PI2-Grupo-8/Estruturas/README.md

# Estruturas
Repositório geral para os arquivos referentes ao subgrupo de Estruturas
