PI2-Grupo-8/Estruturas/Desenhos tecnicos/1 - Vista explodida geral.docx

| Titulo: Vista Explodida Completa | Des.nº: 1/36
| Modelo 3D: André N. Delgado
Brasília – DF | Detalhamento: André N. Delgado | Escala: 1:25
A4 | Revisão: Fernando B. V. Mendes | Unidade: mm
Data: 11/09/2021 | Mat.: | Peso: 100 kg

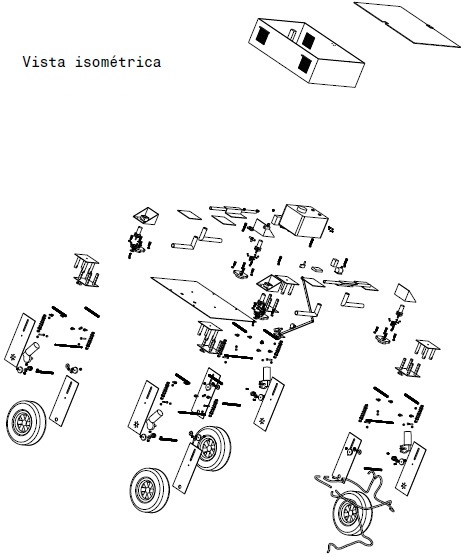
[picture p1: figure]
