PI2-Grupo-8/Estruturas/Desenhos tecnicos/13- Placa conex.docx

| Título: Suporte motor superior e rolamento de mancal | Des.nº: 13 /36
| Modelo 3D: André N. Delgado
Brasília – DF | Detalhamento: André N. Delgado | Escala: 1:3
A4 | Revisão: Fernando B. V. Mendes | Unidade: mm
Data: 08/09/2021 | Mat.: Aço 1020 | Peso: 1,085 kg

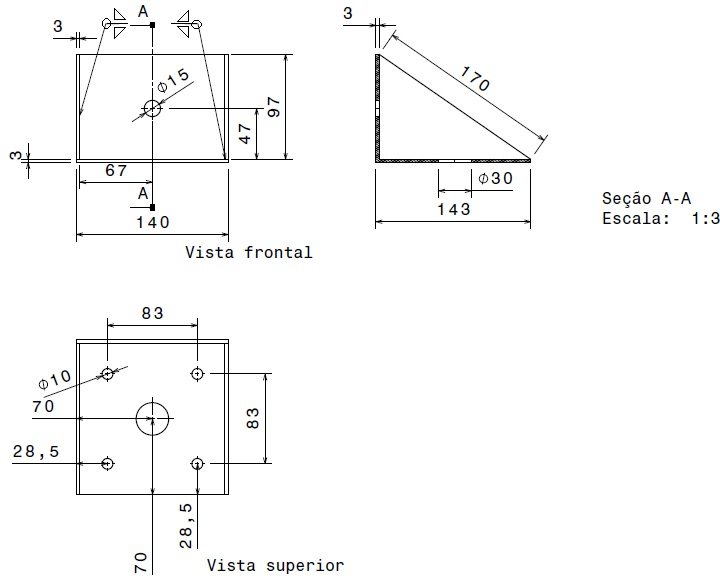
[picture p2: figure]
