PI2-Grupo-8/Estruturas/Desenhos tecnicos/14 - Suporte do motor superiro.docx

| Título: Suporte do motor superior | Des.nº: 14 /36
| Modelo 3D: André N. Delgado
Brasília – DF | Detalhamento: André N. Delgado | Escala: 1:1
A4 | Revisão: Fernando B. V. Mendes | Unidade: mm
Data: 08/09/2021 | Mat.: Aço 1020 | Peso: 63 g

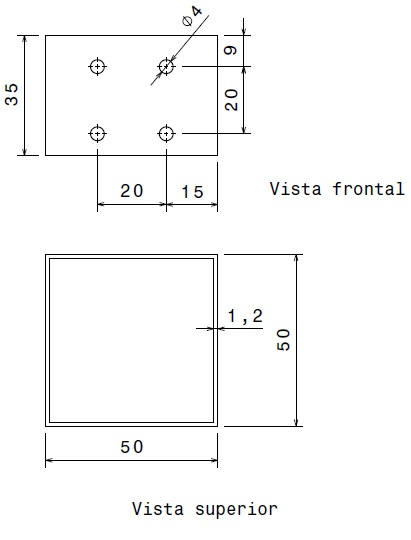
[picture p3: figure]
