PI2-Grupo-8/Estruturas/Desenhos tecnicos/19- Suporte novo externo.docx

| Título: Suporte da roda e motor (lado externo) | Des.nº: 19/36
| Modelo 3D: André N. Delgado
Brasília – DF | Detalhamento: André N. Delgado | Escala: 1:3
A4 | Revisão: Fernando B. V. Mendes | Unidade: mm
Data: 08/09/2021 | Mat.: Aço 1020 | Peso: 1,647 kg

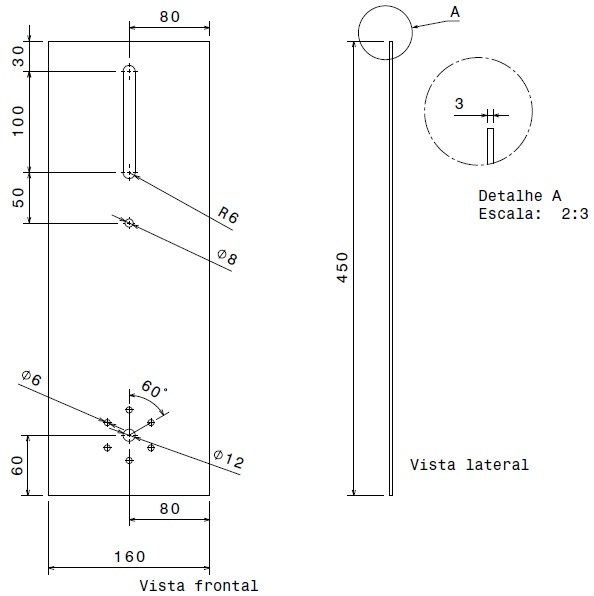
[picture p4: figure]
