PI2-Grupo-8/Estruturas/Desenhos tecnicos/20- Suporte novo interno.docx

| Título: Suporte da roda (lado interno) | Des.nº: 20/36
| Modelo 3D: André N. Delgado
Brasília – DF | Detalhamento: André N. Delgado | Escala: 1:3
A4 | Revisão: Fernando B. V. Mendes | Unidade: mm
Data: 08/09/2021 | Mat.: Aço 1020 | Peso: 1,538 kg

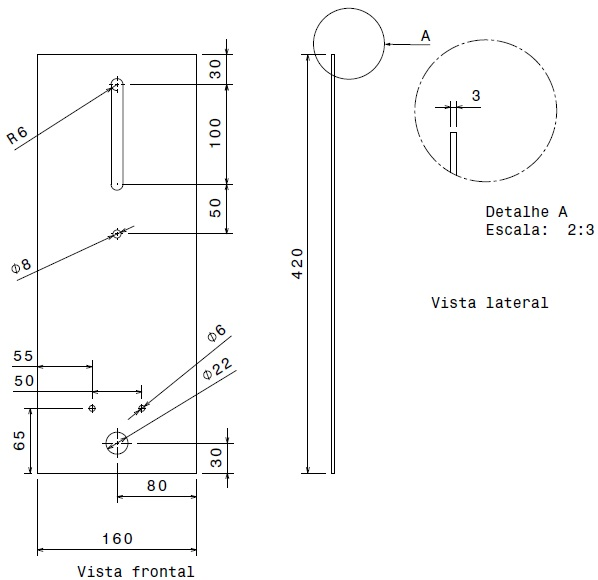
[picture p6: figure]
