PI2-Grupo-8/Estruturas/Desenhos tecnicos/25 - Chapa de fixação da valvula solenoide.docx

| Título: Chapa de fixação da válvula solenoide | Des.nº: 25/36
| Modelo 3D: André N. Delgado
Brasília – DF | Detalhamento: André N. Delgado | Escala: 1:1
A4 | Revisão: Fernando B. V. Mendes | Unidade: mm
Data: 08/09/2021 | Mat.: Aço 1020 | Peso: 9 g

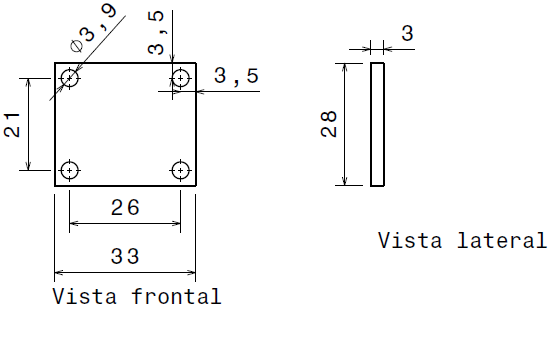
[picture p7: figure]
