PI2-Grupo-8/Estruturas/Desenhos tecnicos/27 - Case das baterias (base).docx

| Título: Case das baterias (base) | Des.nº: 27/36
| Modelo 3D: André N. Delgado
Brasília – DF | Detalhamento: André N. Delgado | Escala: 1:3
A4 | Revisão: Fernando B. V. Mendes | Unidade: mm
Data: 30/09/2021 | Mat.: Nylon | Peso: 418 g

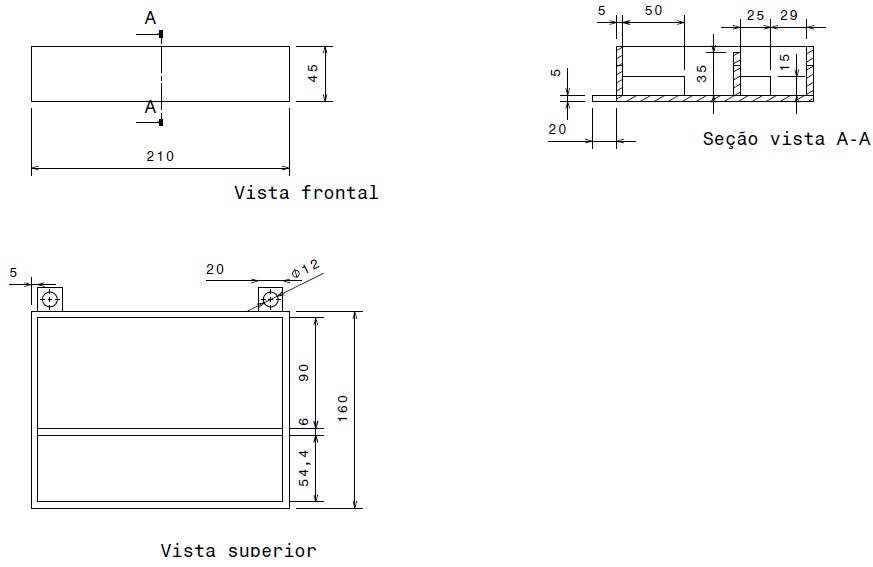
[picture p8: figure]
