PI2-Grupo-8/Estruturas/Desenhos tecnicos/28 - Case das baterias (tampa).docx

| Título: Case das baterias (tampa) | Des.nº: 28/36
| Modelo 3D: André N. Delgado
Brasília – DF | Detalhamento: André N. Delgado | Escala: 1:3
A4 | Revisão: Fernando B. V. Mendes | Unidade: mm
Data: 02/10/2021 | Mat.: Nylon | Peso: 227 g

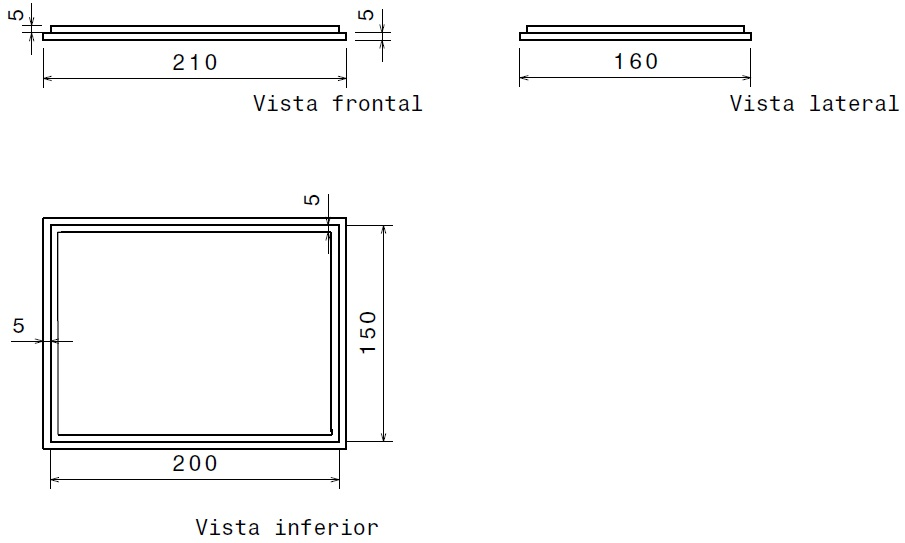
[picture p9: figure]
