PI2-Grupo-8/Estruturas/Desenhos tecnicos/29 - Capa do sensor ultrassônico (base).docx

| Título: Capa do sensor ultrassônico (base) | Des.nº: 29/36
| Modelo 3D: André N. Delgado
Brasília – DF | Detalhamento: André N. Delgado | Escala: 1:1
A4 | Revisão: Fernando B. V. Mendes | Unidade: mm
Data: 02/10/2021 | Mat.: Nylon | Peso: 16 g

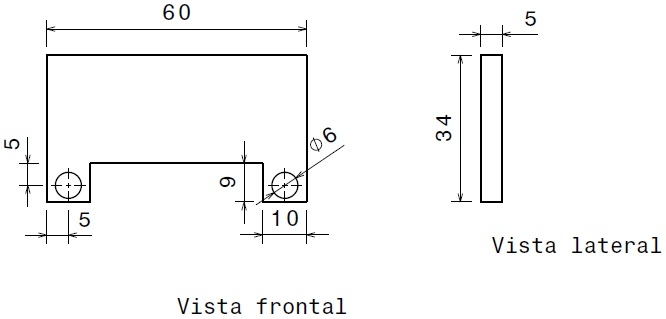
[picture p10: figure]
