PI2-Grupo-8/Estruturas/Desenhos tecnicos/30 - Capa do sensor ultrassônico (tampa).docx

| Título: Capa do sensor ultrassônico (tampa) | Des.nº: 30/36
| Modelo 3D: André N. Delgado
Brasília – DF | Detalhamento: André N. Delgado | Escala: 1:1
A4 | Revisão: Fernando B. V. Mendes | Unidade: mm
Data: 02/10/2021 | Mat.: Nylon | Peso: 3 g

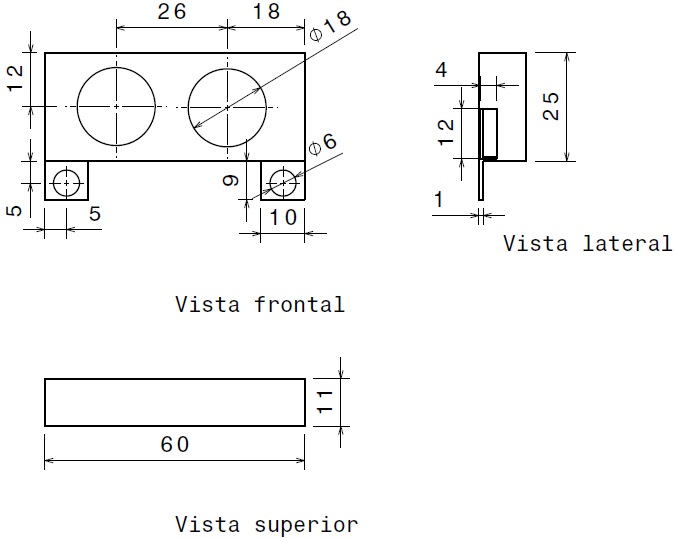
[picture p12: figure]
