PI2-Grupo-8/Estruturas/Desenhos tecnicos/35 - Capa do motor superior.docx

| Título: Capa do motor superior | Des.nº: 35/36
| Modelo 3D: André N. Delgado
Brasília – DF | Detalhamento: André N. Delgado | Escala: 1:3
A4 | Revisão: Fernando B. V. Mendes | Unidade: mm
Data: 07/10/2021 | Mat.: Nylon | Peso: 6 g

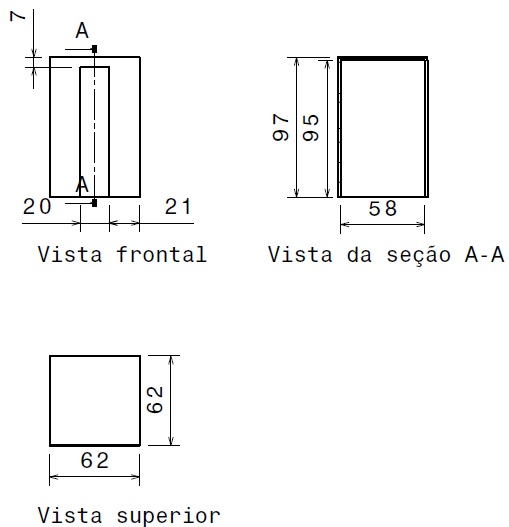
[picture p13: figure]
