PI2-Grupo-8/Estruturas/Desenhos tecnicos/36 - Chapa de contagem de voltas da roda.docx

| Título: Chapa de contagem das voltas da roda | Des.nº: 36/36
| Modelo 3D: André N. Delgado
Brasília – DF | Detalhamento: André N. Delgado | Escala: 1:1
A4 | Revisão: Fernando B. V. Mendes | Unidade: mm
Data: 08/10/2021 | Mat.: Alumínio 6061 | Peso: 5 g

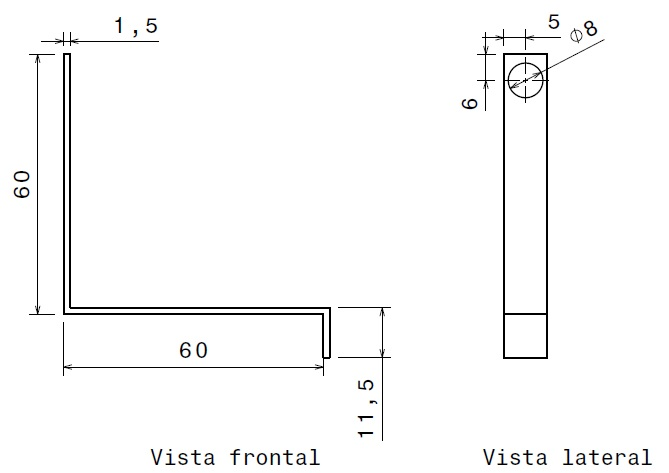
[picture p14: figure]
