PI2-Grupo-8/Estruturas/Desenhos tecnicos/4 - Capa protetora.docx

| Titulo: Capa protetora | Des.nº: 4/36
| Modelo 3D: André N. Delgado
Brasília – DF | Detalhamento: André N. Delgado | Escala: 1:10
A4 | Revisão: Fernando B. V. Mendes | Unidade: mm
Data: 08/09/2021 | Mat.: Plástico (Nylon) | Peso: 4 kg

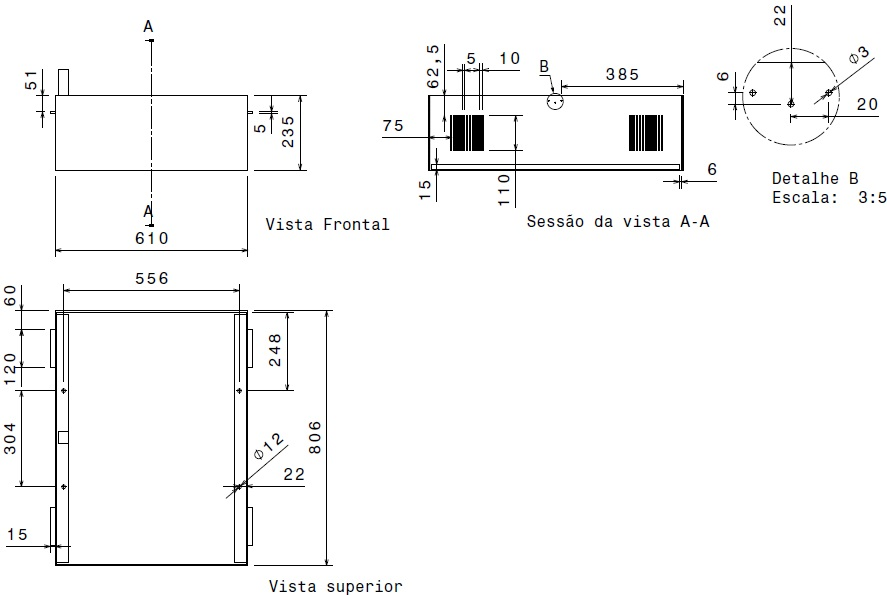
[picture p15: figure]
