PI2-Grupo-8/Estruturas/Desenhos tecnicos/dt-pdf/27 - Case das baterias (base).pdf

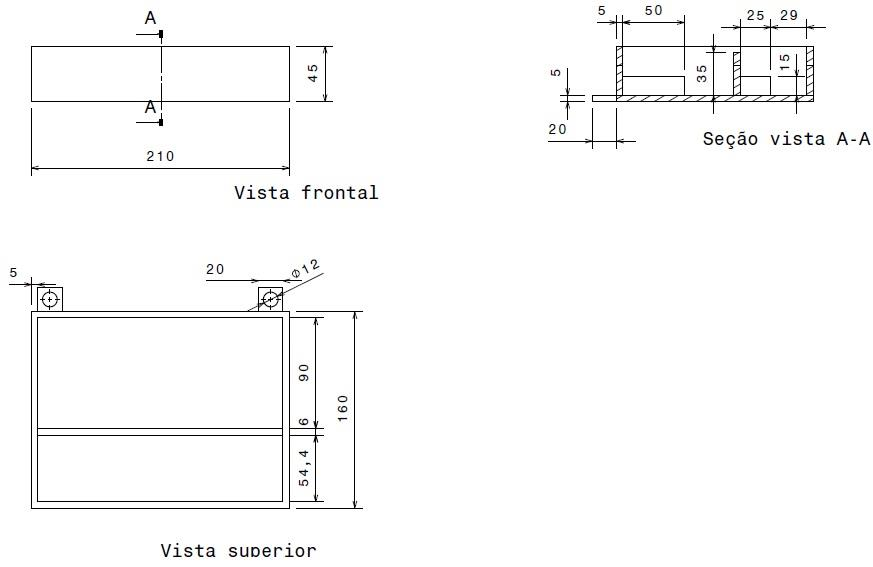
[picture p16: figure]

| Título : Case das baterias (base) | Des.nº: 2 7 /36
| Modelo 3D: André N. Delgado
Brasília – DF | Detalhamento: André N. Delgado | Es c ala: 1 : 3
A4 | Revisão: Fernando B. V. Mendes | Unidade: mm
Data: 3 0/09/2021 | Mat.: Nylon | Peso: 418 g
