PI2-Grupo-8/Estruturas/Desenhos tecnicos/dt-pdf/35 - Capa do motor superior.pdf

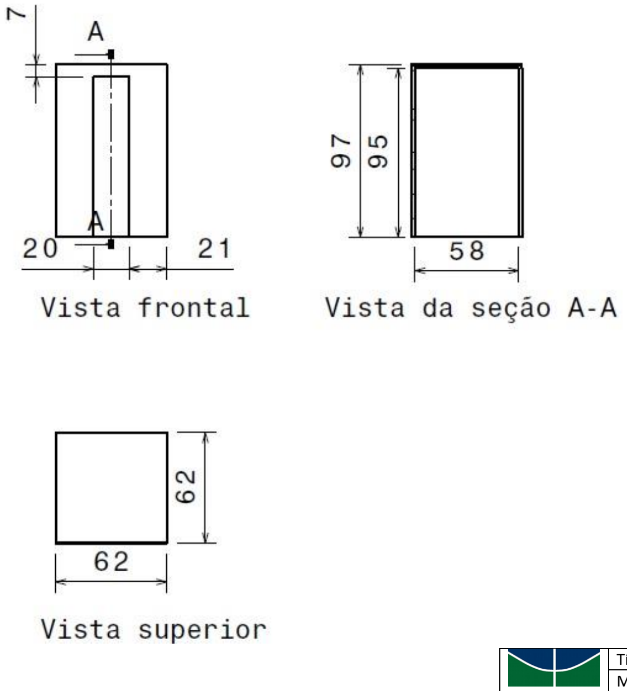
[picture p17: figure]

| Título : Capa do motor superior | Des.nº: 3 5 / 3 6
| Modelo 3D: André N. Delgado
Brasília – DF | Detalhamento: André N. Delgado | Es c ala: 1 : 3
A4 | Revisão: Fernando B. V. Mendes | Unidade: mm
Data: 0 7 /10/2021 | Mat.: Nylon | Peso: 6 g
