PI2-Grupo-8/Estruturas/Desenhos tecnicos/10- Suporte do aspersor haste.docx

| Título: Suporte do bico do aspersor (haste) | Des.nº: 10 /36
| Modelo 3D: André N. Delgado
Brasília – DF | Detalhamento: André N. Delgado | Escala: 1:3
A4 | Revisão: Fernando B. V. Mendes | Unidade: mm
Data: 08/09/2021 | Mat.: Aço 1020 | Peso: 14 g

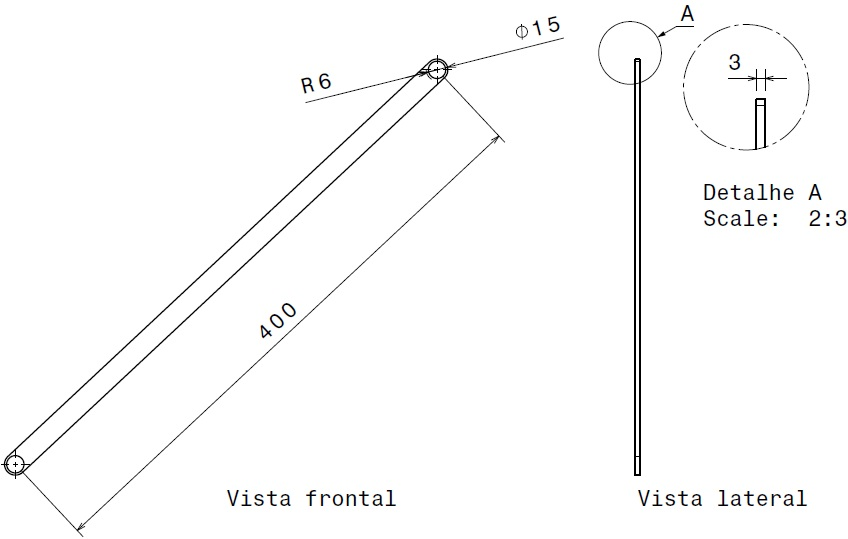
[picture p18: figure]
