PI2-Grupo-8/Estruturas/Desenhos tecnicos/11 -Placa de conexao tubo assoalho.docx

| Título: Chapa de conexão (Braços/Corpo central) | Des.nº: 11 /36
| Modelo 3D: André N. Delgado
Brasília – DF | Detalhamento: André N. Delgado | Escala: 1:3
A4 | Revisão: Fernando B. V. Mendes | Unidade: mm
Data: 08/09/2021 | Mat.: Aço 1020 | Peso: 604 g

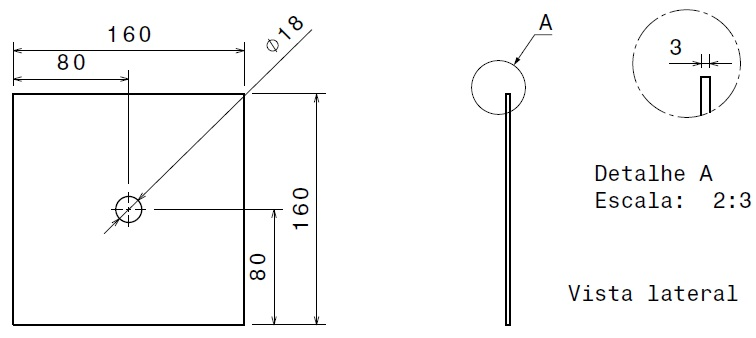
[picture p19: figure]
