PI2-Grupo-8/Estruturas/Desenhos tecnicos/12- Tubo de conexao.docx

| Título: Tubo em L (ligação corpo central/Apoios) | Des.nº: 12/36
| Modelo 3D: André N. Delgado
Brasília – DF | Detalhamento: André N. Delgado | Escala: 1:3
A4 | Revisão: Fernando B. V. Mendes | Unidade: mm
Data: 08/09/2021 | Mat.: Aço 1020 | Peso: 712 g

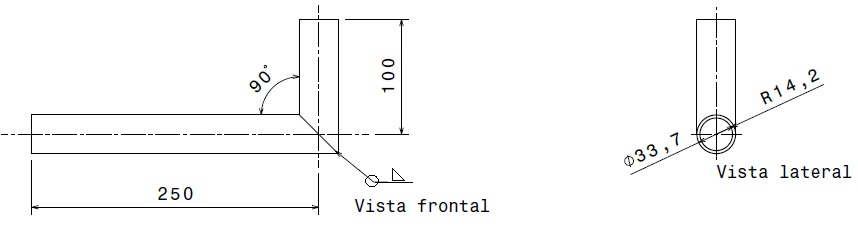
[picture p20: figure]
