PI2-Grupo-8/Estruturas/Desenhos tecnicos/15- Acoplamento de eixo (8 p_ 8).docx

| Titulo: Acoplamento de eixo 8x8 | Des.nº: 15/36
| Modelo 3D: André N. Delgado
Brasília – DF | Detalhamento: André N. Delgado | Escala: 1:1
A4 | Revisão: Fernando B. V. Mendes | Unidade: mm
Data: 08/09/2021 | Mat.: Alumínio | Peso: 25 g

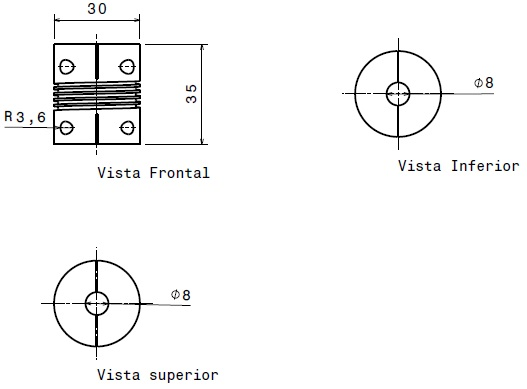
[picture p21: figure]
