PI2-Grupo-8/Estruturas/Desenhos tecnicos/16- Tubos bracos rotativos(apoio telescopico parte de cima).docx

| Título: Suporte telescópio (Parte superior) | Des.nº: 16/36
| Modelo 3D: André N. Delgado
Brasília – DF | Detalhamento: André N. Delgado | Escala: 1:5
A4 | Revisão: Fernando B. V. Mendes | Unidade: mm
Data: 08/09/2021 | Mat.: Aço 1020 | Peso: 866 g

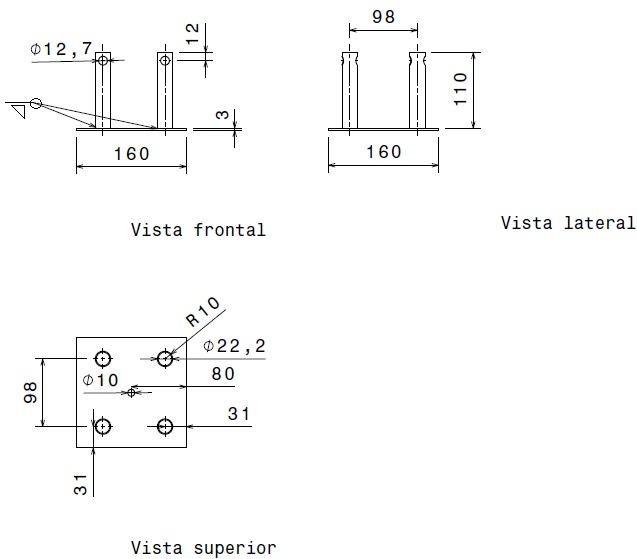
[picture p22: figure]
