PI2-Grupo-8/Estruturas/Desenhos tecnicos/18 -Suporte da barra dos amortecedores.docx

| Título: Suporte da barra de fixação dos amortecedores | Des.nº: 18/36
| Modelo 3D: André N. Delgado
Brasília – DF | Detalhamento: André N. Delgado | Escala: 1:1
A4 | Revisão: Fernando B. V. Mendes | Unidade: mm
Data: 08/09/2021 | Mat.: Aço 1020 | Peso: 102 g

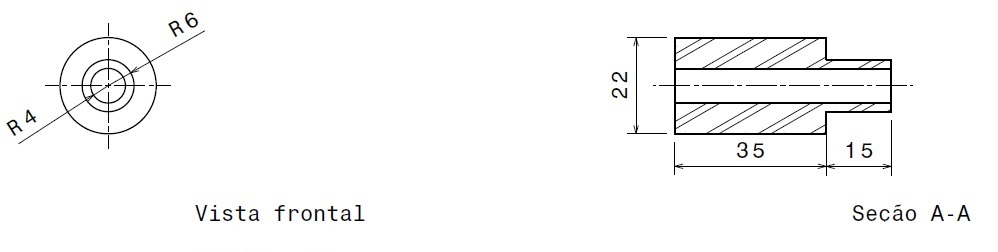
[picture p23: figure]
