PI2-Grupo-8/Estruturas/Desenhos tecnicos/22- Espacador da roda.docx

| Título: Apoio interno ao eixo da roda | Des.nº: 22/36
| Modelo 3D: André N. Delgado
Brasília – DF | Detalhamento: André N. Delgado | Escala: 1:1
A4 | Revisão: Fernando B. V. Mendes | Unidade: mm
Data: 08/09/2021 | Mat.: Aço 1045 | Peso: 163 g

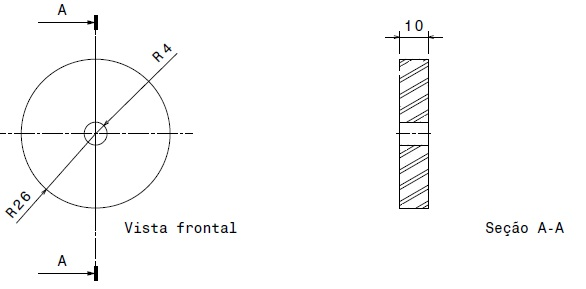
[picture p24: figure]
