PI2-Grupo-8/Estruturas/Desenhos tecnicos/23- Valvula by pass.docx

| Título: Válvula reguladora de pressão (By pass) | Des.nº: 23 /36
| Modelo 3D: André N. Delgado
Brasília – DF | Detalhamento: André N. Delgado | Escala: 1:1
A4 | Revisão: Fernando B. V. Mendes | Unidade: mm
Data: 08/09/2021 | Mat.: Alumínio | Peso: 20 g

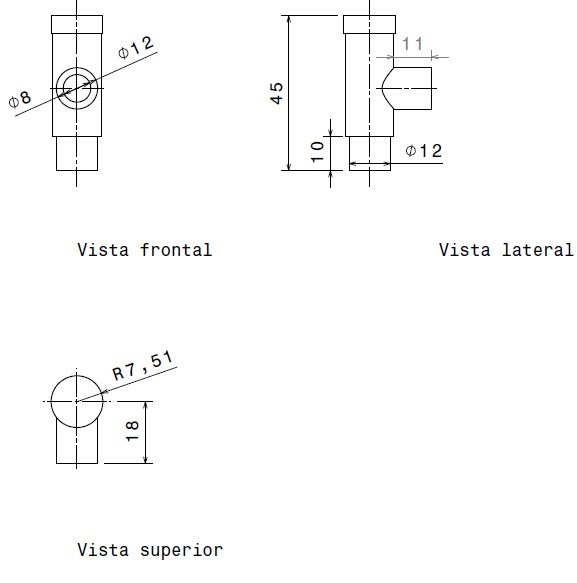
[picture p25: figure]
