PI2-Grupo-8/Estruturas/Desenhos tecnicos/24- Valvula reguladora de vazao.docx

| Título: Válvula reguladora de vazão | Des.nº: 24/36
| Modelo 3D: André N. Delgado
Brasília – DF | Detalhamento: André N. Delgado | Escala: 1:1
A4 | Revisão: Fernando B. V. Mendes | Unidade: mm
Data: 08/09/2021 | Mat.: Alumínio | Peso: 40 g

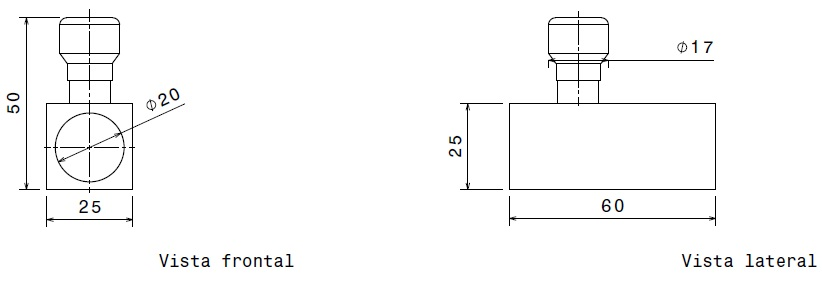
[picture p26: figure]
