PI2-Grupo-8/Estruturas/Desenhos tecnicos/26 - Cinta de  de fixação do tanque.docx

| Título: Chapa de fixação do tanque | Des.nº: 25/36
| Modelo 3D: André N. Delgado
Brasília – DF | Detalhamento: André N. Delgado | Escala: 1:5
A4 | Revisão: Fernando B. V. Mendes | Unidade: mm
Data: 30/09/2021 | Mat.: Aço 1020 | Peso: 60 g

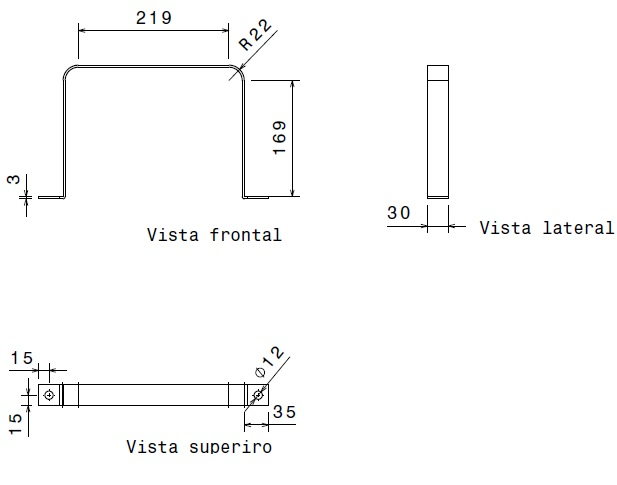
[picture p27: figure]
