PI2-Grupo-8/Estruturas/Desenhos tecnicos/33 - Suporte da camera (adaptador).docx

| Título: Suporte da câmera (adaptador) | Des.nº: 33/36
| Modelo 3D: André N. Delgado
Brasília – DF | Detalhamento: André N. Delgado | Escala: 1:1
A4 | Revisão: Fernando B. V. Mendes | Unidade: mm
Data: 07/10/2021 | Mat.: Alumínio 6061 | Peso: 1 g

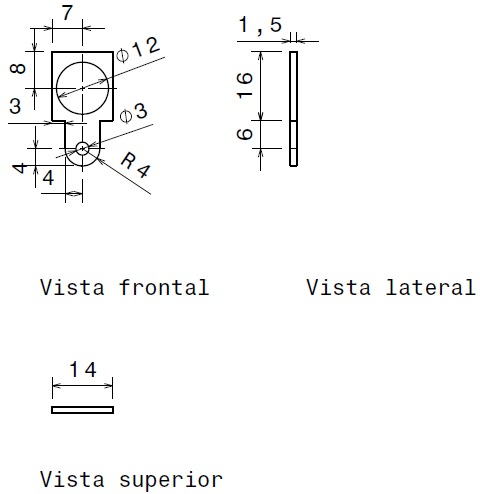
[picture p28: figure]
