PI2-Grupo-8/Estruturas/Desenhos tecnicos/34 - Suporte da camera (Chapa dobrada).docx

| Título: Suporte da câmera (Chapa dobrada) | Des.nº: 34/36
| Modelo 3D: André N. Delgado
Brasília – DF | Detalhamento: André N. Delgado | Escala: 1:1
A4 | Revisão: Fernando B. V. Mendes | Unidade: mm
Data: 07/10/2021 | Mat.: Alumínio 6061 | Peso: 12 g

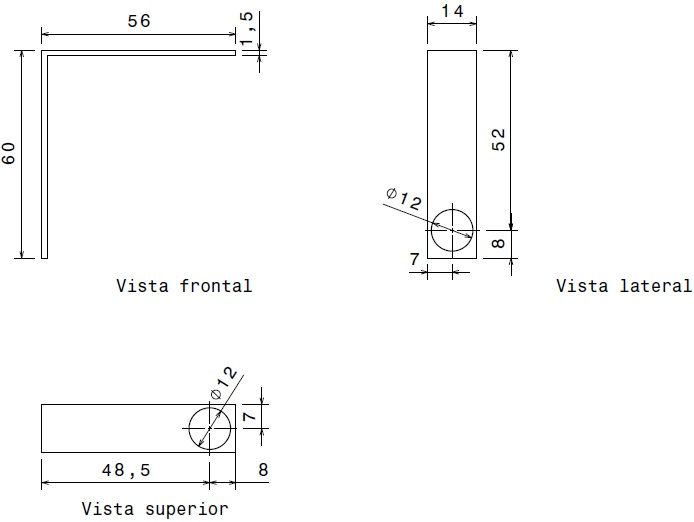
[picture p29: figure]
