PI2-Grupo-8/Estruturas/Desenhos tecnicos/9- Suporte do aspersor base do aspersor.jpg.docx

| Título: Suporte do bico do aspersor (placa) | Des.nº: 9/36
| Modelo 3D: André N. Delgado
Brasília – DF | Detalhamento: André N. Delgado | Escala: 1:1
A4 | Revisão: Fernando B. V. Mendes | Unidade: mm
Data: 08/09/2021 | Mat.: Aço 1020 | Peso: 127 g

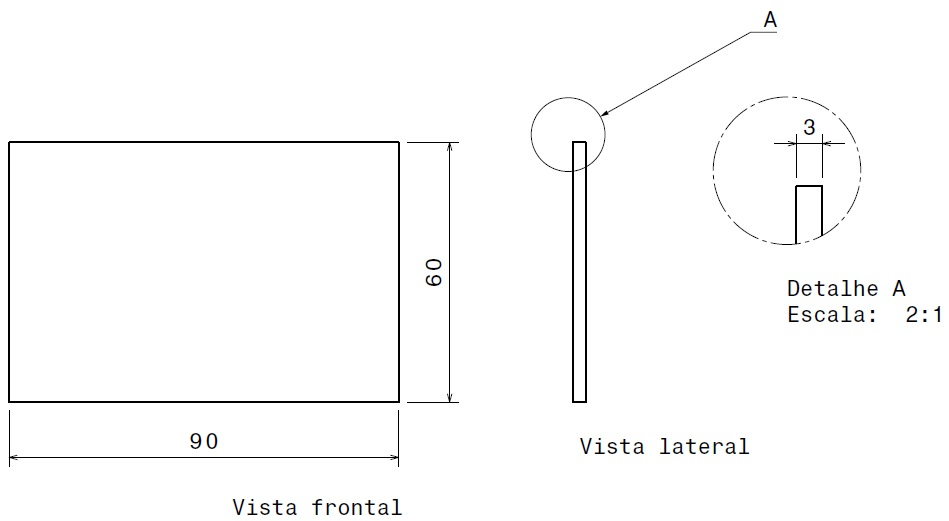
[picture p31: figure]
