PI2-Grupo-8/Estruturas/Desenhos tecnicos/dt-pdf/17- Apoio telescopico parte de baixo.pdf

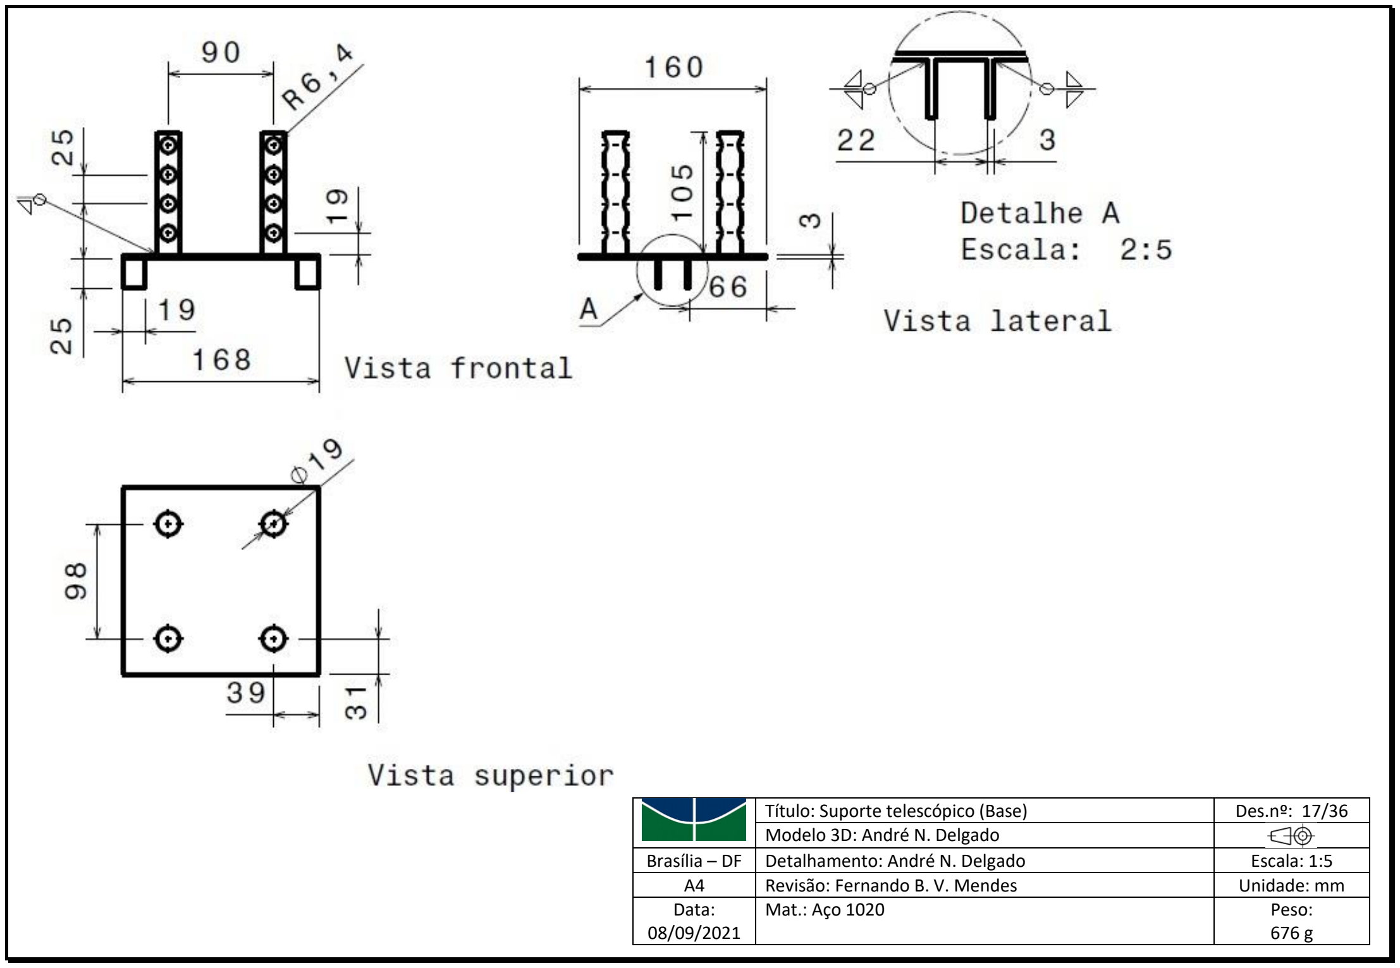
[picture p32: page 1]

| Título : Suporte telescópico (Base) | Des.nº: 17 /36
| Modelo 3D: André N. Delgado
Brasília – DF | Detalhamento: André N. Delgado | Es c ala: 1 : 5
A4 | Revisão: Fernando B. V. Mendes | Unidade: mm
Data: 08/09/2021 | Mat.: Aço 1020 | Peso: 676 g
