PI2-Grupo-8/Estruturas/Desenhos tecnicos/dt-pdf/5- Tampa da capa protetora.pdf

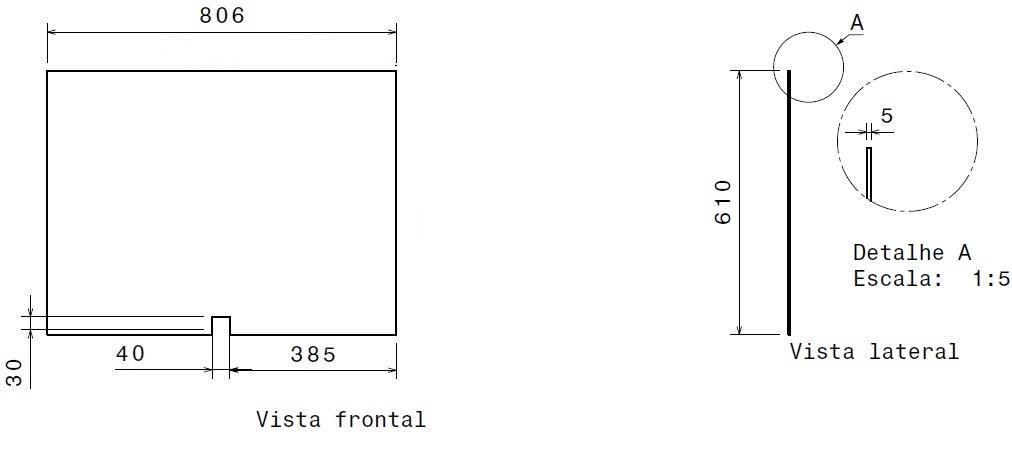
[picture p33: figure]

| Título : Tampa da capa protetora | Des.nº: 5 /36
| Modelo 3D: André N. Delgado
Brasília – DF | Detalhamento: André N. Delgado | Es c ala: 1 : 1 0
A4 | Revisão: Fernando B. V. Mendes | Unidade: mm
Data: 08/09/2021 | Mat.: Plástico (Nylon) | Peso: 800 g
