PI2-Grupo-8/Estruturas/Desenhos tecnicos/dt-pdf/8- Suporte do aspersor (Base e aspersor).pdf

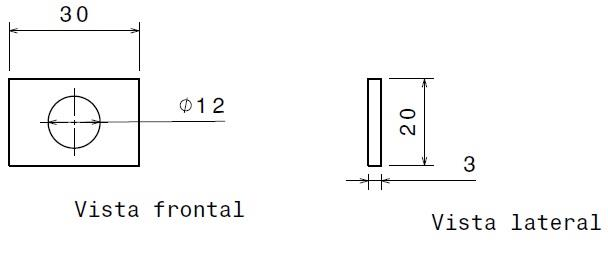
[picture p34: figure]

| Título : Suporte do aspersor | Des.nº: 8 /36
| Modelo 3D: André N. Delgado
Brasília – DF | Detalhamento: André N. Delgado | Es c ala: 1 : 1
A4 | Revisão: Fernando B. V. Mendes | Unidade: mm
Data: 08/09/2021 | Mat.: Aço 1020 | Peso: 16 g
