PI2-Grupo-8/Estruturas/Produção/1- Capa de proteção/Capa de protecao.png

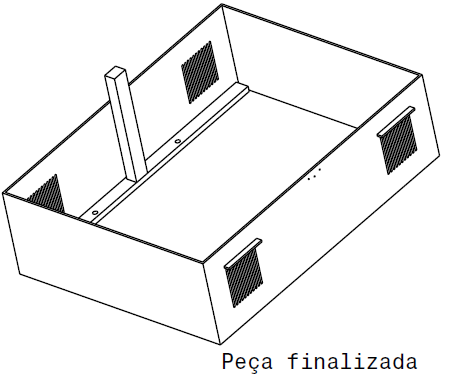
Produção/1- Capa de proteção/Capa de protecao.png
