PI2-Grupo-8/Estruturas/Produção/2- Tampa da caixa/Tampa da capa protetora.png

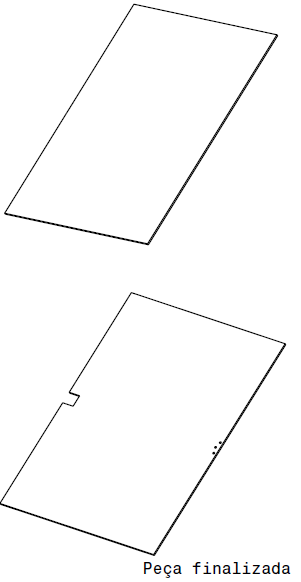
Produção/2- Tampa da caixa/Tampa da capa protetora.png
