PI2-Grupo-8/Estruturas/Produção/3- Capa do sensor ultrassonico/Capa do sensor ultrassonico (base e tampa)(1).png

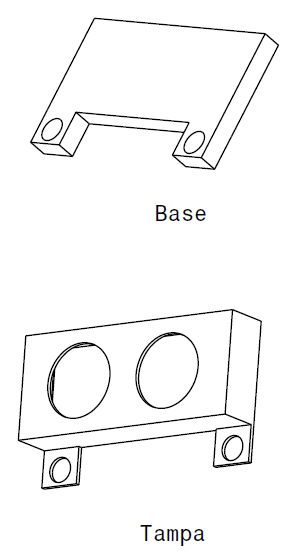
Produção/3- Capa do sensor ultrassonico/Capa do sensor ultrassonico (base e tampa)(1).png
