PI2-Grupo-8/Estruturas/Produção/4- Case das baterias/Case das baterias (base e tampa)(1).png

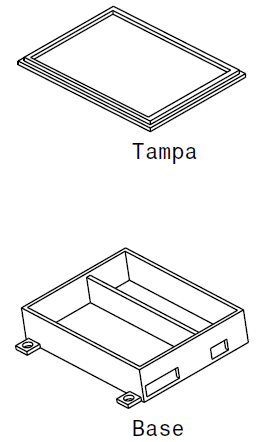
Produção/4- Case das baterias/Case das baterias (base e tampa)(1).png
