PI2-Grupo-8/Estruturas/Produção/5- Chapa central/Chapa central.png

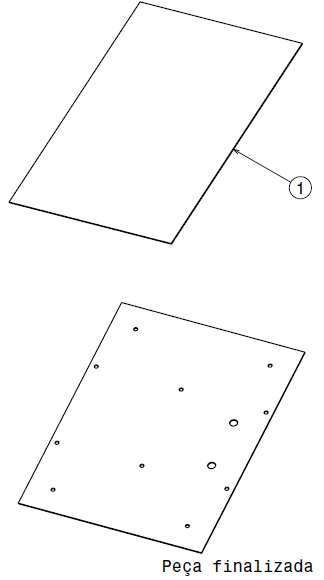
Produção/5- Chapa central/Chapa central.png
