PI2-Grupo-8/Estruturas/Produção/6- Apoio telescópico (parte superior)/Apoio telescopico (parte superior)(1).png

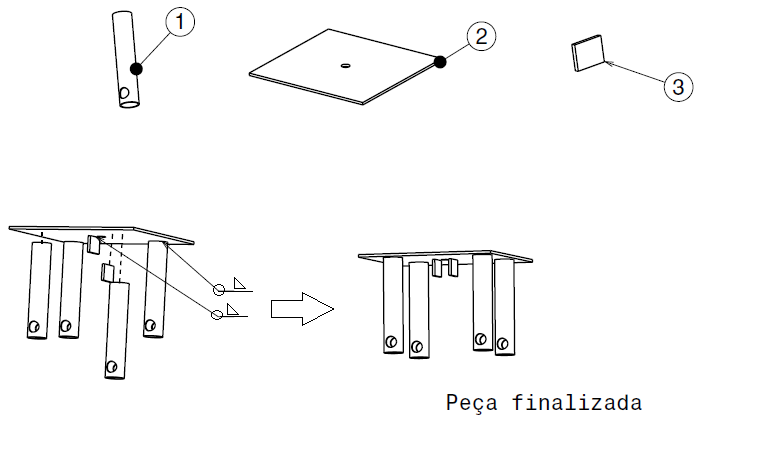
Produção/6- Apoio telescópico (parte superior)/Apoio telescopico (parte superior)(1).png
