PI2-Grupo-8/Estruturas/Produção/7- Suporte e espaçador do amortecedor/Suporte de fixacao do amortecedor e espacador do amortecedor.png

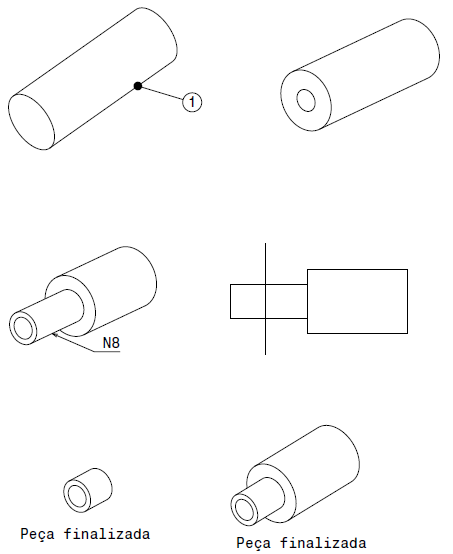
Produção/7- Suporte e espaçador do amortecedor/Suporte de fixacao do amortecedor e espacador do amortecedor.png
