PI2-Grupo-8/Estruturas/Produção/9- Espaçador da roda/Espacador da roda.png

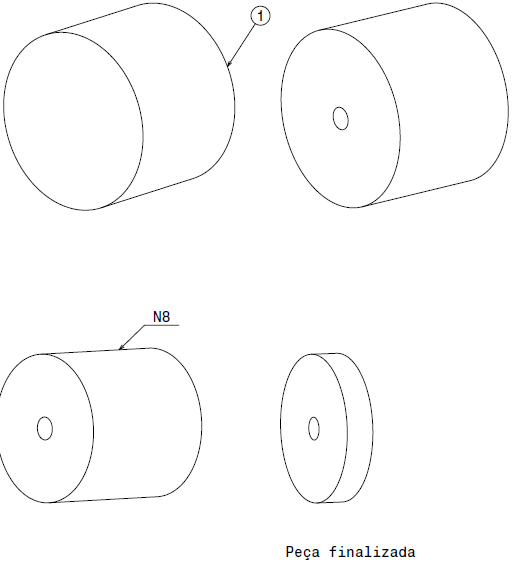
Produção/9- Espaçador da roda/Espacador da roda.png
