PI2-Grupo-8/Estruturas/Produção/10- Chapinhas para o suporte do aspersor/Chapinhas para o suporte do aspersor.png

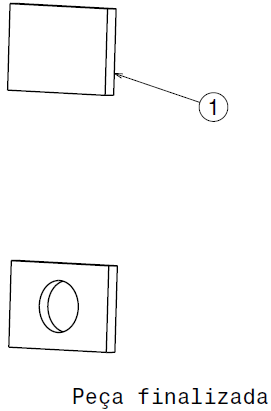
Produção/10- Chapinhas para o suporte do aspersor/Chapinhas para o suporte do aspersor.png
