PI2-Grupo-8/Estruturas/Produção/11- Haste do suporte do aspersor/Haste do aspersor.png

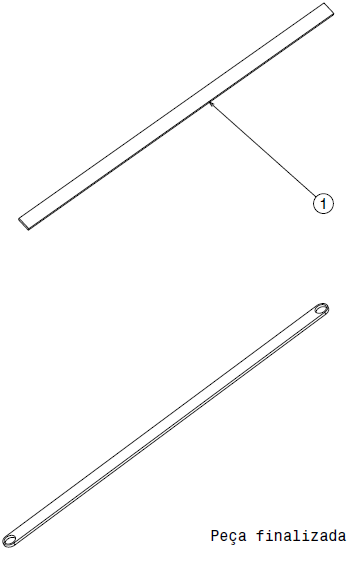
Produção/11- Haste do suporte do aspersor/Haste do aspersor.png
