PI2-Grupo-8/Estruturas/Produção/12- Plca de conexão (suporte do motor superiro)/Suporte do motor superior (perfil quadrado cortado)(1).png

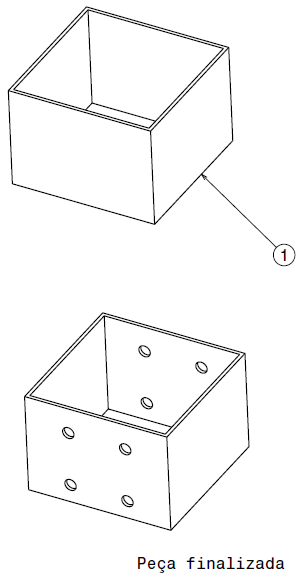
Produção/12- Plca de conexão (suporte do motor superiro)/Suporte do motor superior (perfil quadrado cortado)(1).png
