PI2-Grupo-8/Estruturas/Produção/13- Placa de conexão/placa conexao.png

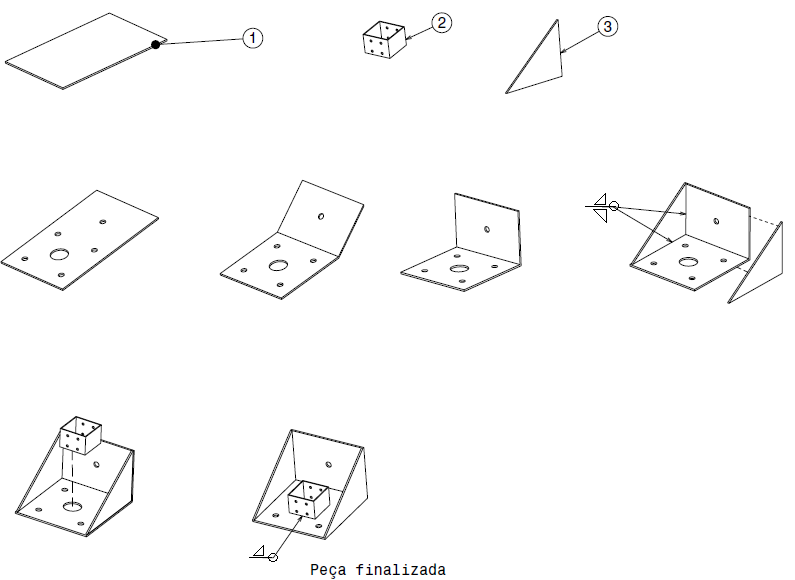
Produção/13- Placa de conexão/placa conexao.png
