PI2-Grupo-8/Estruturas/Produção/16- Suporte de transporte/Suporte de transporte.png

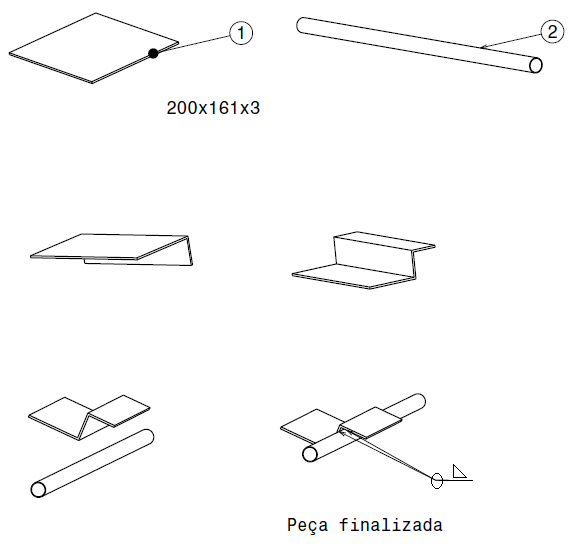
Produção/16- Suporte de transporte/Suporte de transporte.png
