PI2-Grupo-8/Estruturas/Produção/17- Suporte externo/Suporte do motor e roda (externo)(1).png

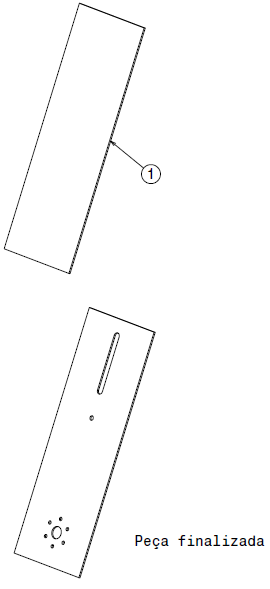
Produção/17- Suporte externo/Suporte do motor e roda (externo)(1).png
