PI2-Grupo-8/Estruturas/Produção/18- Suporte interno/Suporte da roda (interno)(1).png

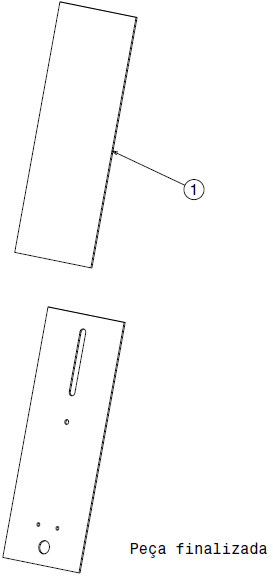
Produção/18- Suporte interno/Suporte da roda (interno)(1).png
