PI2-Grupo-8/Estruturas/Produção/19- Tubo em L/Tubo em L.png

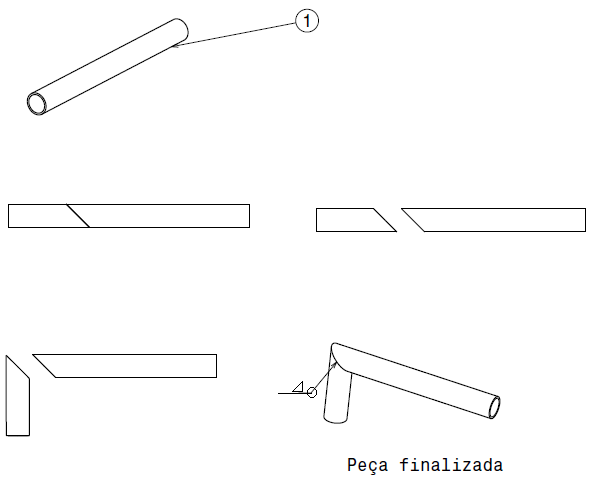
Produção/19- Tubo em L/Tubo em L.png
