PI2-Grupo-8/Estruturas/Produção/20- Chapa de fixacão do tanque/Chapa de fixacao do tanque.png

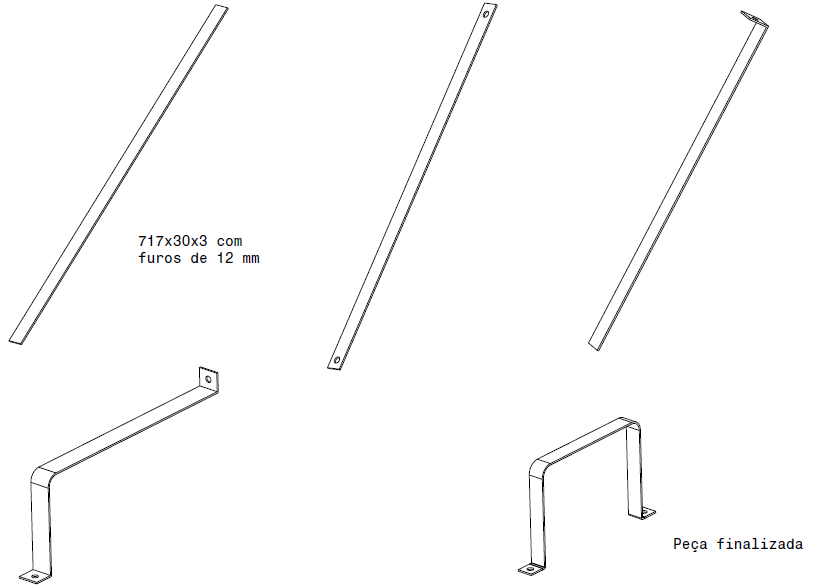
Produção/20- Chapa de fixacão do tanque/Chapa de fixacao do tanque.png
