PI2-Grupo-8/Estruturas/Produção/21- Suporte da solenoide/Suporte da solenoide.png

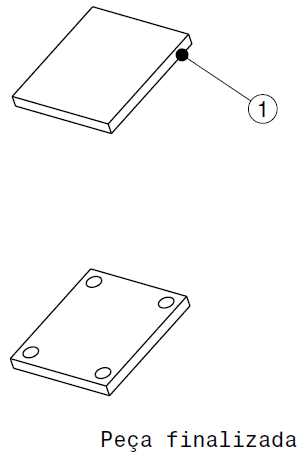
Produção/21- Suporte da solenoide/Suporte da solenoide.png
