PI2-Grupo-8/Estruturas/Produção/22- Suporte da camera/Suporte da camera 80x50x3 com furos 12mm.png

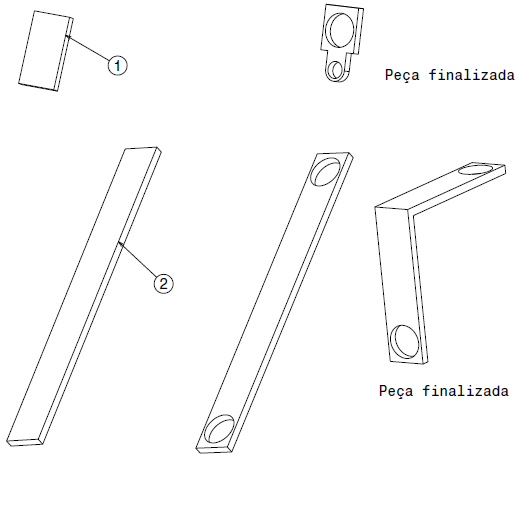
Produção/22- Suporte da camera/Suporte da camera 80x50x3 com furos 12mm.png
