PI2-Grupo-8/Estruturas/Produção/24 - Capa de proteção do motor superior/capa do motor superior.png

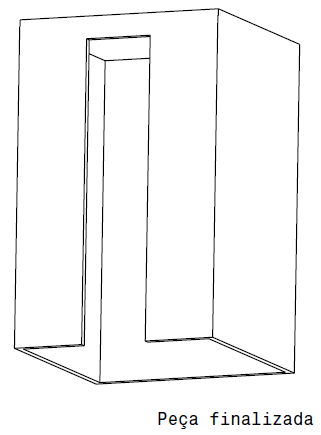
Produção/24 - Capa de proteção do motor superior/capa do motor superior.png
