PI2-Grupo-8/Estruturas/Produção/25 - Chapa para contagem de voltas da roda/Chapa para contagem de voltas da roda.png

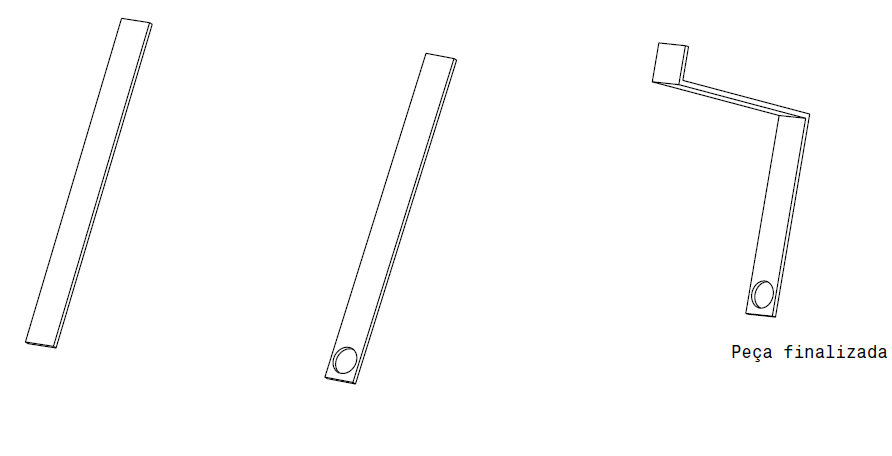
Produção/25 - Chapa para contagem de voltas da roda/Chapa para contagem de voltas da roda.png
