PI2-Grupo-8/Estruturas/Lista de ferramenstas-componentes e EPI_s/Lista de equipamentos para produção das peças e epis.docx

Lista de equipamentos para produção das peças:

- Maquina de corte a laser ou jato d’água
- Serra fita ou Serra tico-tico ou Cortadora do tipo rotativa
- Maquina para solda do tipo MIG/MAG
- Furadeira de bancada
- Brocas de Aço rápido (4mm, 8mm e 12mm)
- Torno mecânico (pode ser de bancada)
- Dobradeira de chapa (manual ou automática. Superior a 200mm de largura)
- Esmerilhadeira ou Jogo de limas
- Lixa ferro grão variados
- Paquímetro
- Esquadro metálico
- Caneta marcadora

Lista dos principais EPI´s para a fabricação:

- Máscara de solda
- Luva de soldagem
- Avental de raspa ou couro para soldagem
- Óculos de proteção
- Botas com bico metálico
- Luvas de borracha
- Tampões de ouvido
- Face shield
