PI2-Grupo-8/Estruturas/Desenhos tecnicos/31 - Suporte dos componentes eletronicos (base).docx

| Título: Suporte dos componentes eletrônicos (base) | Des.nº: 31/36
| Modelo 3D: André N. Delgado
Brasília – DF | Detalhamento: André N. Delgado | Escala: 1:3
A4 | Revisão: Fernando B. V. Mendes | Unidade: mm
Data: 06/10/2021 | Mat.: Nylon | Peso: 184 g

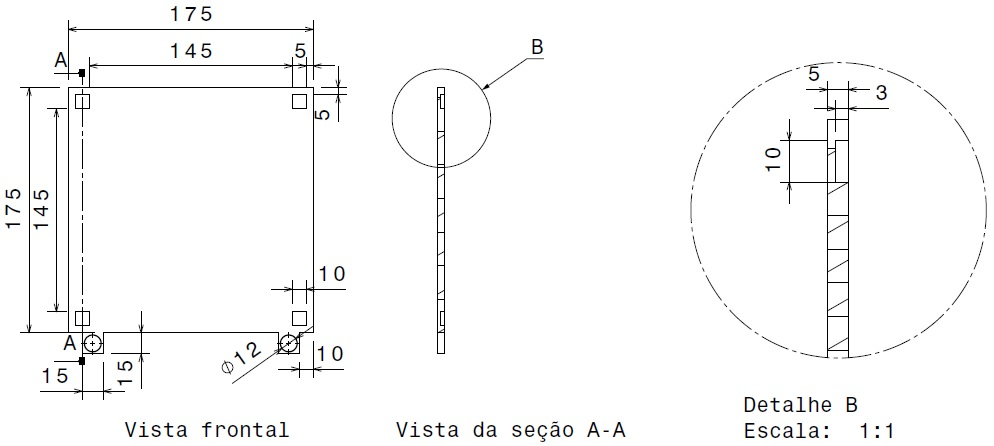
[picture p59: figure]
