PI2-Grupo-8/Estruturas/Desenhos tecnicos/32 - Suporte dos componentes eletronicos (modular).docx

| Título: Suporte dos componentes eletrônicos (modular) | Des.nº: 32/36
| Modelo 3D: André N. Delgado
Brasília – DF | Detalhamento: André N. Delgado | Escala: 1:3
A4 | Revisão: Fernando B. V. Mendes | Unidade: mm
Data: 06/10/2021 | Mat.: Nylon | Peso: 200 g

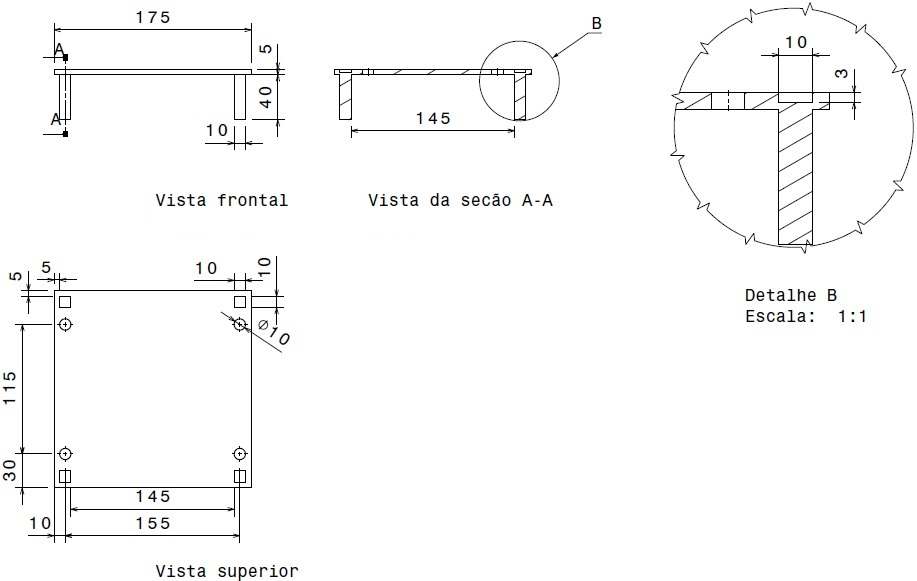
[picture p60: figure]
