PI2-Grupo-8/Estruturas/Imagens do manual/44  Suporte dos componentes eletronicos pecas.png

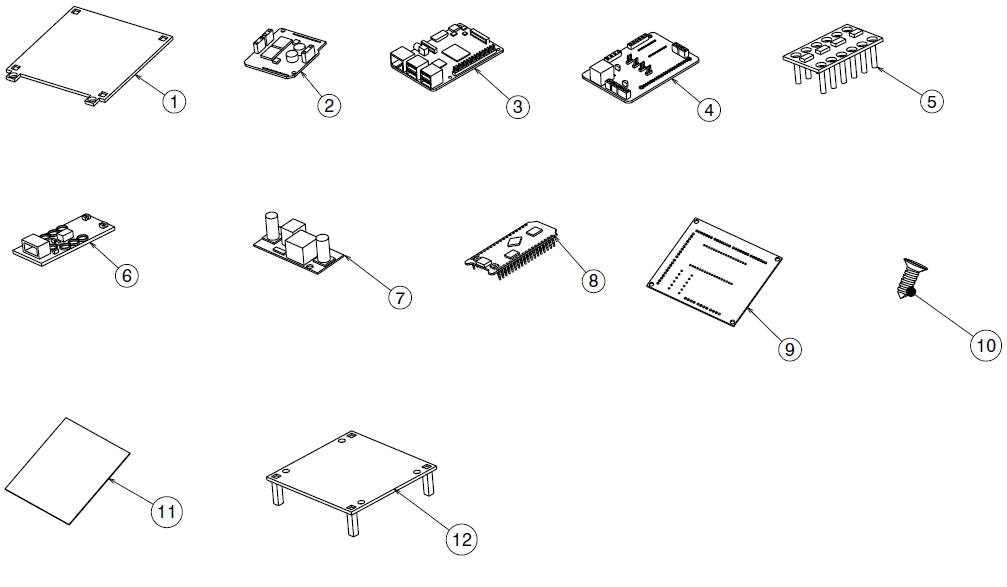
Imagens do manual/44 Suporte dos componentes eletronicos pecas.png
