PI2-Grupo-8/Estruturas/Imagens do manual/45 Suporte dos componentes eletronicos base e componentes.png

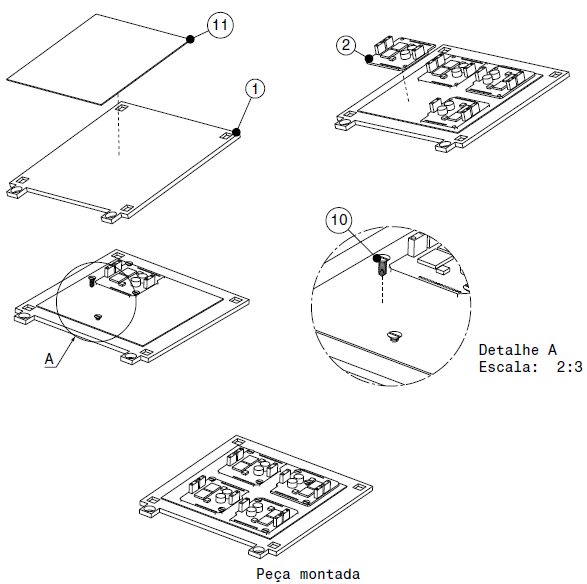
Imagens do manual/45 Suporte dos componentes eletronicos base e componentes.png
