PI2-Grupo-8/Estruturas/Imagens do manual/46 Suporte dos componentes eletronicos modular e componentes.png

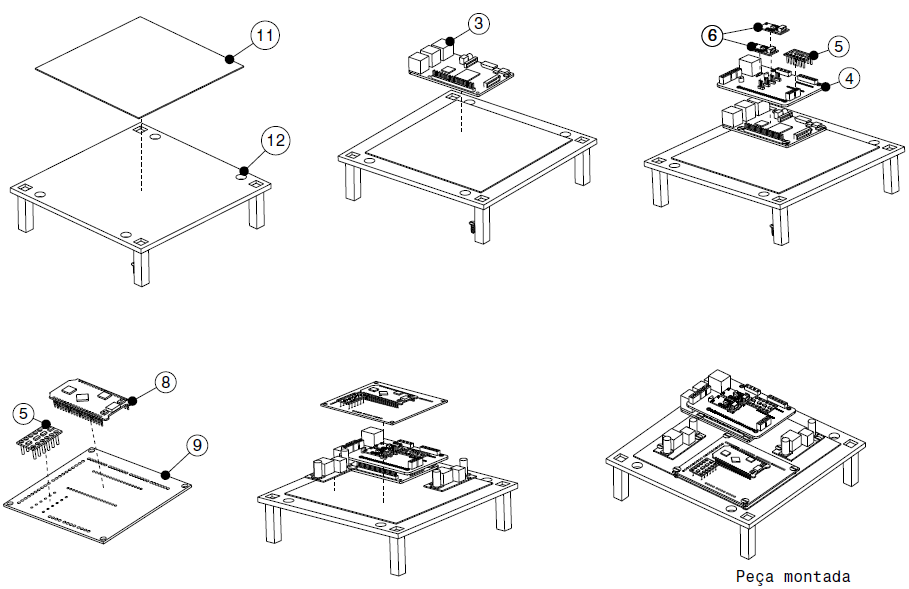
Imagens do manual/46 Suporte dos componentes eletronicos modular e componentes.png
