PI2-Grupo-8/Estruturas/Imagens do manual/47 Suporte dos componentes eletronicos montado.png

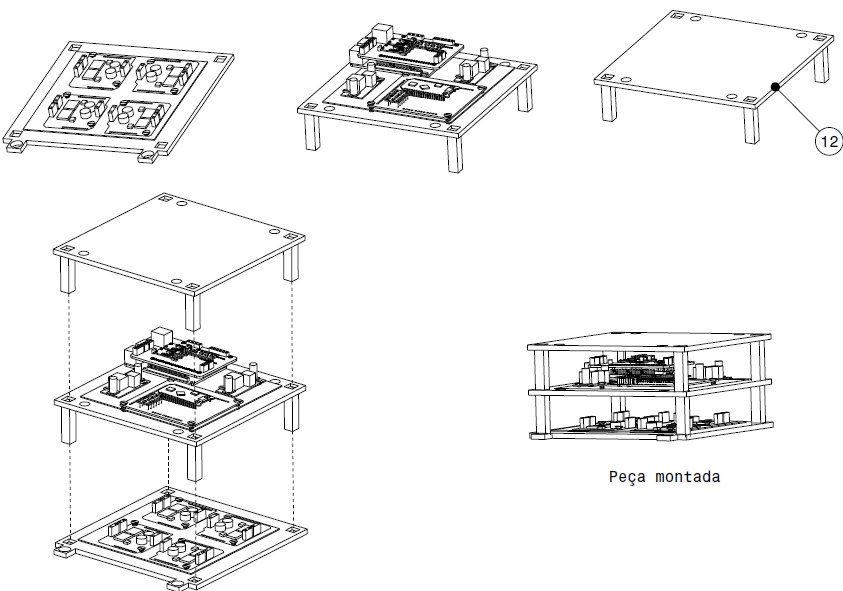
Imagens do manual/47 Suporte dos componentes eletronicos montado.png
