PI2-Grupo-8/Estruturas/Imagens do manual/49 Canaletas e componentes eletronicos na estrutura base.png

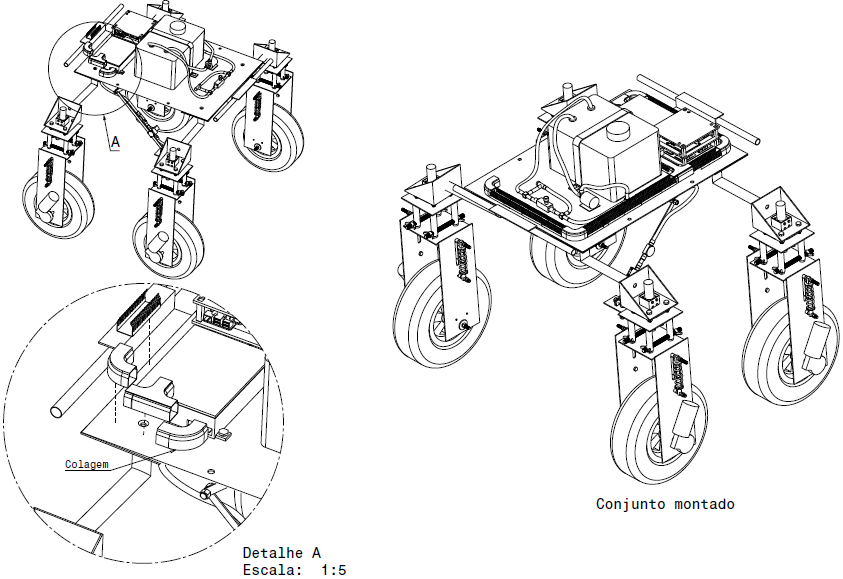
Imagens do manual/49 Canaletas e componentes eletronicos na estrutura base.png
