PI2-Grupo-8/Estruturas/Produção/23- Suporte dos componentes eletronicos/Suporte dos componentes eletronicos.png

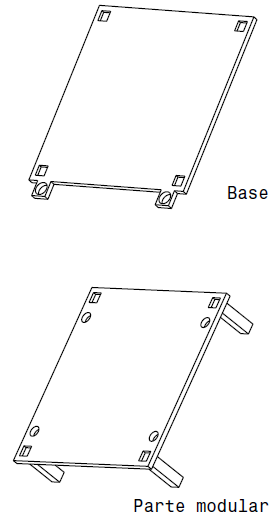
Produção/23- Suporte dos componentes eletronicos/Suporte dos componentes eletronicos.png
