PI2-Grupo-8/Estruturas/Peças para a simulação/Parafuso M12.igs

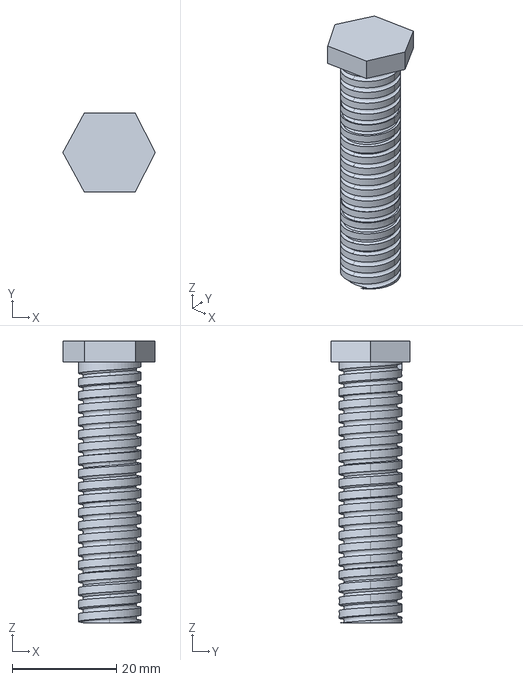
[picture p67: CAD file, 2021-10-16]
Peças para a simulação/Parafuso M12.igs
17.7 x 15.1 x 54.0 mm
