PI2-Grupo-8/Estruturas/Peças para a simulação/Tanque (Comercial).igs

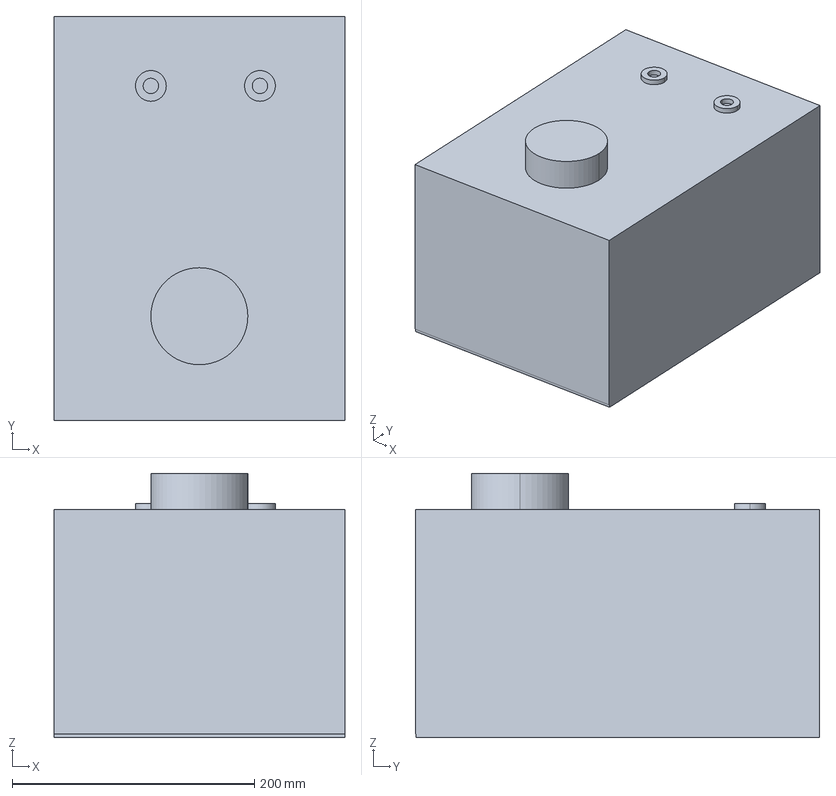
[picture p68: CAD file, 2021-10-16]
Peças para a simulação/Tanque (Comercial).igs
240.1 x 333.6 x 218.0 mm
