PI2-Grupo-8/Estruturas/Peças para a simulação/Capa protetora.igs

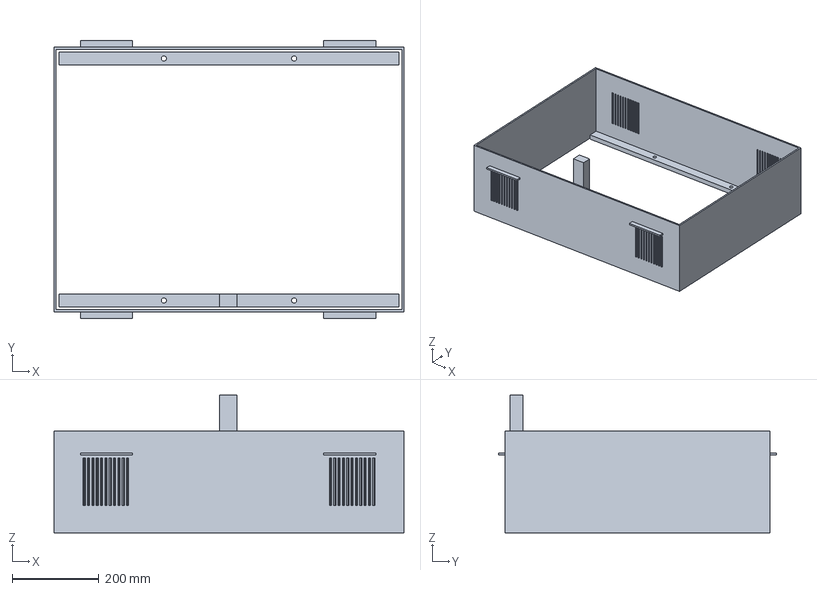
[picture p69: CAD file, 2021-10-16]
Peças para a simulação/Capa protetora.igs
806.3 x 640.0 x 317.3 mm
