PI2-Grupo-8/Estruturas/Peças para a simulação/Suporte de transporte.igs

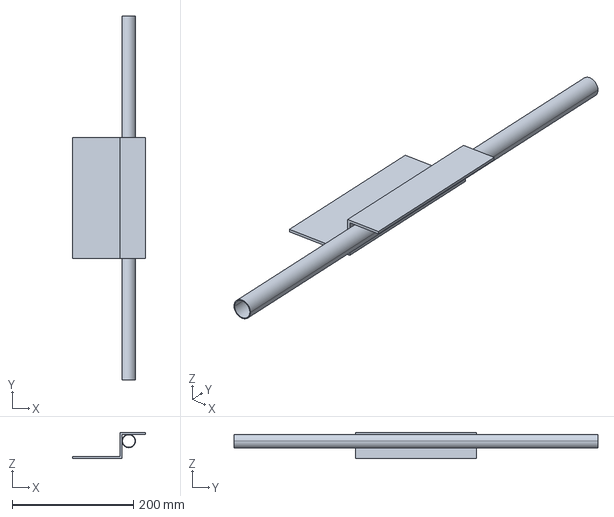
[picture p70: CAD file, 2021-10-16]
Peças para a simulação/Suporte de transporte.igs
120.0 x 600.0 x 43.0 mm
