PI2-Grupo-8/Estruturas/Peças para a simulação/Porcam12.igs

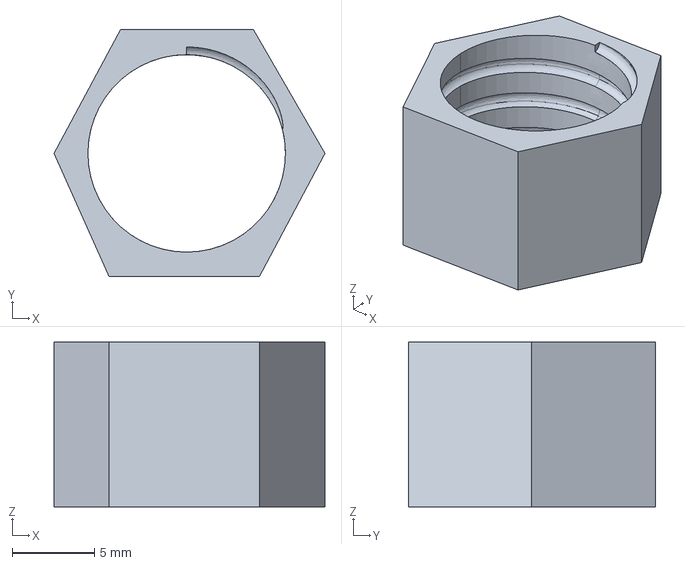
[picture p71: CAD file, 2021-10-16]
Peças para a simulação/Porcam12.igs
16.5 x 15.0 x 10.0 mm
