PI2-Grupo-8/Estruturas/Peças para a simulação/Tampa da capa protetora.igs

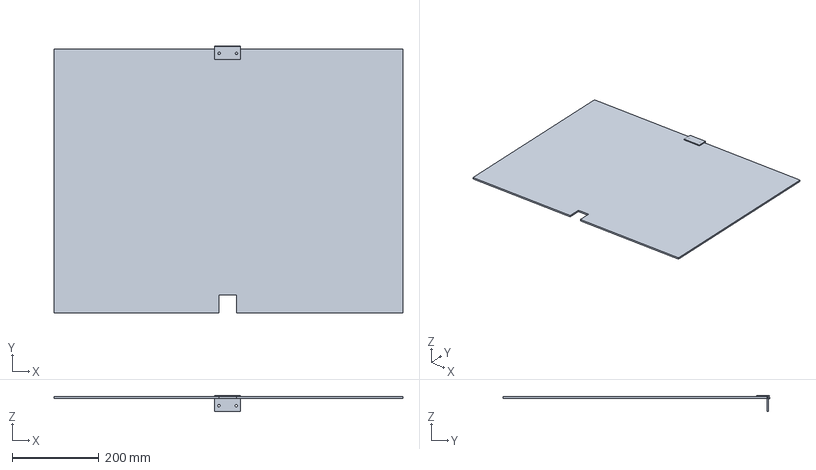
[picture p72: CAD file, 2021-10-16]
Peças para a simulação/Tampa da capa protetora.igs
806.3 x 616.2 x 38.0 mm
