PI2-Grupo-8/Estruturas/Peças para a simulação/Carcaca.igs

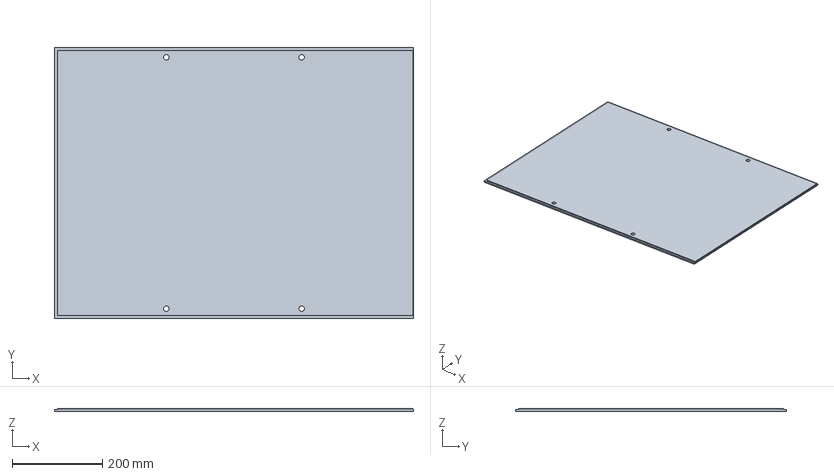
[picture p73: CAD file, 2021-10-16]
Peças para a simulação/Carcaca.igs
796.3 x 600.0 x 6.30 mm
