PI2-Grupo-8/Estruturas/Peças para a simulação/Caixa central Montada(simulacao).igs

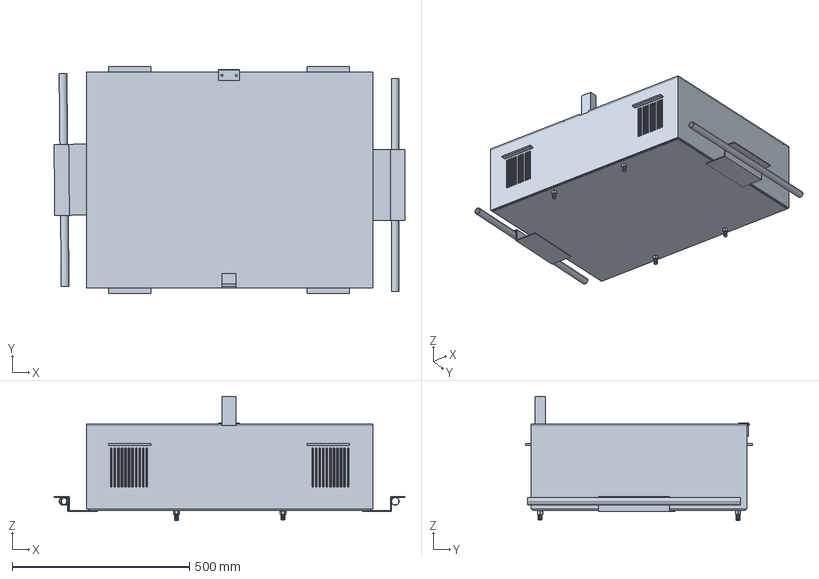
[picture p74: CAD file, 2021-10-16]
Peças para a simulação/Caixa central Montada(simulacao).igs
989.0 x 640.0 x 349.8 mm
