PI2-Grupo-8/Estruturas/Peças para a simulação/Caixa central Montada(simulacao)(2).igs

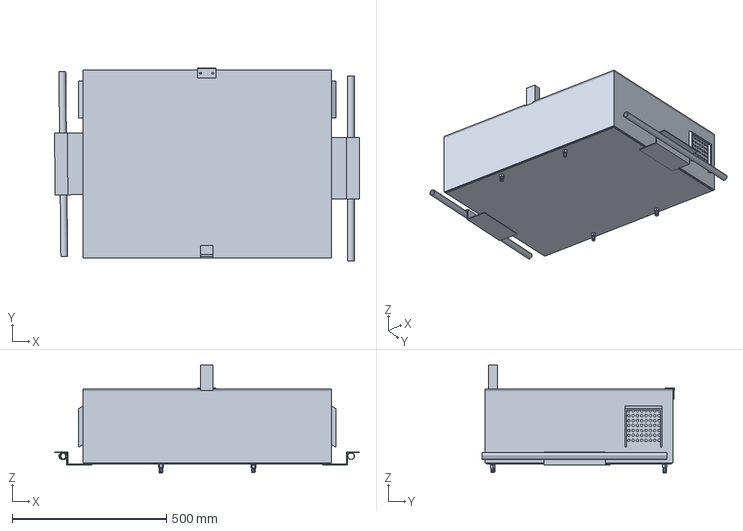
[picture p75: CAD file, 2021-10-16, an earlier design]
Peças para a simulação/Caixa central Montada(simulacao)(2).igs
989.0 x 624.8 x 349.8 mm
