PI2-Grupo-8/Estruturas/(list of files, cad)

Other CAD files:
Cad de montagem/0- MONTAGEM FINAL ABRIR ESSE AQUI.CATProduct
Cad de montagem/Braco de apoio completo Montado Teste.CATProduct
Cad de montagem/Braco rotativo completo (montado) teste.CATProduct
Cad de montagem/Camera com suporte .CATProduct
Cad de montagem/Canaletas.CATProduct
Cad de montagem/Case das baterias montagem.CATProduct
Cad de montagem/Chapa e bracos de apoio (superiro) com chapinhas.CATProduct
Cad de montagem/Chapa e bracos de apoio (superiro).CATProduct
Cad de montagem/Componentes da caixa central ( componentes eletricos).CATProduct
Cad de montagem/Componentes eletronicos na estrutura base.CATProduct
Cad de montagem/Componentes hidraulicos (completo).CATProduct
Cad de montagem/Estrutura base montada final.CATProduct
Cad de montagem/Estrutura central com o suporte do aspersor.CATProduct
Cad de montagem/Estrutura central com os componentes hidraulicos.CATProduct
Cad de montagem/Montagem da capa na estrutura base finalizando.CATProduct
Cad de montagem/Rolamento skf com parafusos e porcas Teste.CATProduct
Cad de montagem/Suporte do bico aspersor montagem.CATProduct
Cad de montagem/Suporte do bico aspersor.CATProduct
Cad de montagem/Suporte dos componentes eletronicos.CATProduct
Cad de montagem/Tampa com borracha.CATProduct
Cad de montagem/braco superiro Montado Teste.CATProduct
Cad de montagem/braco superiro montado.CATProduct
Peças para a simulação/Caixa central Montada(simulacao).CATProduct
Peças para a simulação/Capa protetora.CATPart
Peças para a simulação/Carcaca.CATPart
Peças para a simulação/Suporte de transporte.CATPart
Peças para a simulação/Tampa da capa protetora.CATPart
Peças/Acoplamento de eixo (12 p_ 12).CATPart
Peças/Acoplamento de eixo (8 p_ 12).CATPart
Peças/Amortecedor.CATPart
Peças/Apoio telescopico.CATPart
Peças/Arruela funileiro .CATPart
Peças/Barra regulagem altura.CATPart
Peças/Barra roscada do aspersor.CATPart
Peças/Bateria de litio (grande).CATPart
Peças/Bateria de litio(pequena).CATPart
Peças/Bomba injetora.CATPart
Peças/Capa protetora.CATPart
Peças/Carcaca.CATPart
Peças/Compraveis roda e pneu.CATPart
Peças/Conecctor em T.CATPart
Peças/E - Bateria de litio (grande).CATPart
Peças/E - Bateria de litio(pequena).CATPart
Peças/E - Bomba injetora.CATPart
Peças/E - Botao.CATPart
Peças/E - Camera digital.CATPart
Peças/E - Canaleta (Tampa) segmento.CATPart
Peças/E - Canaleta (curva 90).CATPart
Peças/E - Canaleta (segmento).CATPart
Peças/E - Canaleta em T.CATPart
Peças/E - Capa do sensor ultrasonico (base).CATPart
Peças/E - Capa do sensor ultrasonico (tampa).CATPart
Peças/E - Case das baterias (base).CATPart
Peças/E - Case das baterias (tampa).CATPart
Peças/E - Conversor de nivel logico.CATPart
Peças/E - Cooler eletrico.CATPart
Peças/E - Display.CATPart
Peças/E - Driver de motor DC.CATPart
Peças/E - Lora.CATPart
Peças/E - Modulo Rele.CATPart
Peças/E - Modulo de camera.CATPart
Peças/E - Prateleira dos componentes (base).CATPart
Peças/E - Prateleira dos componentes eletronicos (parte de encaixe).CATPart
Peças/E - Regulador de tensao.CATPart
Peças/E - Resp_3B+.CATPart
Peças/E - Sensor de bussola.CATPart
Peças/E - Sensor de medicao de carca.CATPart
Peças/E - Sensor de temperatura.CATPart
Peças/E - Sensor de tensao.CATPart
Peças/E - Sensor ultrasonico.CATPart
Peças/E - Sirene de aviso.CATPart
Peças/E - Solenoide.CATPart
Peças/E - Transdutor de indutancia.CATPart
Peças/ESp_Lora.CATPart
Peças/Eixo da roda .CATPart
Peças/Eixo de rotacao do braco.CATPart
Peças/Espacador da roda.CATPart
Peças/F - Arruela funileiro.CATPart
Peças/F - Arruela lisa de aba larga.CATPart
Peças/F - Arruela quadrada.CATPart
Peças/F - Cinta de fixacao do tanque.CATPart
Peças/F - Parafuso M10.CATPart
Peças/F - Parafuso M12.CATPart
Peças/F - Parafuso M3 atarraxante.CATPart
Peças/F - Parafuso M3.CATPart
Peças/F - Parafuso M4.CATPart
Peças/F - Parafuso M6 atarraxante.CATPart
Peças/F - Parafuso M6.CATPart
Peças/F - Parafuso M8.CATPart
Peças/F - Parafuso fenda m4.CATPart
Peças/F - Porca M8.CATPart
Peças/F - Porca M10.CATPart
Peças/F - Porca borboleta.CATPart
Peças/F - Porcam12.CATPart
Peças/H - Abracadeira.CATPart
Peças/H - Bico pulverizador.CATPart
Peças/H - Conecctor em T.CATPart
Peças/H - Conector femea.CATPart
Peças/H - Conector macho.CATPart
Peças/H - Luva de reducao.CATPart
Peças/H - Mangueira.CATPart
Peças/H - Tanque (Comercial).CATPart
Peças/H - Valvula by pass.CATPart
Peças/H - Valvula reguladora de vazao.CATPart
Peças/Lora .CATPart
Peças/Mangueira.CATPart
Peças/Motor eletrico .CATPart
Peças/Motor eletrico superior.CATPart
Peças/Parafuso M12.CATPart
Peças/Parafuso M20.CATPart
Peças/Parafuso M3.CATPart
Peças/Parafuso M4.CATPart
Peças/Parafuso M6.CATPart
Peças/Parafuso M8.CATPart
Peças/Parafuso fenda m4.CATPart
Peças/Placa conex.CATPart
Peças/Placas conexao tubo L e chapa central.CATPart
Peças/Placas de apoio dos bracos(apagar).CATPart
Peças/Placas de apoio dos bracos.CATPart
Peças/Porca M8.CATPart
Peças/Porca M20.CATPart
Peças/Porca borboleta.CATPart
Peças/Porcam12.CATPart
Peças/Resp_3B+.CATPart
Peças/Rolamento SKF F4BSS.CATPart
Peças/Rolamento blindado.CATPart
Peças/Sensor de fluxo .CATPart
Peças/Solenoide .CATPart
Peças/Suporte da camera .CATPart
Peças/Suporte da solenoide.CATPart
Peças/Suporte de transporte.CATPart
Peças/Suporte do aspersor .CATPart
Peças/Suporte do aspersor base da caixa e do bico.CATPart
Peças/Suporte novo externo.CATPart
Peças/Suporte novo interno.CATPart
Peças/Tampa da capa protetora.CATPart
Peças/Tanque (Comercial).CATPart
Peças/Tubo de conexao.CATPart
Peças/Tubos bracos rotativos.CATPart
Peças/Valvula by pass.CATPart
Peças/Valvula reguladora de vazao.CATPart
Peças/espacador do amortecedor.CATPart
Produção/0- Peças/Apoio telescopico.CATPart
Produção/0- Peças/Capa protetora.CATPart
Produção/0- Peças/Carcaca.CATPart
Produção/0- Peças/Placa conex (suporte do motor).CATPart
Produção/0- Peças/Placa conex.CATPart
Produção/0- Peças/Placa conexao (suporte do motor) (1).CATPart
Produção/0- Peças/Placa conexao (suporte do motor) (2).CATPart
Produção/0- Peças/Placa conexao (suporte do motor) (3).CATPart
Produção/0- Peças/Placa conexao (suporte do motor) (4).CATPart
Produção/0- Peças/Placa conexao (suporte do motor) (5).CATPart
Produção/0- Peças/Placa conexao (suporte do motor) (6).CATPart
Produção/0- Peças/Placa conexao (suporte do motor).CATPart
Produção/0- Peças/Resp_3B+.CATPart
Produção/0- Peças/Rolamento blindado.CATPart
Produção/0- Peças/Suporte de transporte.CATPart
Produção/0- Peças/Suporte do aspersor .CATPart
Produção/0- Peças/Suporte novo interno.CATPart
Produção/0- Peças/Tampa da capa protetora.CATPart
Produção/0- Peças/Tubos bracos rotativos.CATPart
Produção/10- Chapinhas para o suporte do aspersor/Chapinhas do suporte do aspersor.CATPart
Produção/11- Haste do suporte do aspersor/haste (base de prod).CATPart
Produção/13- Placa de conexão/Placa de conexao (reforcos).CATPart
Produção/13- Placa de conexão/Placa de conexao fabricacao.CATProduct
Produção/13- Placa de conexão/Placa de conexao(chapa).CATPart
Produção/13- Placa de conexão/placa conexao montagem.CATProduct
Produção/14- Placa de conexão tubo L e chapa central/Placas conexao tubo L e chapa central.CATPart
Produção/15- Placa de suporte do bico aspersor/Suporte do bico aspersor (chapa).CATPart
Produção/16- Suporte de transporte/Suporte de transporte (placa).CATPart
Produção/16- Suporte de transporte/Suporte de transporte montagem.CATProduct
Produção/19- Tubo em L/Tubo em L (inteiro).CATPart
Produção/19- Tubo em L/Tubo em L (pedaco maior).CATPart
Produção/19- Tubo em L/Tubo em L (pedaco menor).CATPart
Produção/19- Tubo em L/Tubo em L.CATProduct
Produção/6- Apoio telescópico (parte superior)/Apoio telescopico (parte superiro).CATProduct
Produção/6- Apoio telescópico (parte superior)/Apoio telescopico placa(parte superior).CATPart
Produção/6- Apoio telescópico (parte superior)/Tubo apoio telescopico(parte superior).CATPart
Produção/7- Suporte e espaçador do amortecedor/Suporte de fixacao do amortecedor e espacador do mesmo.CATPart
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
