PI2-Grupo-8/Estruturas/Manuais/Manual de fabricacao.pdf

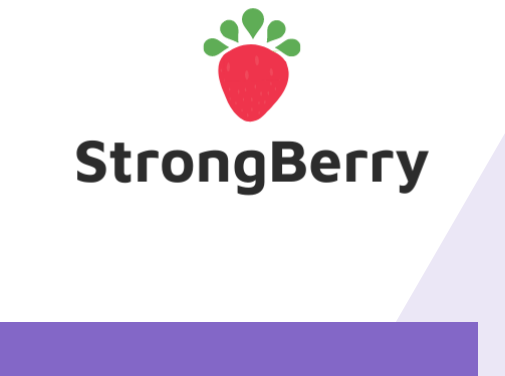
[picture p76: figure]

# Manual de fabricação

# Índice

# Instruções gerais

Nesse documento será apresentado a rotina de produção dos componentes que formam o StrongBerry. Portanto, após o fim desse documento todas as peças necessárias para montagem do produto estarão finalizadas. Com isso, deve-se proceder com a montagem utilizando o Manual de Montagem.

Além | disso, | o | documento | contém | uma | lista | de
ferramentas/equipamentos necessários para produção de todas as peças do produto e uma lista de Equipamentos Indivuais de Proteção (EPI) cuja utilização é recomendada durante os procedimentos de fabricação dos componentes.

# Lista de materiais nescessários

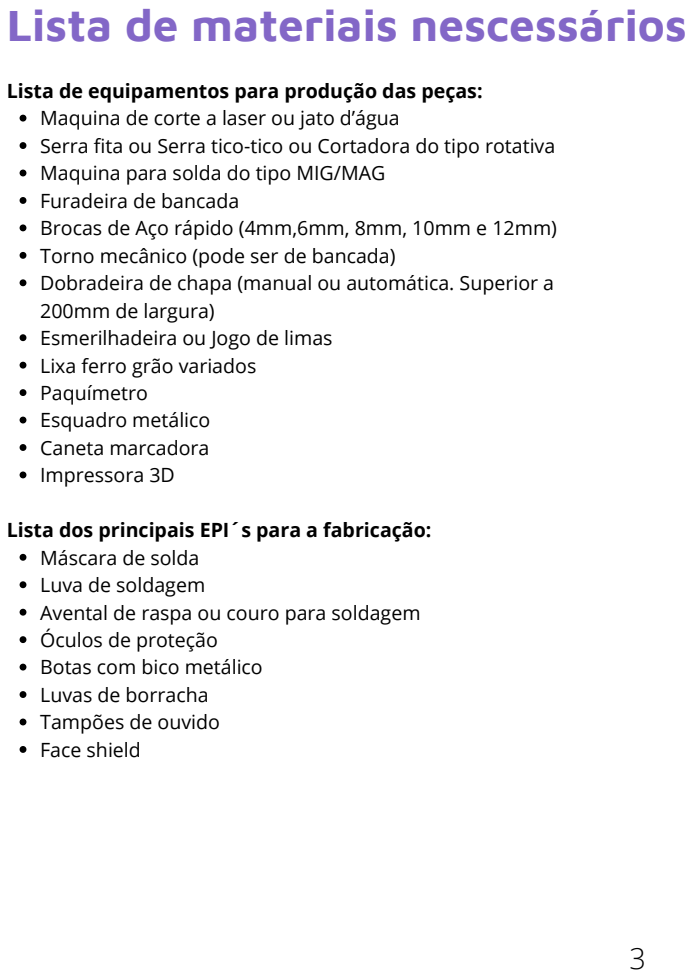
[picture p77: page 4]

Lista de equipamentos para produção das peças:
Maquina de corte a laser ou jato d’água
Serra fita ou Serra tico-tico ou Cortadora do tipo rotativa
Maquina para solda do tipo MIG/MAG
Furadeira de bancada
Brocas de Aço rápido (4mm,6mm, 8mm, 10mm e 12mm)
Torno mecânico (pode ser de bancada)
Dobradeira de chapa (manual ou automática. Superior a
200mm de largura)
Esmerilhadeira ou Jogo de limas
Lixa ferro grão variados
Paquímetro
Esquadro metálico
Caneta marcadora
Impressora 3D

Lista dos principais EPI´s para a fabricação:
Máscara de solda
Luva de soldagem
Avental de raspa ou couro para soldagem
Óculos de proteção
Botas com bico metálico
Luvas de borracha
Tampões de ouvido
Face shield

# Capa de proteção

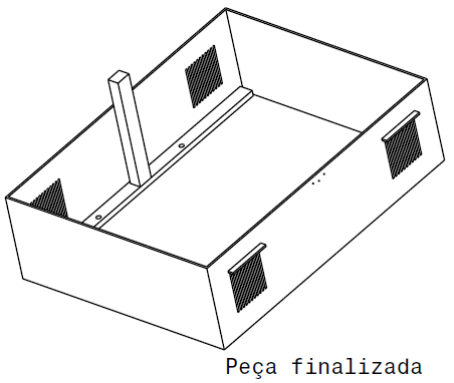
[picture p78: figure]

Imprimir a peça utilizando uma impressora 3D.
Confeccionar 1 unidade da Capa de proteção.

# Tampa da caixa protetora

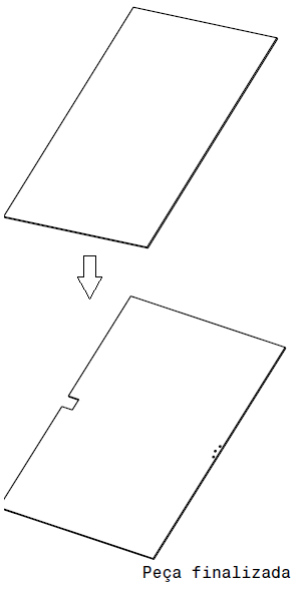
[picture p79: figure]

Realizar os furos na peça 1 por meio de uma furadeira de bancada.
Realizar o corte a laser.
Confeccionar 1 unidade da peça.

# Chapa central

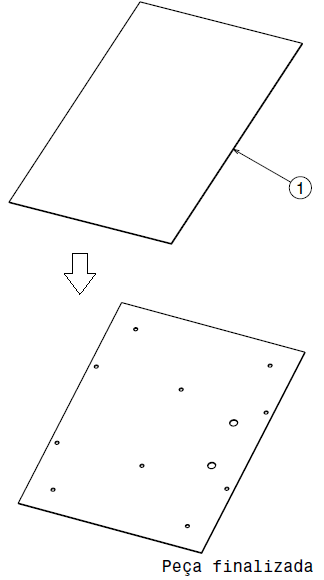
[picture p80: figure]

Faça os furos na chapa utilizando uma furadeira de bancada.
Confeccionar 1 unidade da peça.

# Apoio telescópico

# (parte superior)

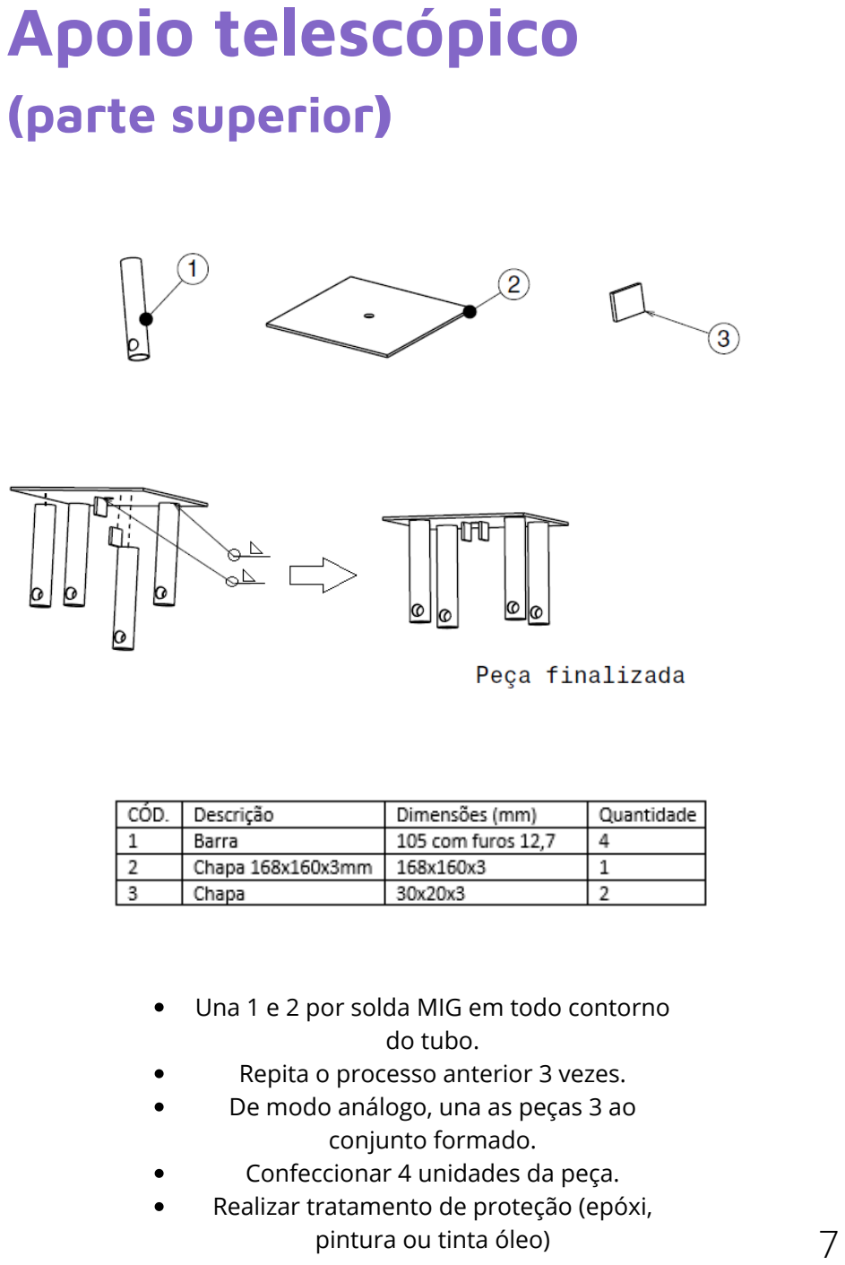
[picture p81: page 8]

Una 1 e 2 por solda MIG em todo contorno do tubo.
Repita o processo anterior 3 vezes. De modo análogo, una as peças 3 ao conjunto formado.
Confeccionar 4 unidades da peça. Realizar tratamento de proteção (epóxi, pintura ou tinta óleo)

# Suporte e espaçador do amortecedor

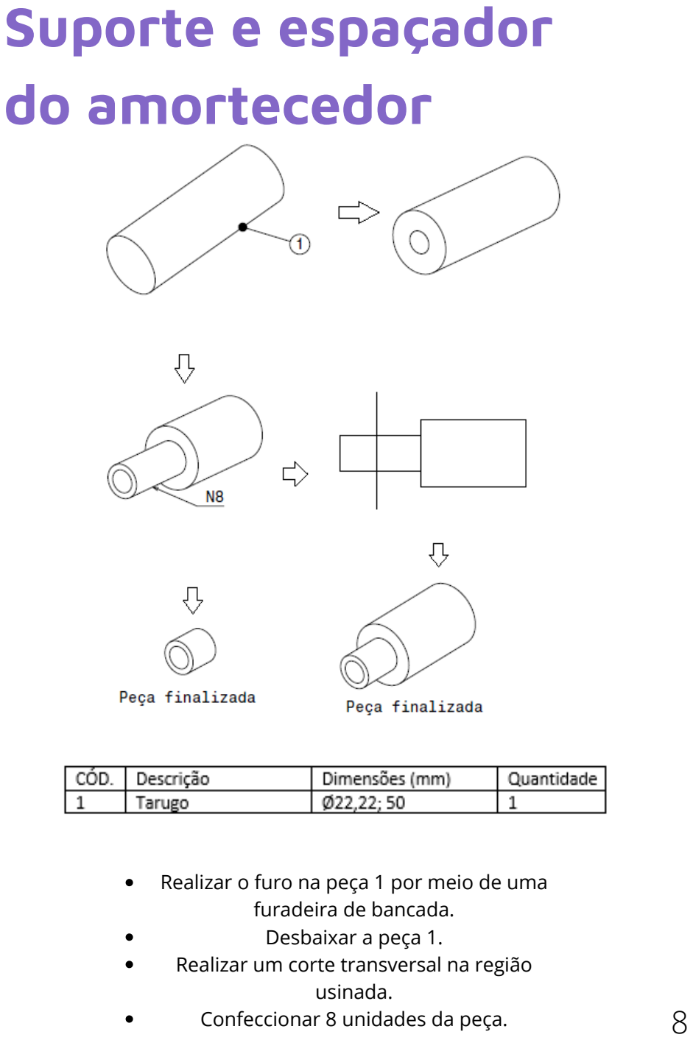
[picture p82: page 9]

Realizar o furo na peça 1 por meio de uma furadeira de bancada.
Desbaixar a peça 1.
Realizar um corte transversal na região usinada.
Confeccionar 8 unidades da peça.

# Apoio telescópico

# (parte inferior)

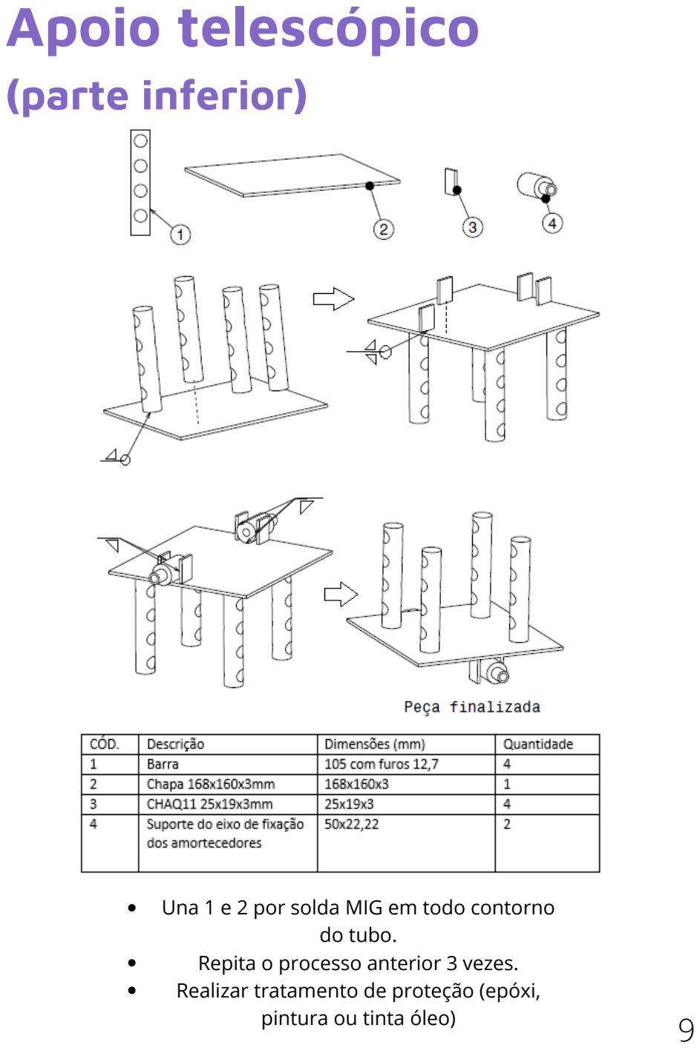
[picture p83: page 10]

Una 1 e 2 por solda MIG em todo contorno do tubo.
Repita o processo anterior 3 vezes. Realizar tratamento de proteção (epóxi, pintura ou tinta óleo)

# Espaçador da roda

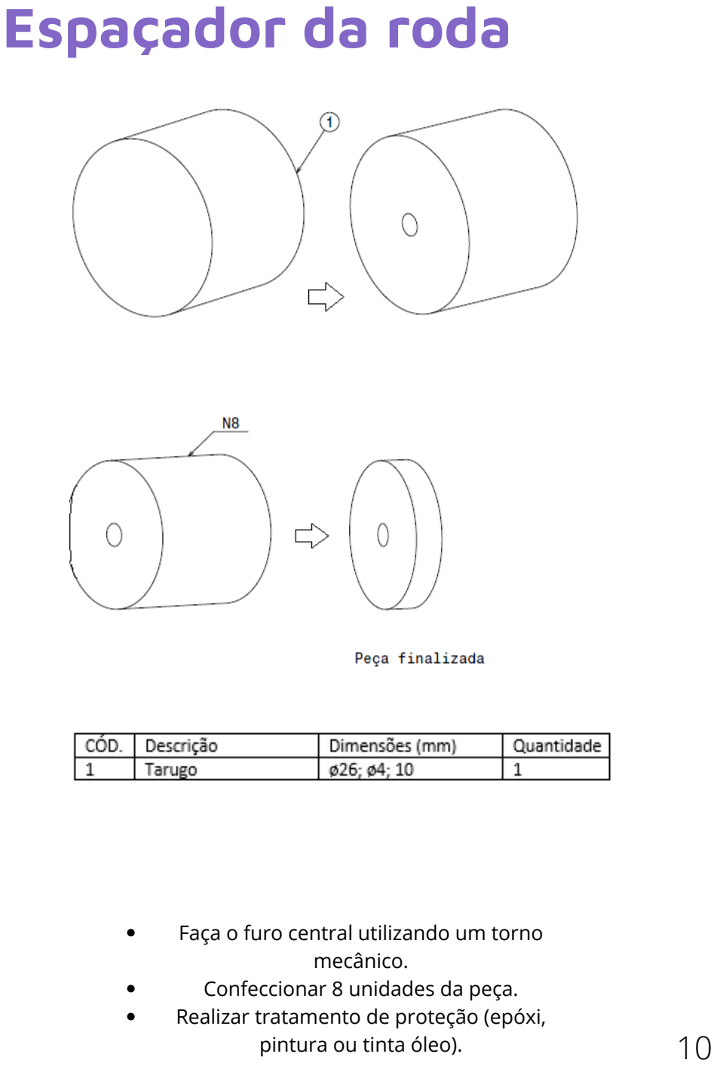
[picture p84: page 11]

Faça o furo central utilizando um torno mecânico.
Confeccionar 8 unidades da peça. Realizar tratamento de proteção (epóxi, pintura ou tinta óleo).

# Chapa de suporte do aspersor

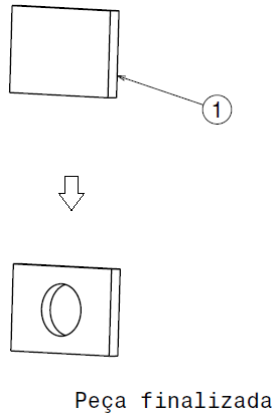
[picture p85: figure]

Fure a peça conforme ilustrado utilizando uma furadeira.
Confeccionar 4 unidades da peça.

# Haste do aspersor

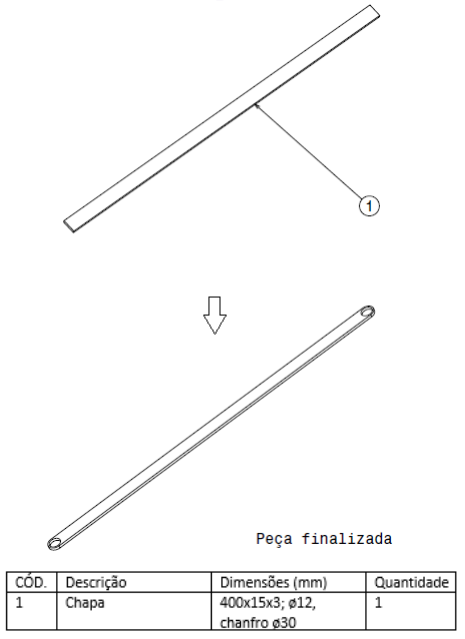
[picture p86: figure]

Utilizando-se de uma furadeira de bancada realize os 2 furos nas extremidades. Chanfrar as duas extremidades da barra. Confeccionar 2 unidades da peça. Realizar tratamento de proteção (epóxi, pintura ou tinta óleo).

# Suporte do motor superior

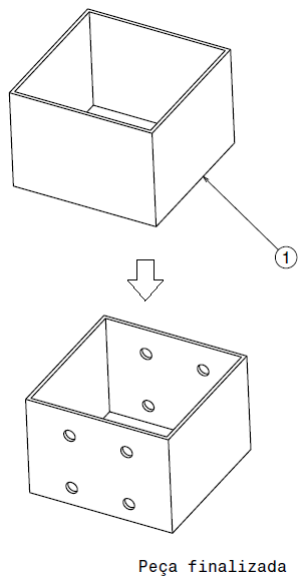
[picture p87: figure]

Realize o corte, com a serra fita ou tico tico, do perfil quadrado de acordo com a medida especificada.
Realizar os furos na peça 1 por meio de uma furadeira de bancada.
Confeccionar 4 unidades da peça.

# Placa de conexão

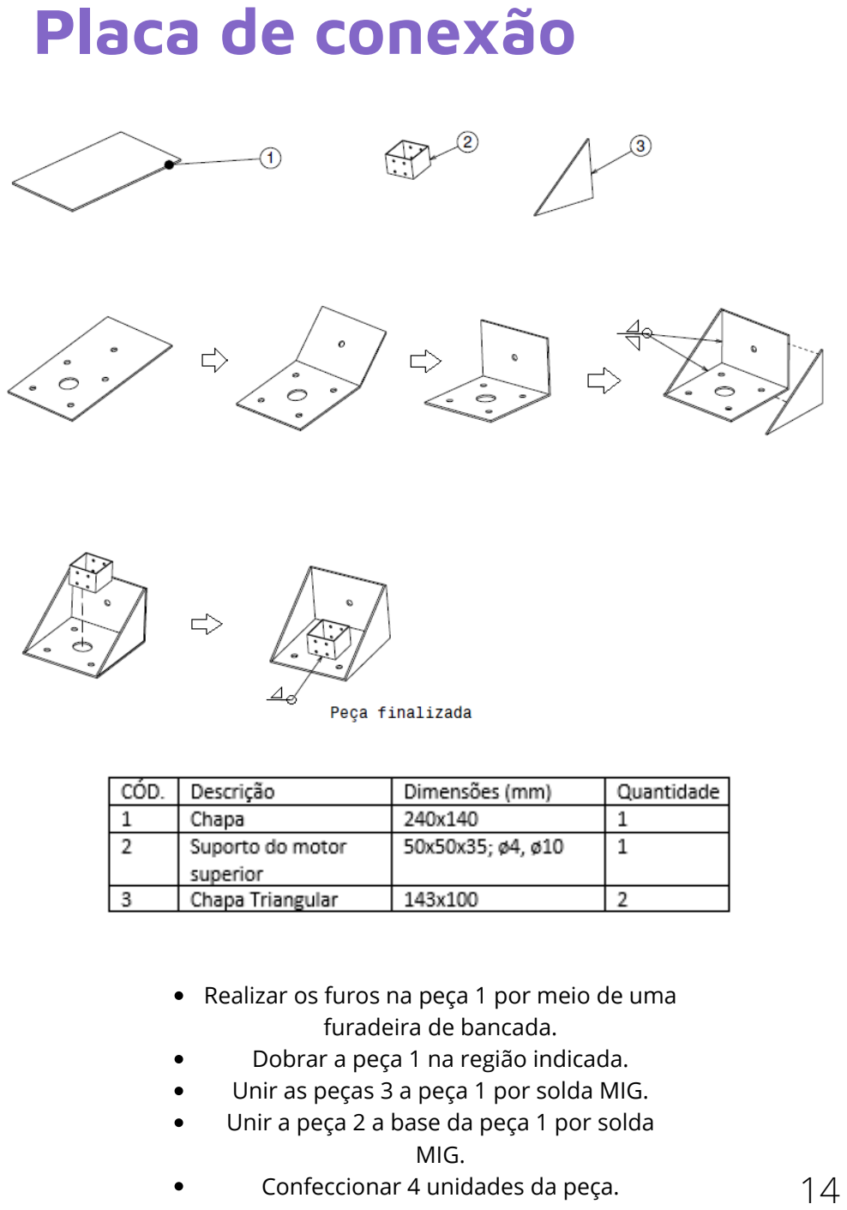
[picture p88: page 15]

Realizar os furos na peça 1 por meio de uma furadeira de bancada.
Dobrar a peça 1 na região indicada. Unir as peças 3 a peça 1 por solda MIG. Unir a peça 2 a base da peça 1 por solda MIG.
Confeccionar 4 unidades da peça.

# Base tubo L

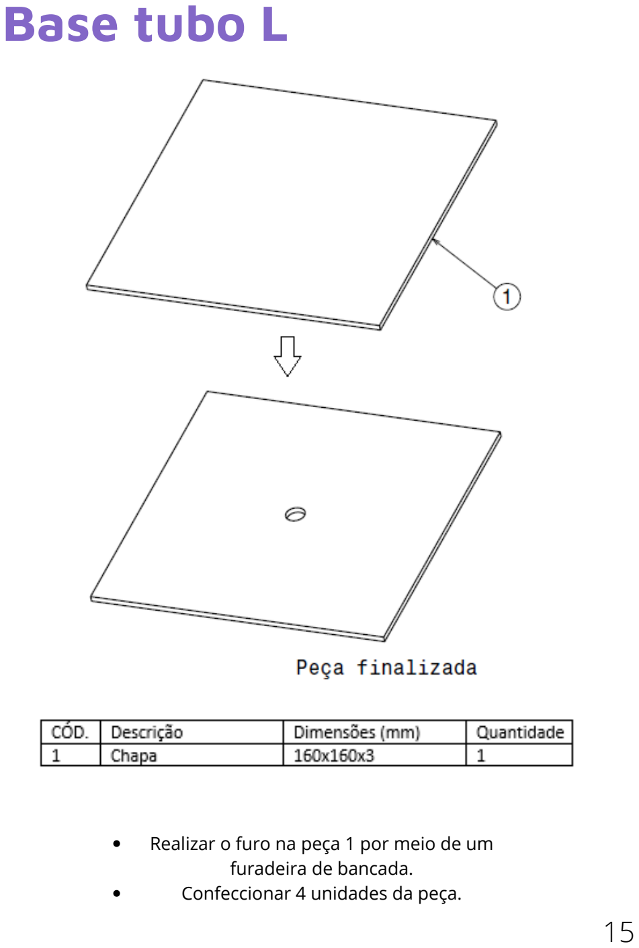
[picture p89: page 16]

Realizar o furo na peça 1 por meio de um furadeira de bancada.
Confeccionar 4 unidades da peça.

# Suporte do bico aspersor

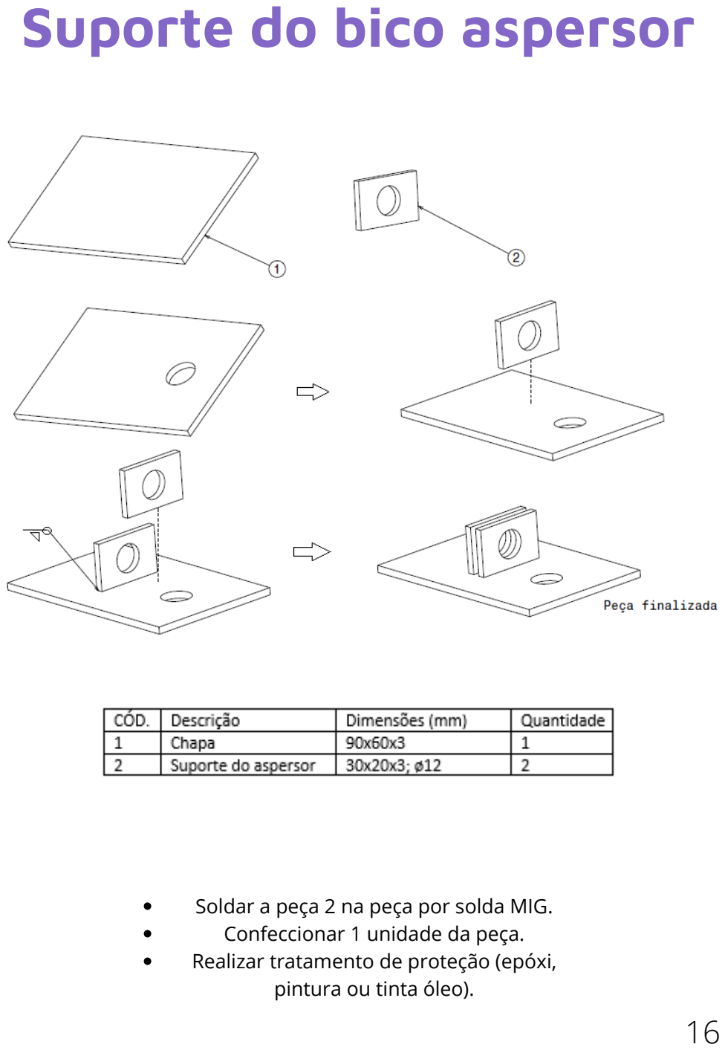
[picture p90: page 17]

Soldar a peça 2 na peça por solda MIG. Confeccionar 1 unidade da peça. Realizar tratamento de proteção (epóxi, pintura ou tinta óleo).

# Suporte de transporte

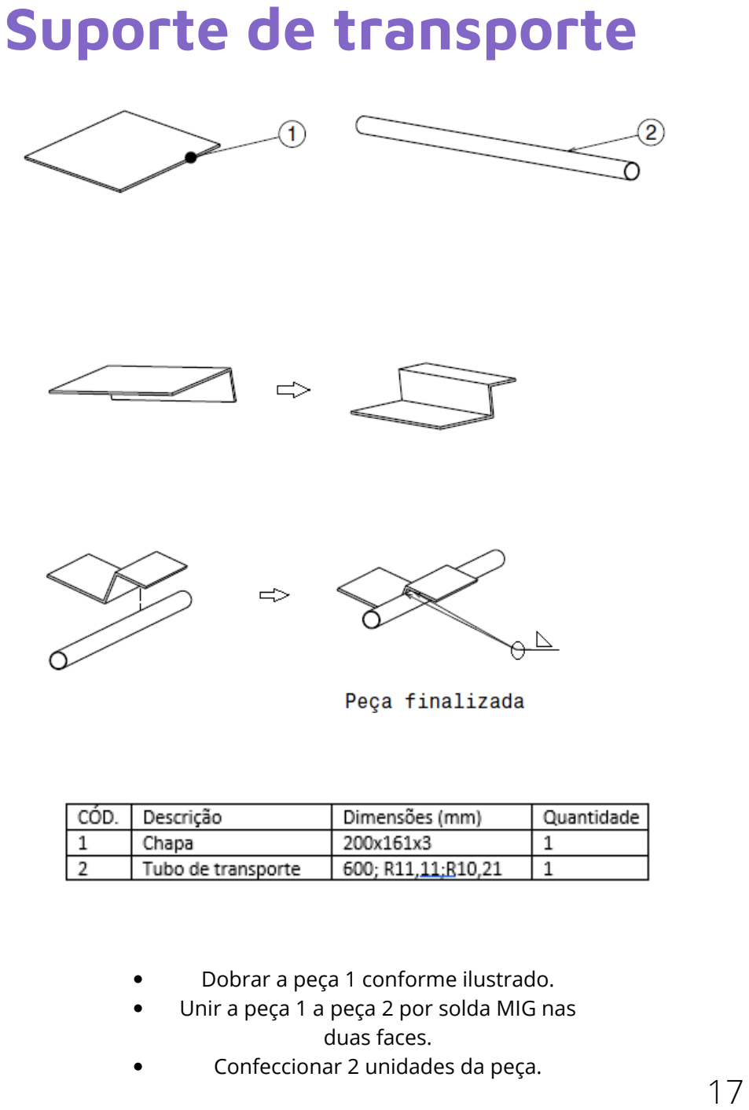
[picture p91: page 18]

Dobrar a peça 1 conforme ilustrado. Unir a peça 1 a peça 2 por solda MIG nas duas faces.
Confeccionar 2 unidades da peça.

# Suporte externo da roda

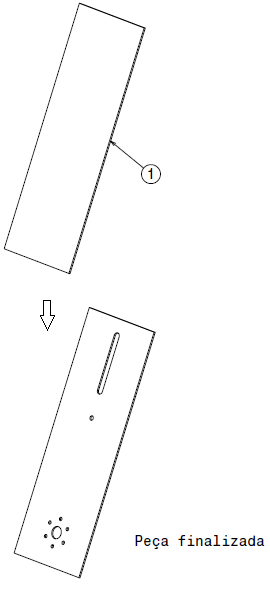
[picture p92: figure]

Realizar os furos na peça 1 por meio de uma furadeira de bancada.
Cortar a laser a peça 1 para fazer o rasgo. Confeccionar 4 unidades da peça Realizar tratamento de proteção (epóxi, pintura ou tinta óleo).

# Suporte interno da roda

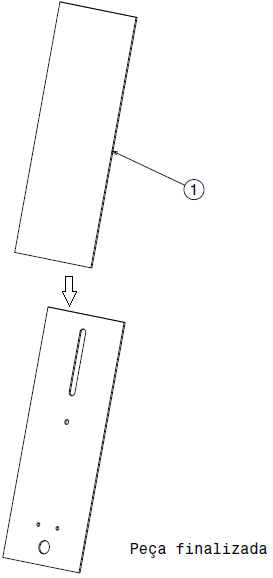
[picture p93: figure]

Realizar os furos na peça 1 por meio de um torno mecânico.
Cortar a laser a peça 1 para fazer o rasgo. Confeccionar 4 unidades da peça Realizar tratamento de proteção (epóxi, pintura ou tinta óleo).

# Tubo em L

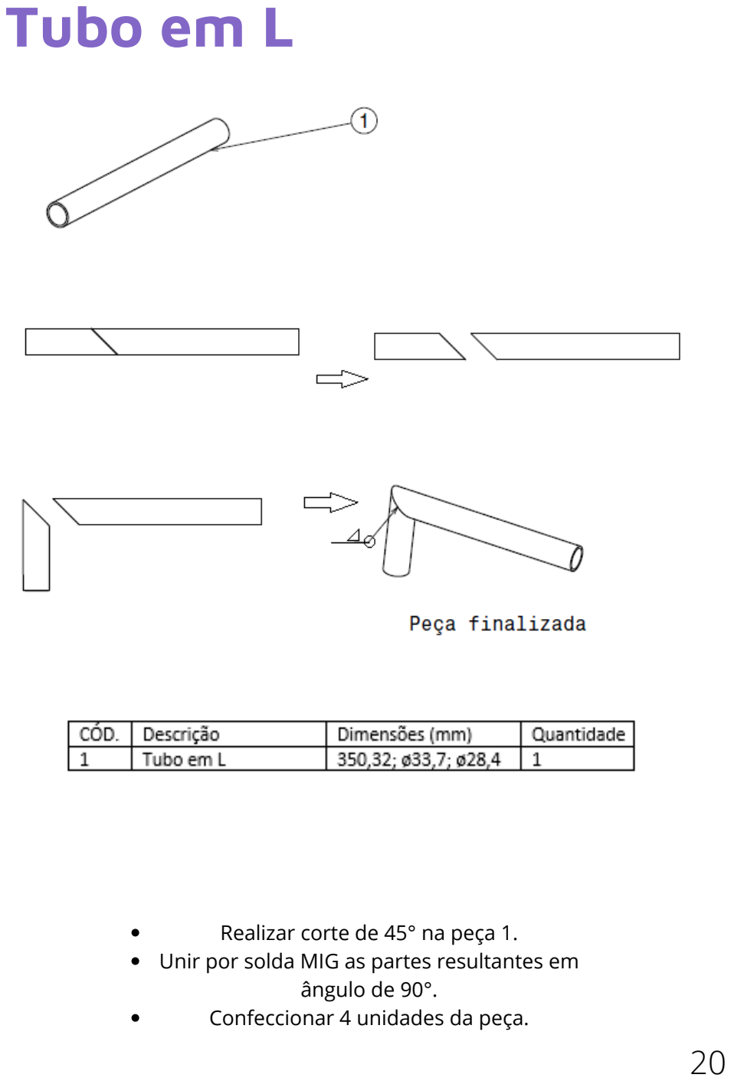
[picture p94: page 21]

Realizar corte de 45° na peça 1. Unir por solda MIG as partes resultantes em ângulo de 90°.
Confeccionar 4 unidades da peça.

# Fixação do tanque

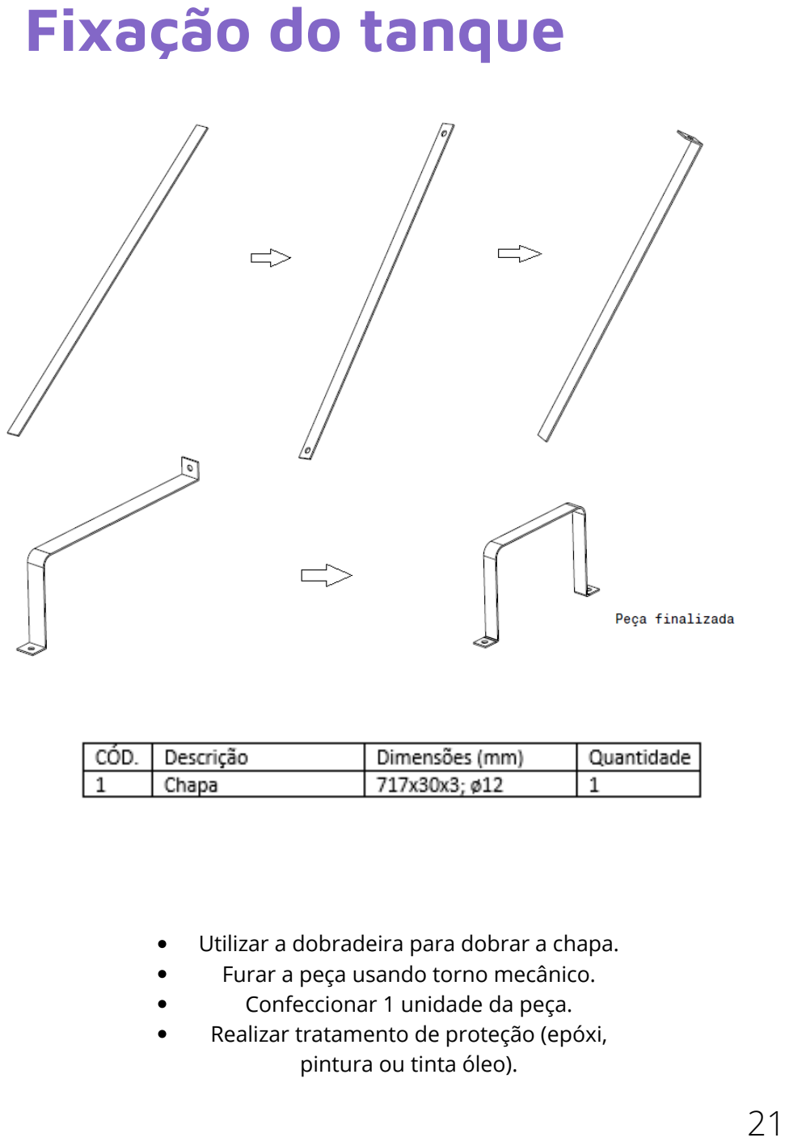
[picture p95: page 22]

Utilizar a dobradeira para dobrar a chapa. Furar a peça usando torno mecânico. Confeccionar 1 unidade da peça. Realizar tratamento de proteção (epóxi, pintura ou tinta óleo).

# Suporte da solenoide

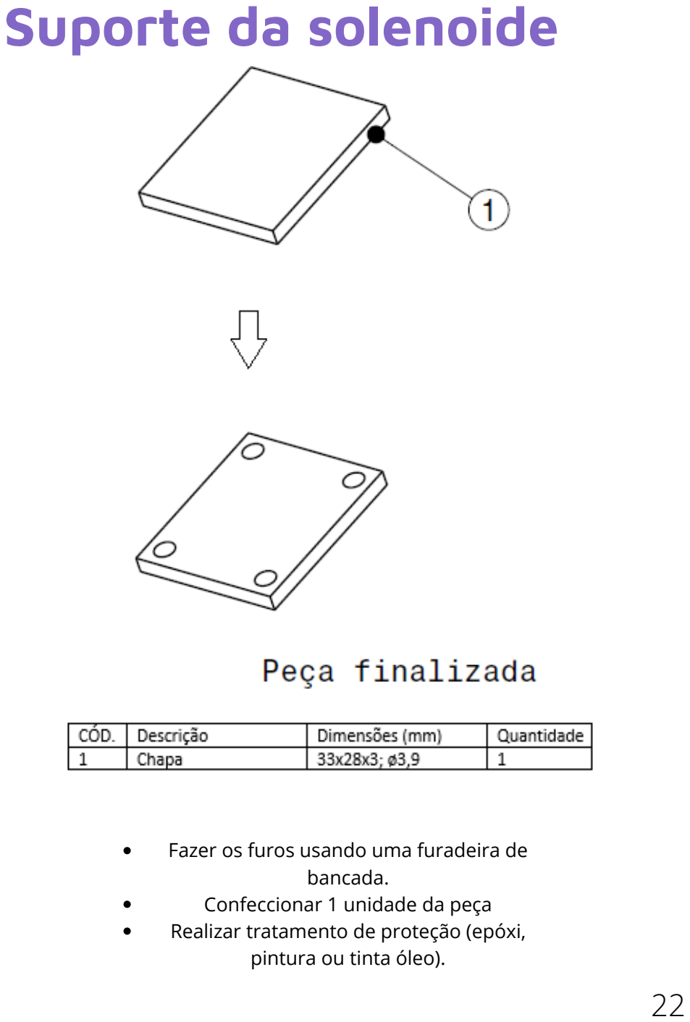
[picture p96: page 23]

Fazer os furos usando uma furadeira de bancada.
Confeccionar 1 unidade da peça Realizar tratamento de proteção (epóxi, pintura ou tinta óleo).

# Suporte da camera

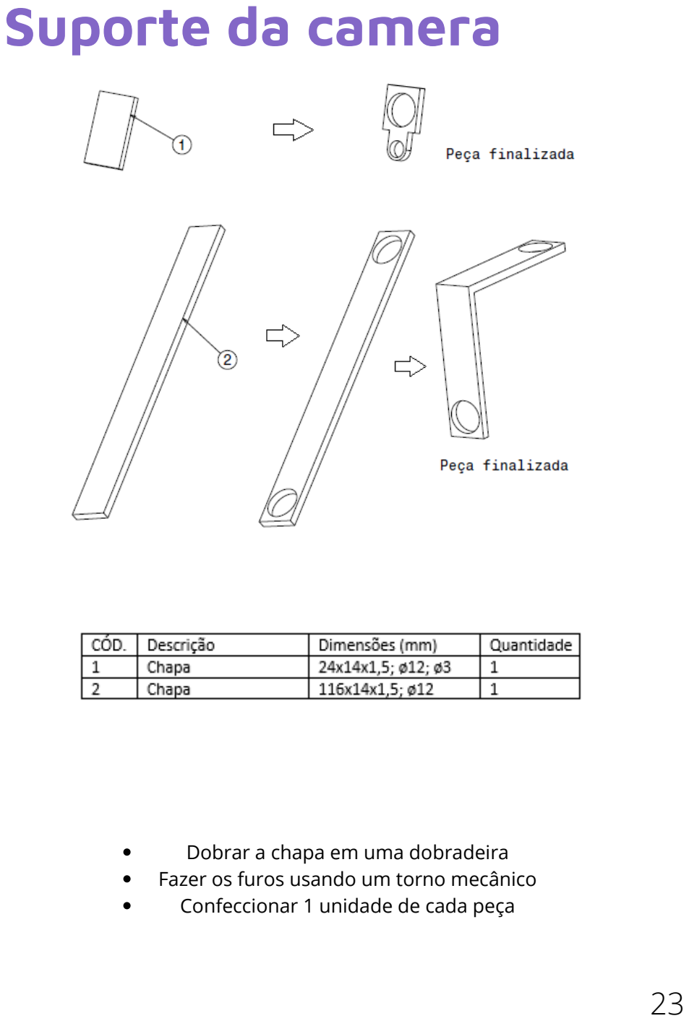
[picture p97: page 24]

Dobrar a chapa em uma dobradeira Fazer os furos usando um torno mecânico Confeccionar 1 unidade de cada peça

# Suporte dos componentes eletrônicos


Imprimir a peça utilizando uma impressora 3D.
Confeccionar 1 unidade da Base Confeccionar 2 unidades da Parte modular

# Capa do sensor ultrassônico

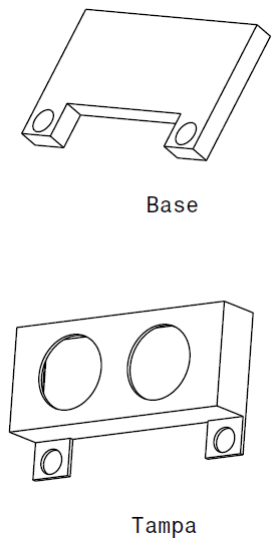
[picture p98: figure]

Imprimir a peça utilizando uma impressora 3D.
Confeccionar 8 unidades da Base. Confeccionar 4 unidades da Tampa.

# Case das baterias


Imprimir a peça utilizando uma impressora 3D.
1 unidade da Tampa
1 unidade da Base

# Case do motor superior

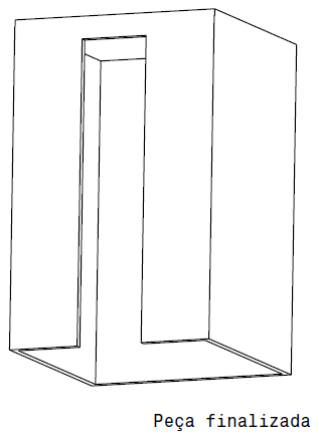
[picture p99: figure]

Imprimir a peça utilizando uma impressora 3D.
Confeccionar 4 unidades

# Suporte sensor de rotação


Fazer o furo usando uma furadeira de bancada.
Utilizar uma dobradeira para dobrar a peça 1 em ângulos de 90°.
Confeccionar 4 peças.

# Placa de Circuito impresso

O StrongBerry conta com duas placas de circuito impresso (PCI), uma para conectar a Raspberry Pi 3B+ e outra para a ESP32, em que ambas devem ser feitas de fibra de vidro FR-04 de duas camadas utilizando uma espessura de cobre de 1 oz (onça). As trilhas devem ser de 0.5mm devido ao valor da corrente de operação e com um espaçamento mínimo para o isolamento do sistema de 0.13mm pelo padrão IPC2221. Sendo que para a PCI desenvolvida para a ESP32 esse afastamento foi aumentado para 0.54mm

# PCI - Raspberry Pi 3B+

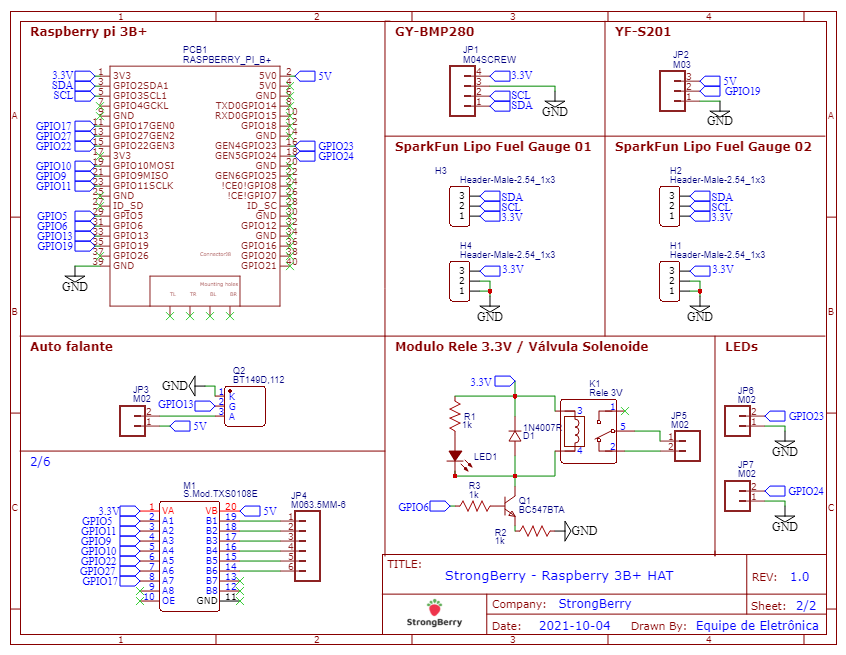
[picture p100: figure]
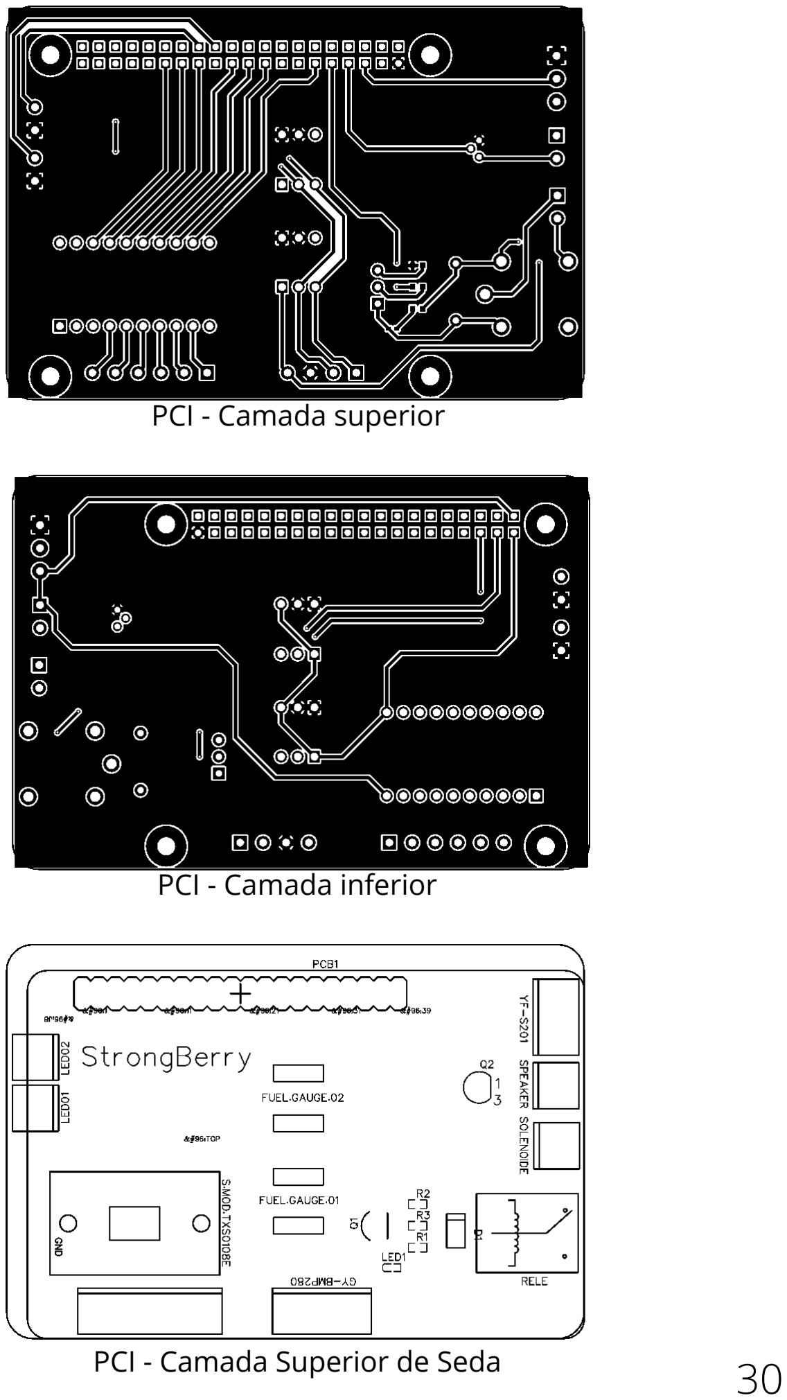
[picture p101: page 31]

PCI - Camada superior

PCI - Camada inferior

PCI - Camada Superior de Seda | 30

# PCI - ESP32LoRa

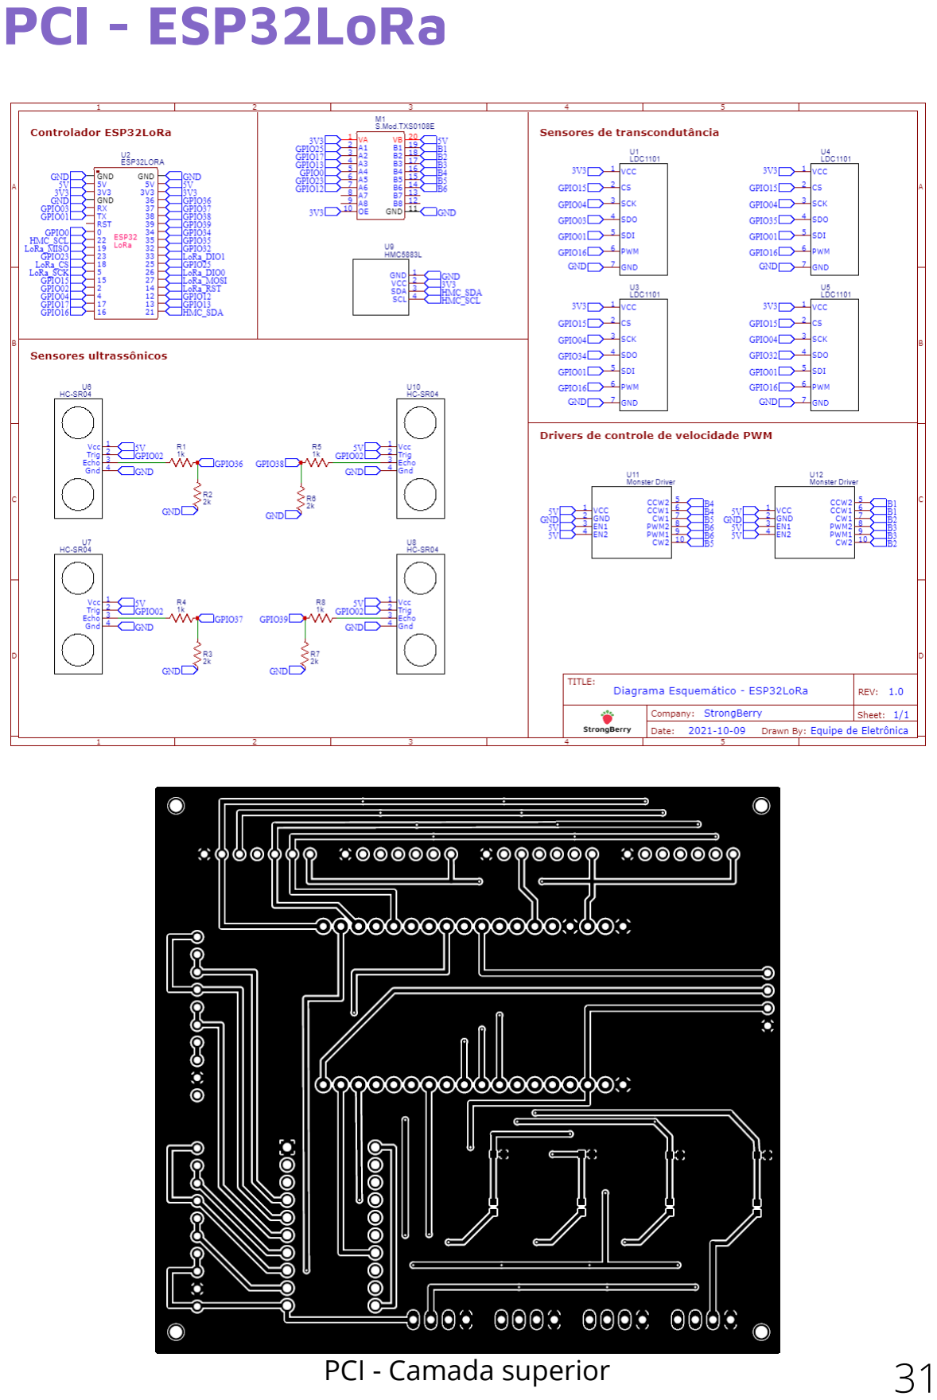
[picture p102: page 32]

PCI - Camada superior | 31

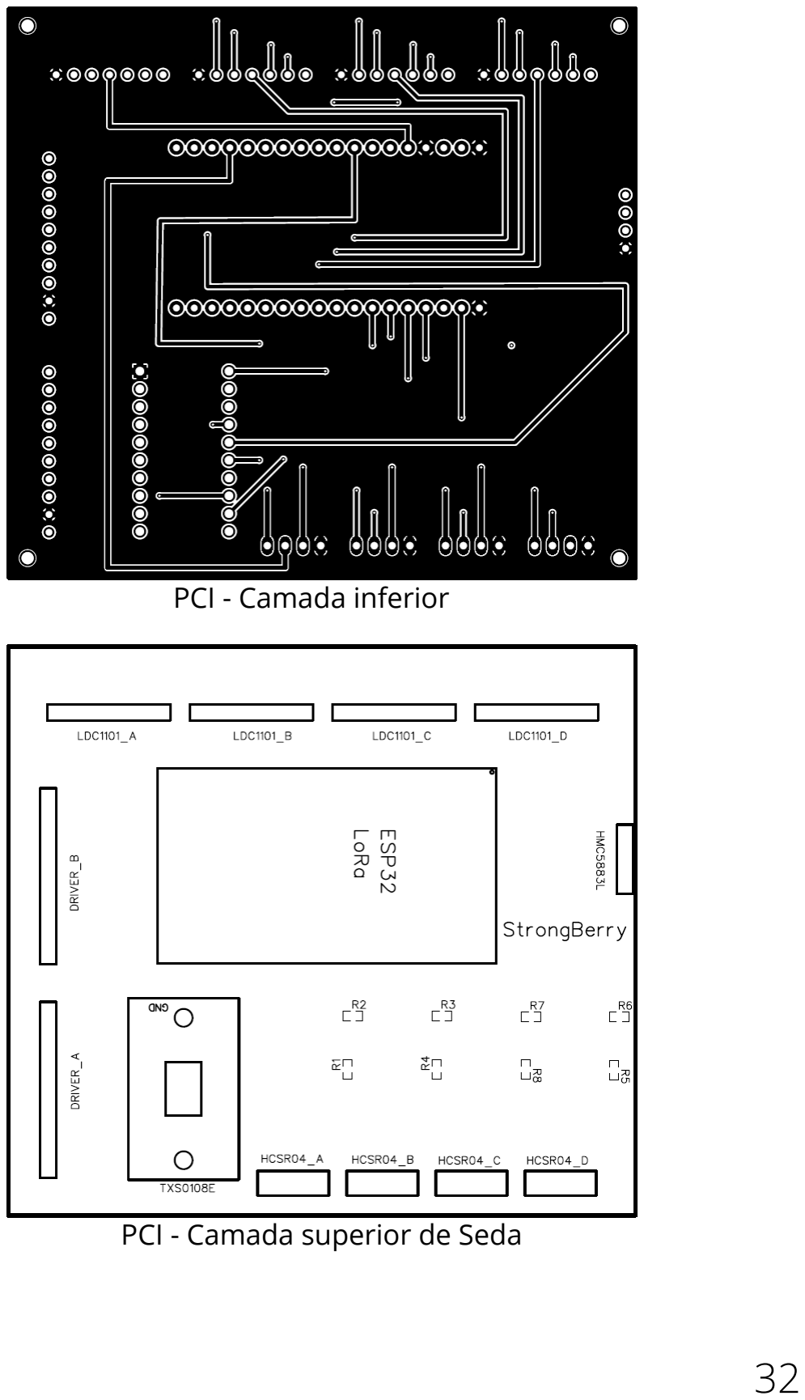
[picture p103: page 33]

PCI - Camada inferior

PCI - Camada superior de Seda

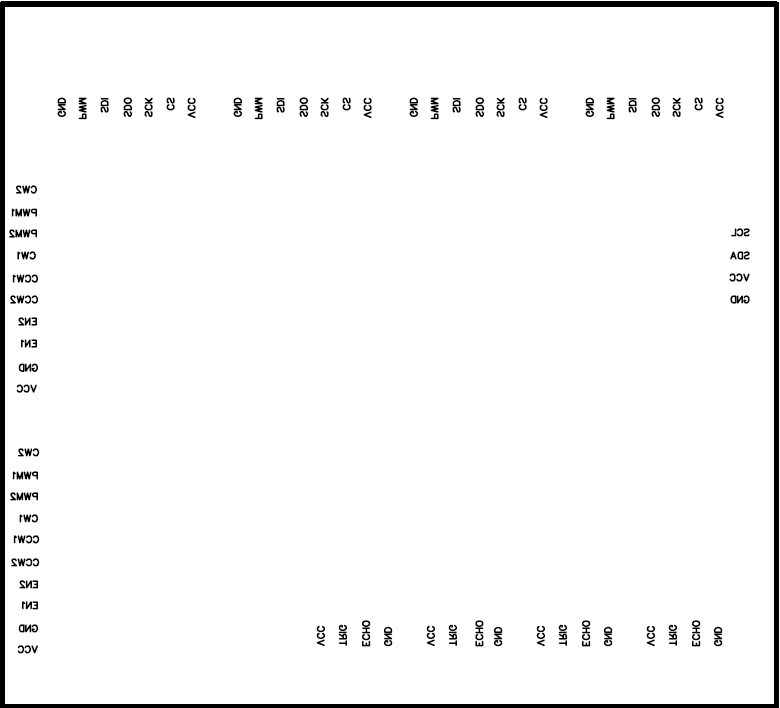
[picture p104: figure]

PCI - Camada inferior de Seda

## Outubro/2021

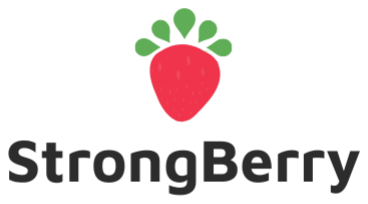
[picture p105: figure]
