PI2-Grupo-8/Estruturas/Lista de ferramenstas-componentes e EPI_s/Lista de equipamento e epis para montagem.docx

Lista de equipamento/ferramentas para a montagem:

- Alicate
- Alicate de corte
- Estilete
- Pistola de ar quente
- Desencapador para fios
- Multímetro
- Tubos termo retrátil
- Ferro de solda
- Arame de solda
- Sugador de solda
- Parafusadeira ou furadeira de mão com broca de aço rápido de 2,5mm
- Conjunto de chaves de fenda
- Conjunto de chave Allen de pequenos tamanhos
- Conjunto de chaves fixa ou estrela “estriada” (5,5; 6; 7; 10; 13; 17 e 19)
- Cavalete de suporte
- Cola plástica
- Fita para vedação de roscas
- Fita dupla face
- Esquadro
- Caneta marcadora

Epis para a montagem:

- Óculos de proteção
- Botas com bico de aço
- Luvas de borracha
