PI2-Grupo-8/Estruturas/Imagens do manual/26 Braco superiro montado.png

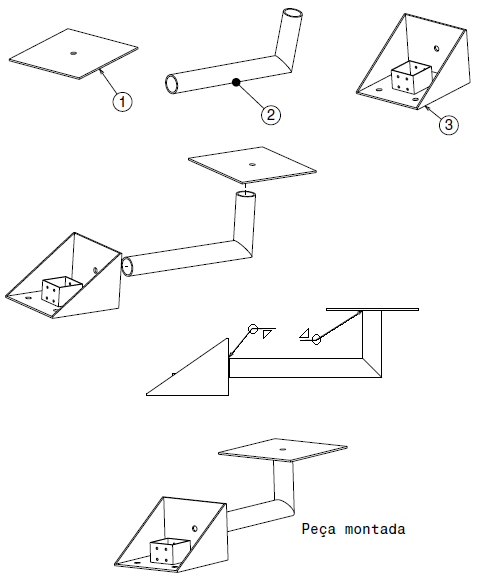
Imagens do manual/26 Braco superiro montado.png
