PI2-Grupo-8/Estruturas/Imagens do manual/27 Chapa e bracos de apoio(superiro) com chapinhas.png

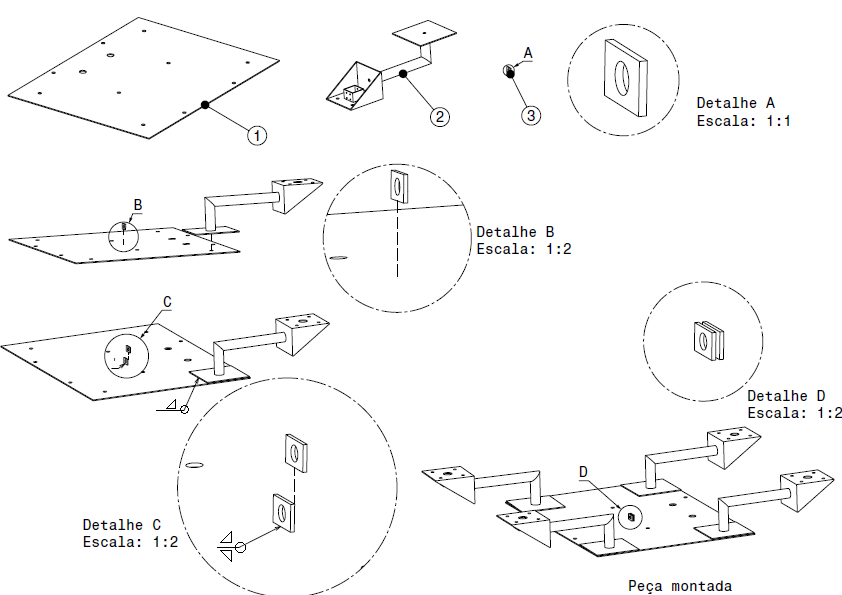
Imagens do manual/27 Chapa e bracos de apoio(superiro) com chapinhas.png
