PI2-Grupo-8/Estruturas/Imagens do manual/28 Chapa central com bracos chapinhas e sup transp.png

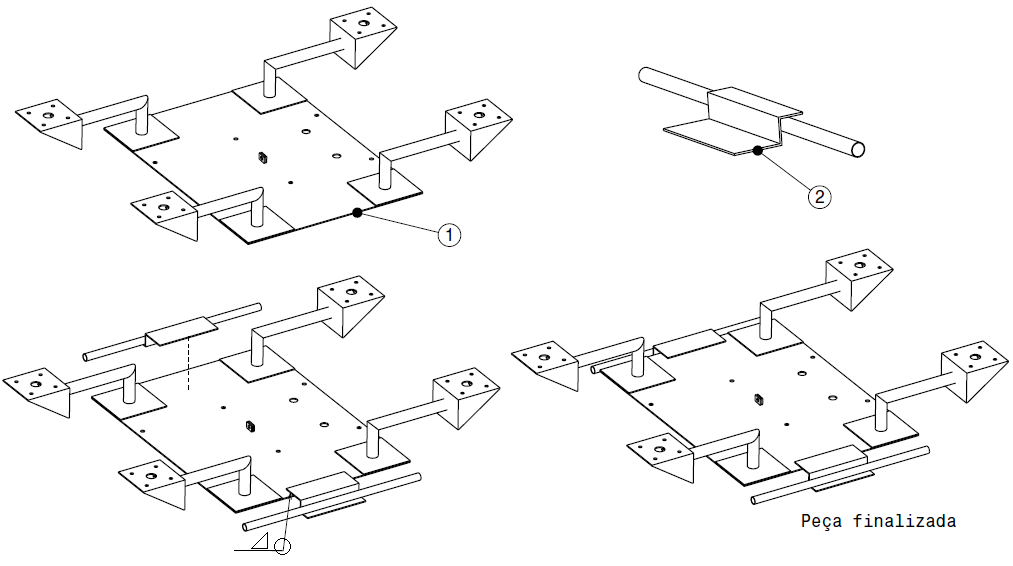
Imagens do manual/28 Chapa central com bracos chapinhas e sup transp.png
