PI2-Grupo-8/Estruturas/Imagens do manual/29 Rolamentos nos bracos de apoio e chapa.png

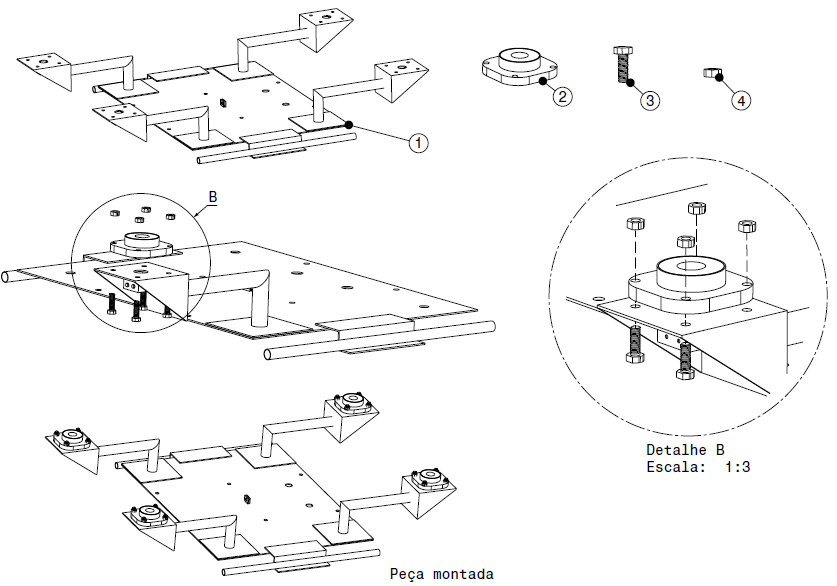
Imagens do manual/29 Rolamentos nos bracos de apoio e chapa.png
