PI2-Grupo-8/Estruturas/Imagens do manual/30 Pecas do braco de apoio.png

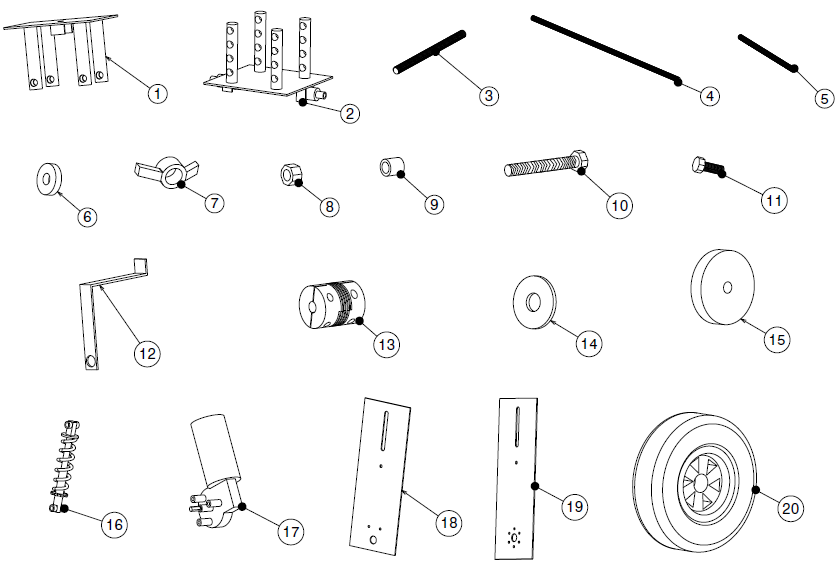
Imagens do manual/30 Pecas do braco de apoio.png
