PI2-Grupo-8/Estruturas/Imagens do manual/31 Braco rotativo lado externo.png

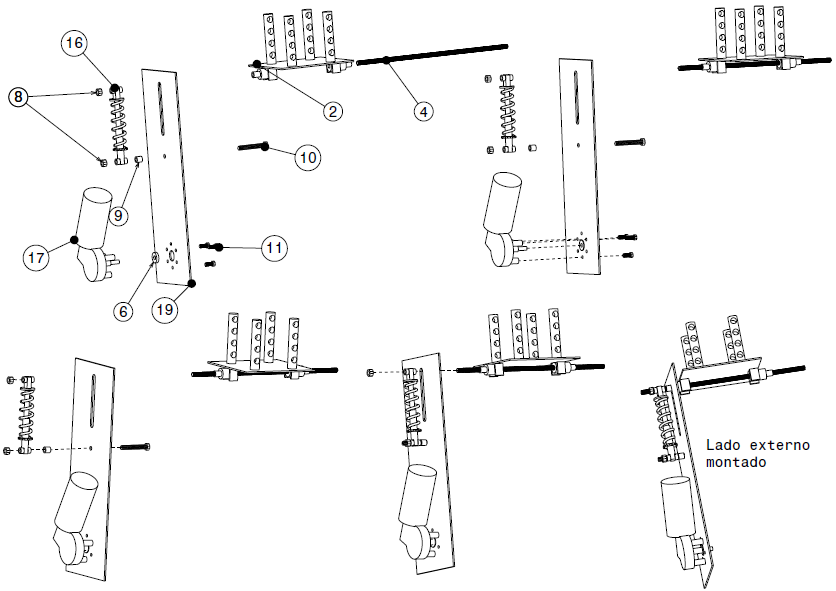
Imagens do manual/31 Braco rotativo lado externo.png
