PI2-Grupo-8/Estruturas/Imagens do manual/32 Conjunto roda pneu e acoplamento.png

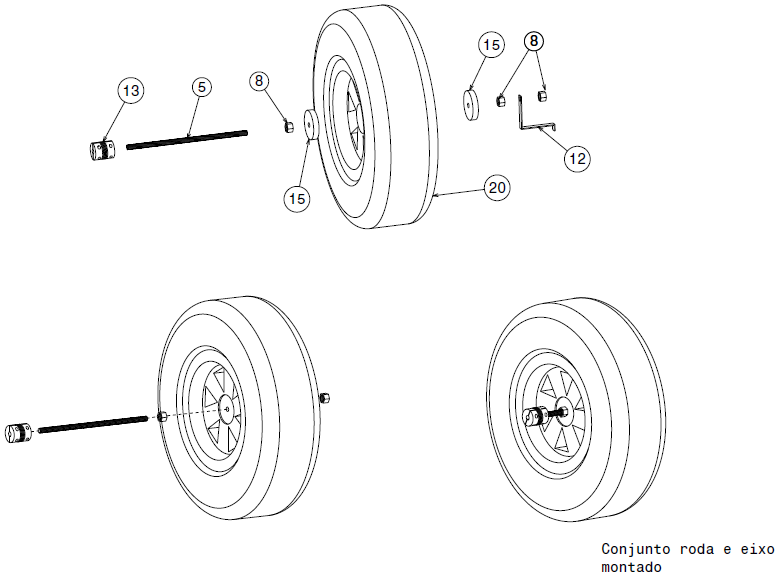
Imagens do manual/32 Conjunto roda pneu e acoplamento.png
