PI2-Grupo-8/Estruturas/Imagens do manual/33 Braco rotativo semi montado.png

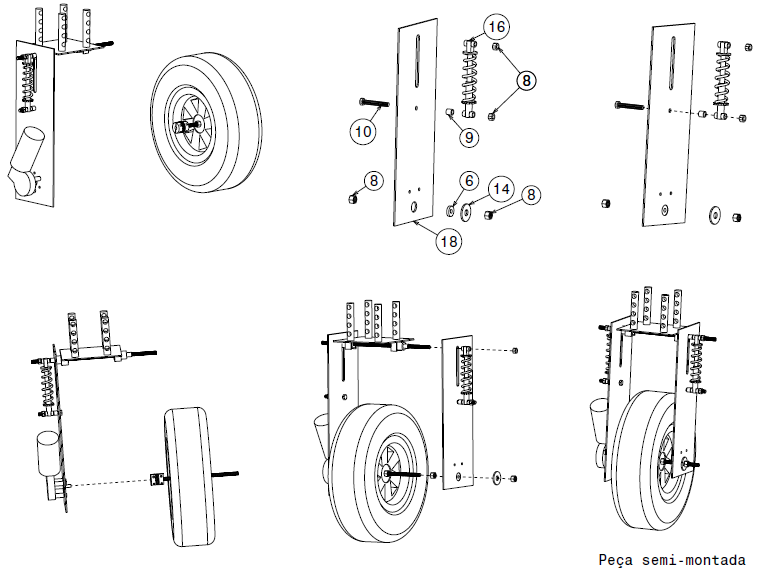
Imagens do manual/33 Braco rotativo semi montado.png
