PI2-Grupo-8/Estruturas/Imagens do manual/34 Braco de apoio rotativo montado.png

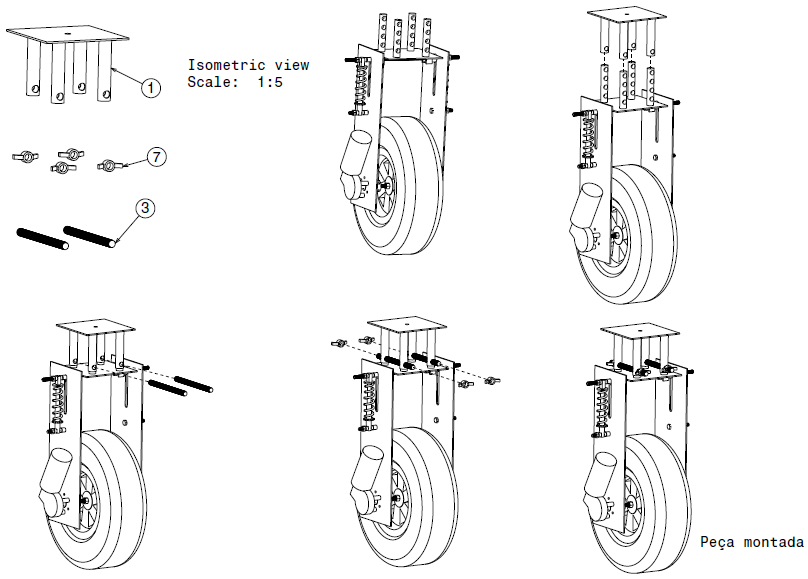
Imagens do manual/34 Braco de apoio rotativo montado.png
