PI2-Grupo-8/Estruturas/Imagens do manual/36 Estrutura base montada.png

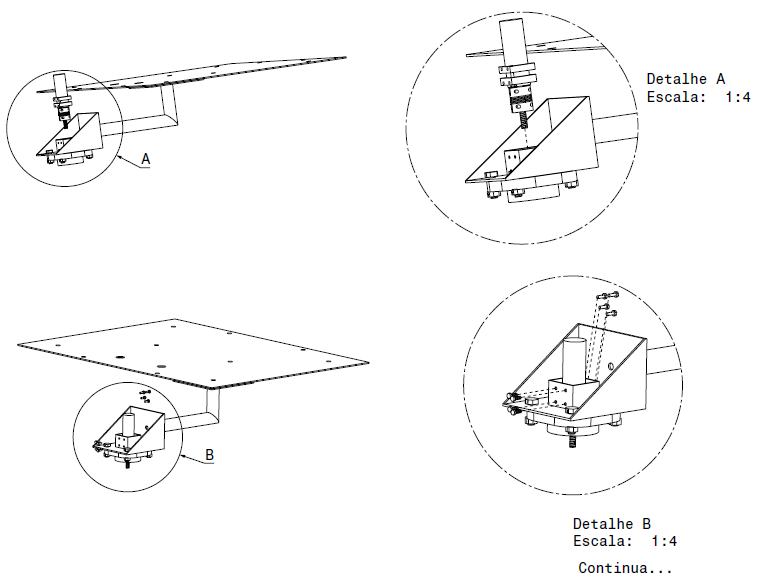
Imagens do manual/36 Estrutura base montada.png
