PI2-Grupo-8/Estruturas/Imagens do manual/38 Suporte do bico aspersor montagem.png

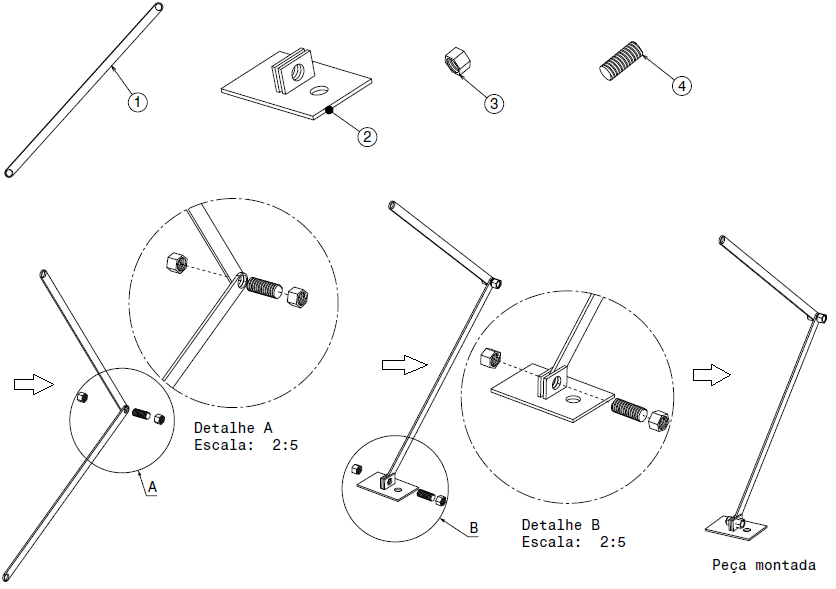
Imagens do manual/38 Suporte do bico aspersor montagem.png
