PI2-Grupo-8/Estruturas/Imagens do manual/39 Estrutura base com o suporte do aspersor.png

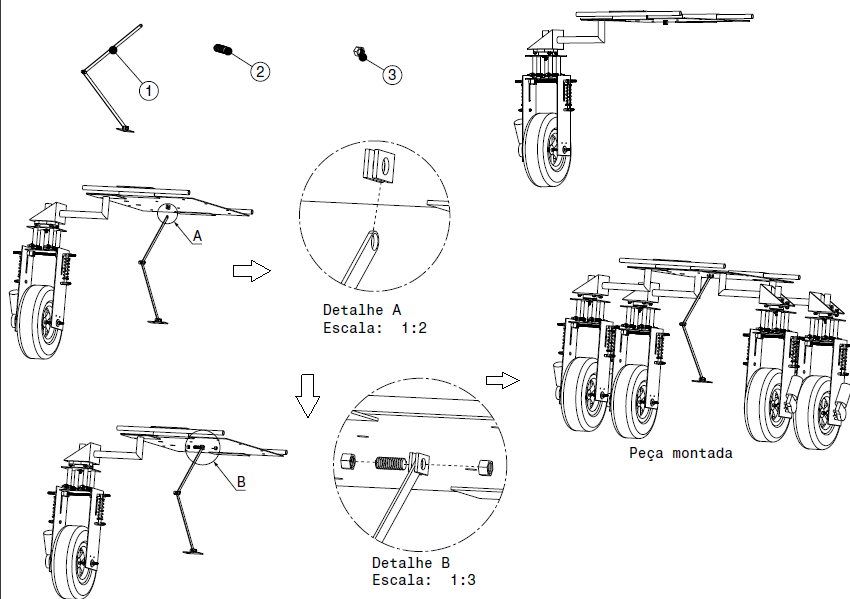
Imagens do manual/39 Estrutura base com o suporte do aspersor.png
