PI2-Grupo-8/Estruturas/Imagens do manual/40 Montagem do sistema hidraulico pt1.png

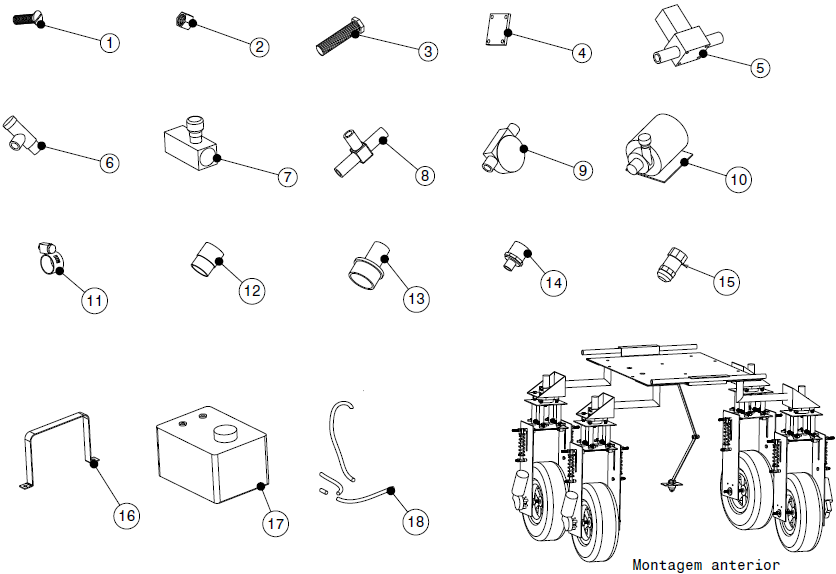
Imagens do manual/40 Montagem do sistema hidraulico pt1.png
