PI2-Grupo-8/Estruturas/Imagens do manual/41 Montagem do sistema hidraulico pt2.png

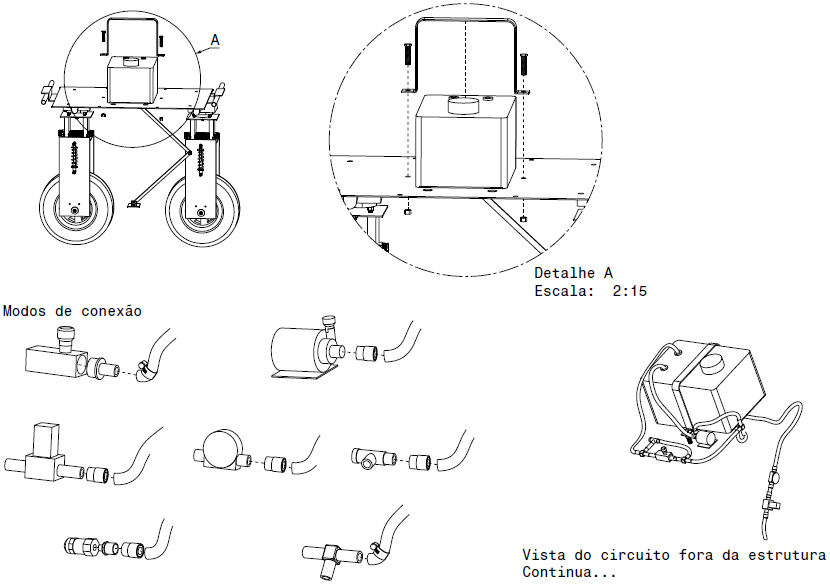
Imagens do manual/41 Montagem do sistema hidraulico pt2.png
