PI2-Grupo-8/Estruturas/Imagens do manual/42 Montagem do sistema hidraulico pt3.png

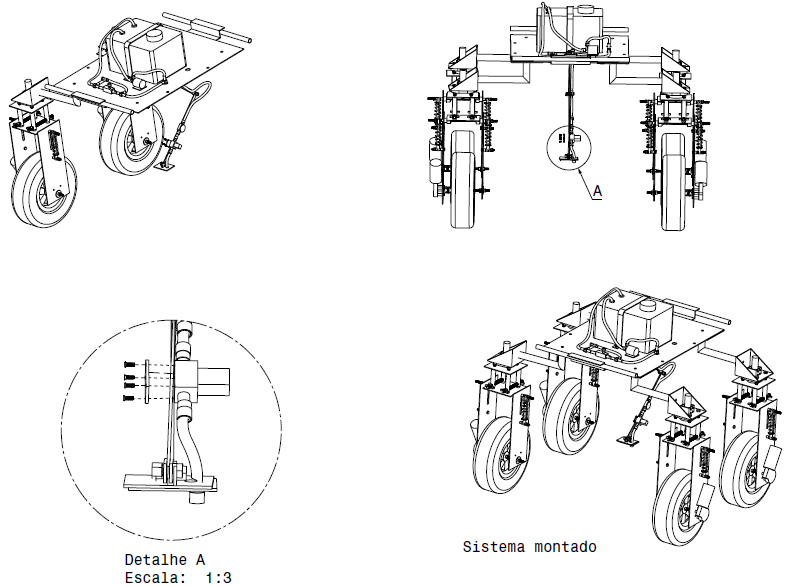
Imagens do manual/42 Montagem do sistema hidraulico pt3.png
