PI2-Grupo-8/Estruturas/Imagens do manual/43 Montagem da case das baterias.png

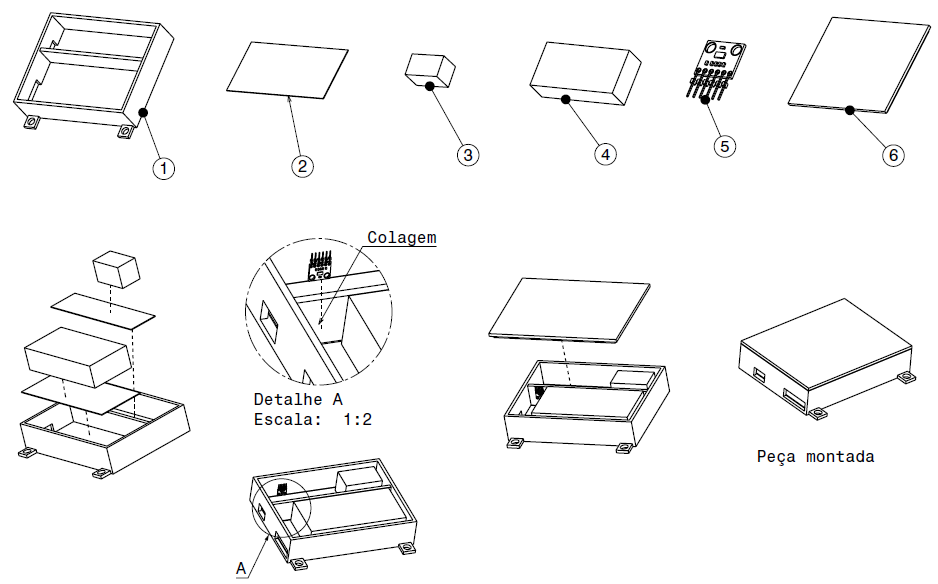
Imagens do manual/43 Montagem da case das baterias.png
