PI2-Grupo-8/Estruturas/Imagens do manual/48 Montagem da camera e seu suporte.png

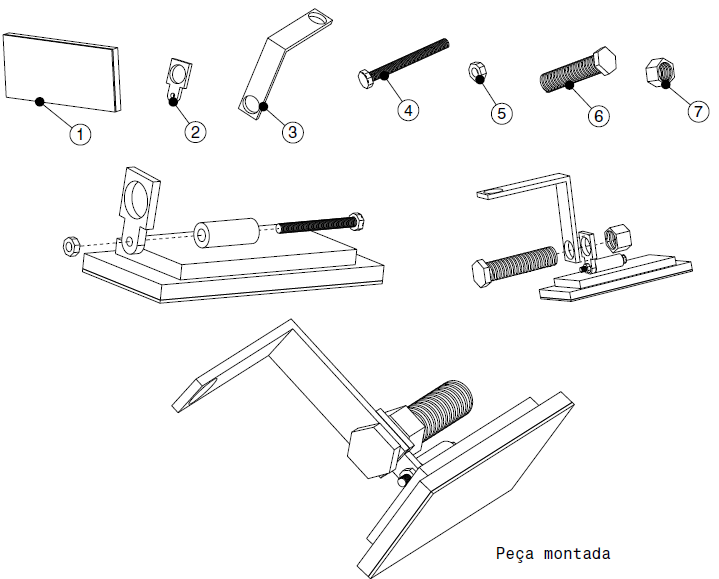
Imagens do manual/48 Montagem da camera e seu suporte.png
