PI2-Grupo-8/Estruturas/Imagens do manual/48 Pecas da montagem dos eletronicos na base.png

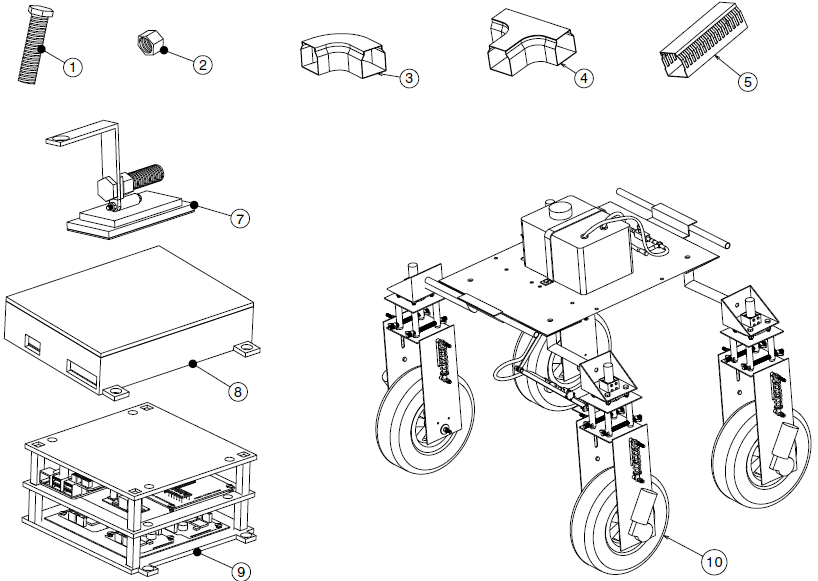
Imagens do manual/48 Pecas da montagem dos eletronicos na base.png
