PI2-Grupo-8/Estruturas/Imagens do manual/50  Montagem dos esletronicoas na estrutura base.png

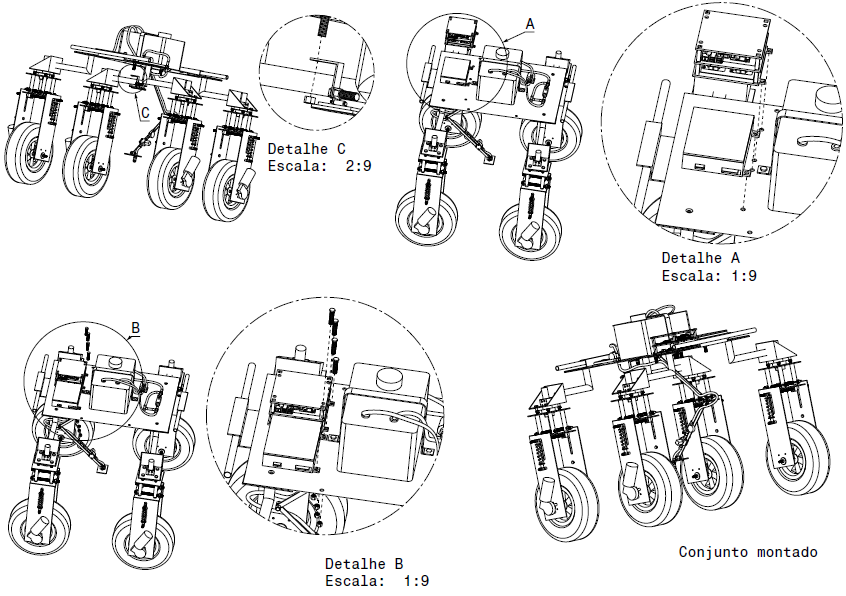
Imagens do manual/50 Montagem dos esletronicoas na estrutura base.png
