PI2-Grupo-8/Estruturas/Imagens do manual/51  M F pecas.png

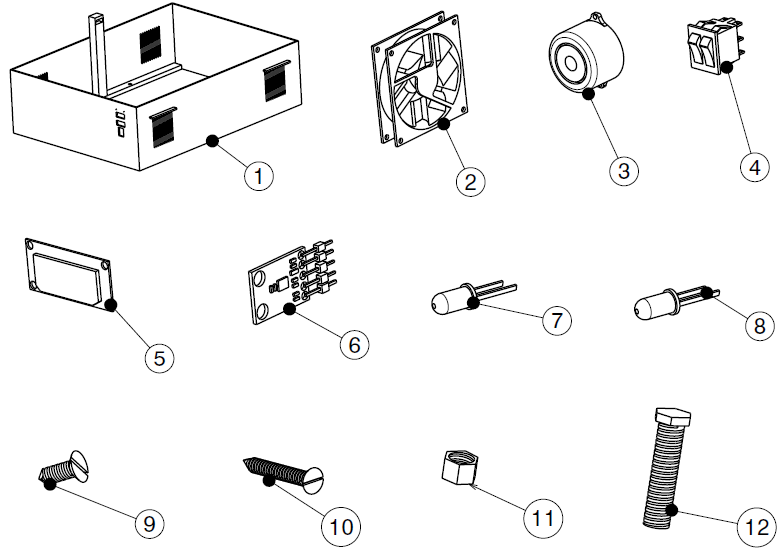
Imagens do manual/51 M F pecas.png
