PI2-Grupo-8/Estruturas/Imagens do manual/58  M F.png

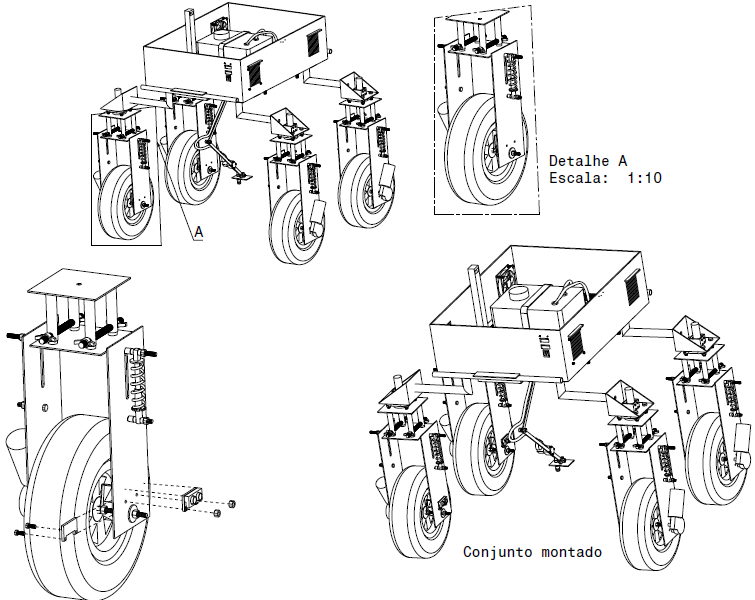
Imagens do manual/58 M F.png
