PI2-Grupo-8/Estruturas/Imagens do manual/60  M F.png

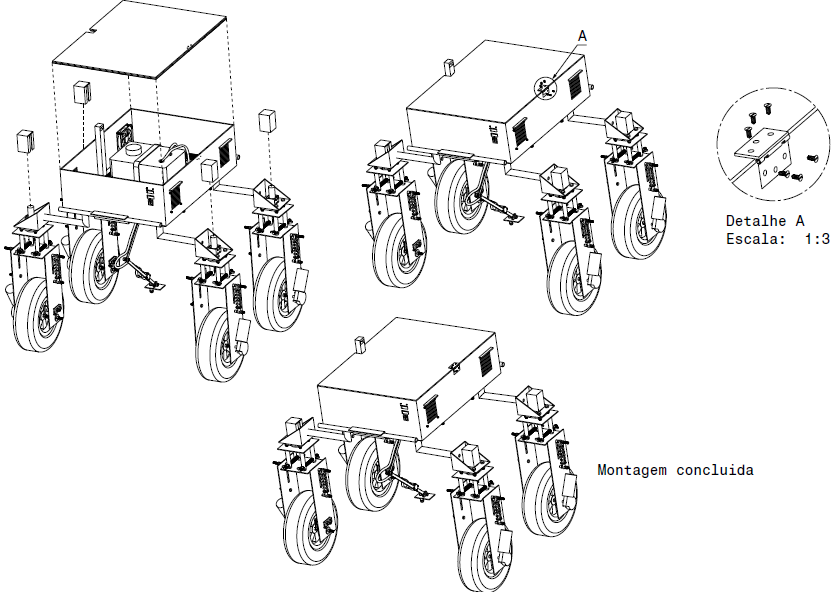
Imagens do manual/60 M F.png
