PI2-Grupo-8/Estruturas/Produção/20- Chapa de fixacão do tanque/Chapa de fixacao do tanque.pdf

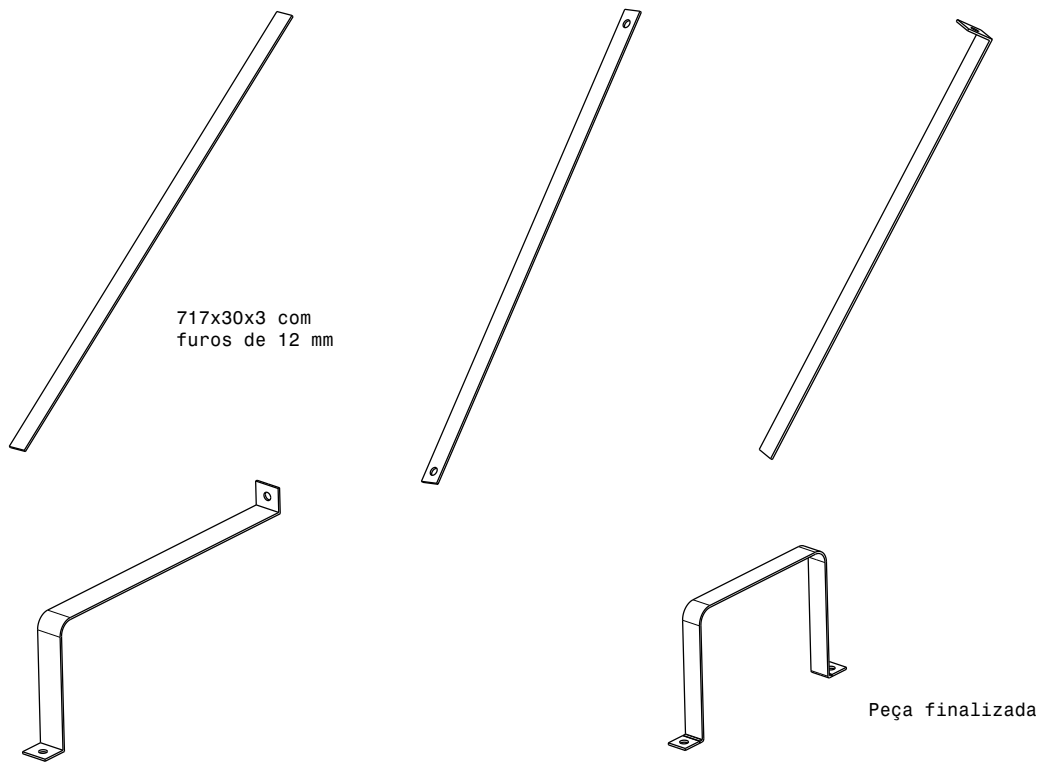
[picture p147: page 1]
Peça finalizada

717x30x3 com
furos de 12 mm
