PI2-Grupo-8/Estruturas/Produção/22- Suporte da camera/Suporte da camera pt1.pdf

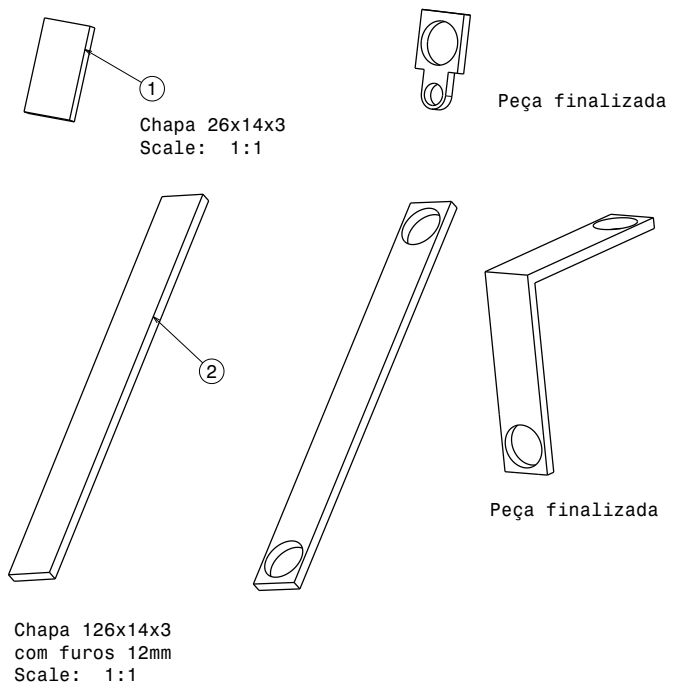
[picture p148: page 1]
Chapa 26x14x3 Scale: 1:1; Peça finalizada; Chapa 126x14x3 com furos 12mm Scale: 1:1
