PI2-Grupo-8/Estruturas/Produção/25 - Chapa para contagem de voltas da roda/Chapa para contagem de voltas da roda.pdf

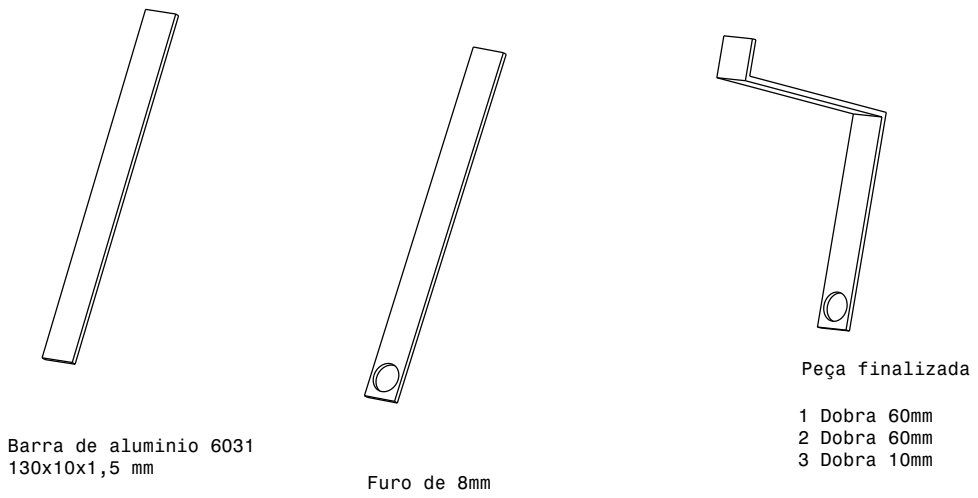
[picture p149: page 1]
Furo de 8mm; Peça finalizada; 1 Dobra 60mm 2 Dobra 60mm 3 Dobra 10mm

Barra de aluminio 6031
