PI2-Grupo-8/Estruturas/Produção/19- Tubo em L/Tubo em L fabricacao.pdf

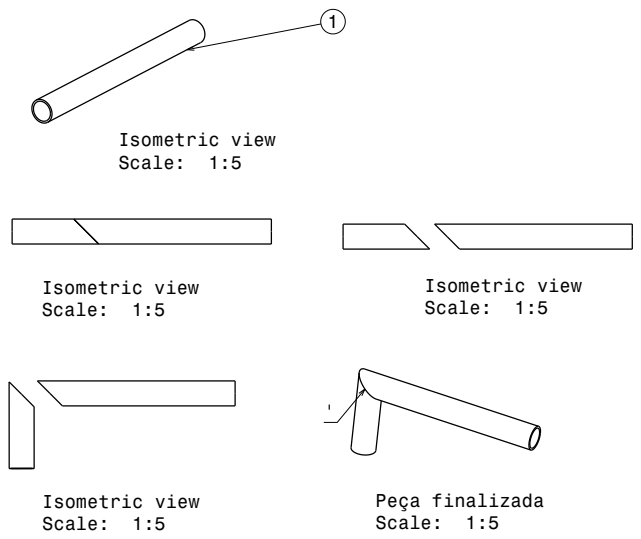
[picture p150: page 1]
Isometric view Scale: 1:5; Peça finalizada Scale: 1:5
