PI2-Grupo-8/Estruturas/Produção/23- Suporte dos componentes eletronicos/Suporte dos componentes eletronicos.pdf

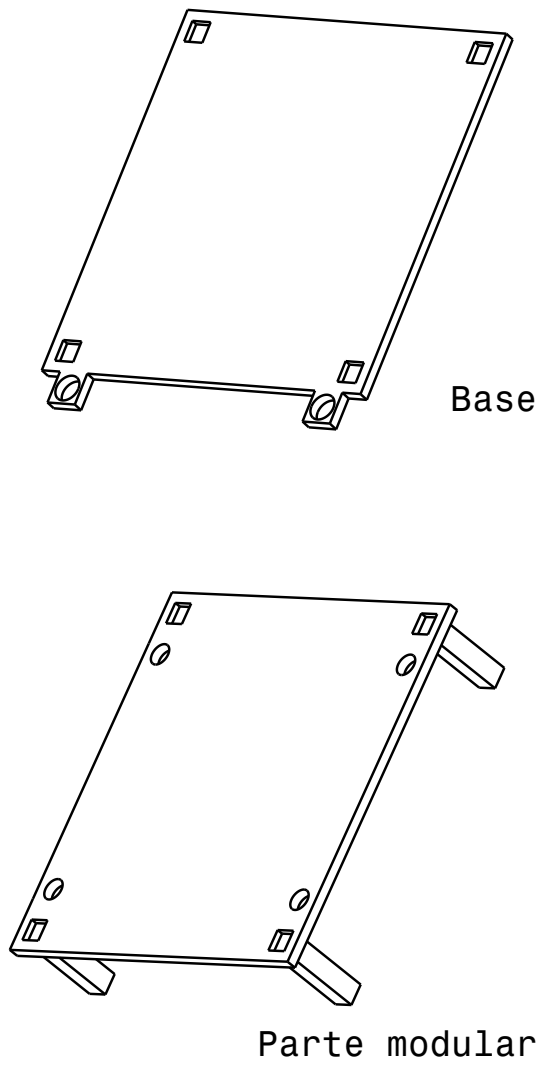
[picture p151: page 1]
Parte modular
