PI2-Grupo-8/Estruturas/Produção/13- Placa de conexão/Placa de conexao fabricacao.pdf

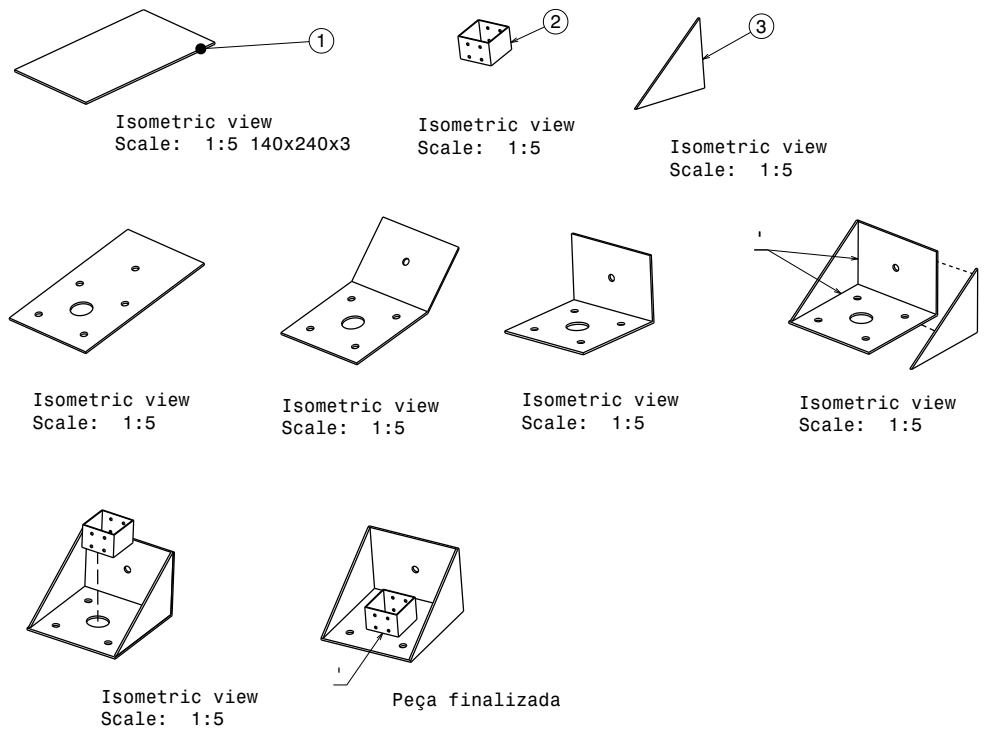
[picture p152: page 1]
Isometric view Scale: 1:5 140x240x3; Isometric view Scale: 1:5; Peça finalizada
