PI2-Grupo-8/Estruturas/Produção/8- Apoio telescopico/Montagem apoio telescopico(base).pdf

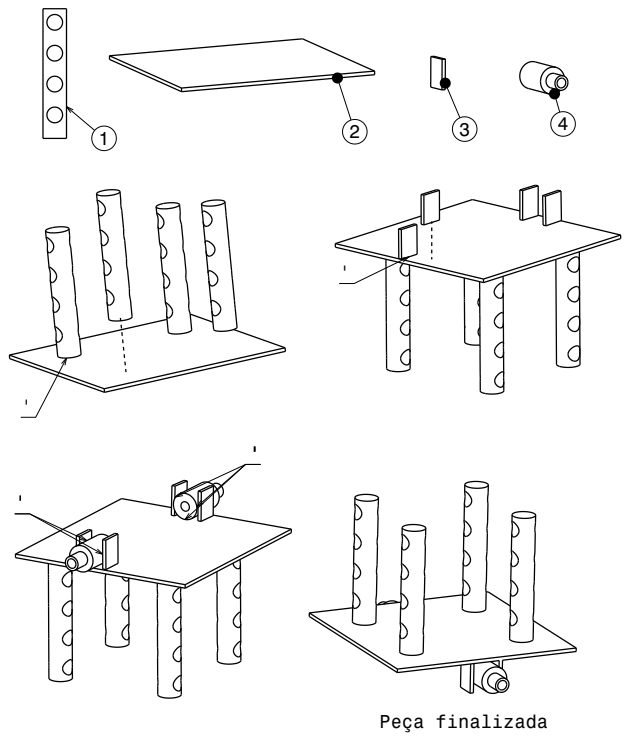
[picture p153: page 1]
Peça finalizada
