PI2-Grupo-8/Estruturas/Produção/9- Espaçador da roda/Espacador da roda montagem.pdf

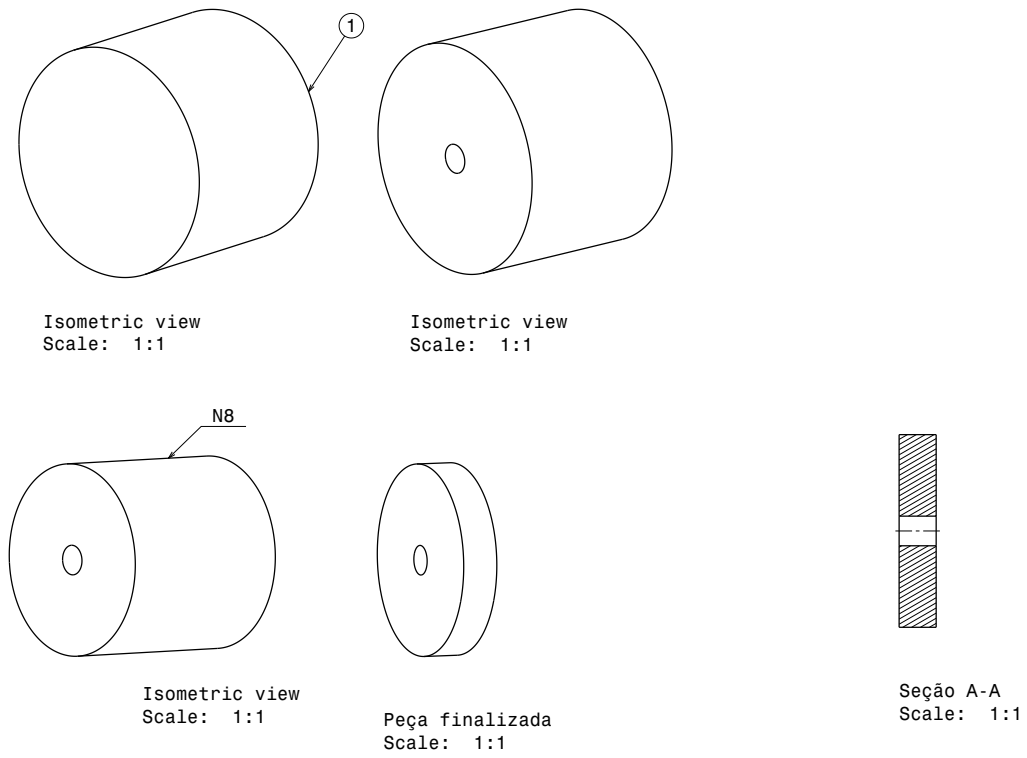
[picture p154: page 1]
Seção A-A Scale: 1:1; Isometric view Scale: 1:1; Peça finalizada Scale: 1:1
