PI2-Grupo-8/Estruturas/Produção/21- Suporte da solenoide/Chapa para a solenoide.pdf

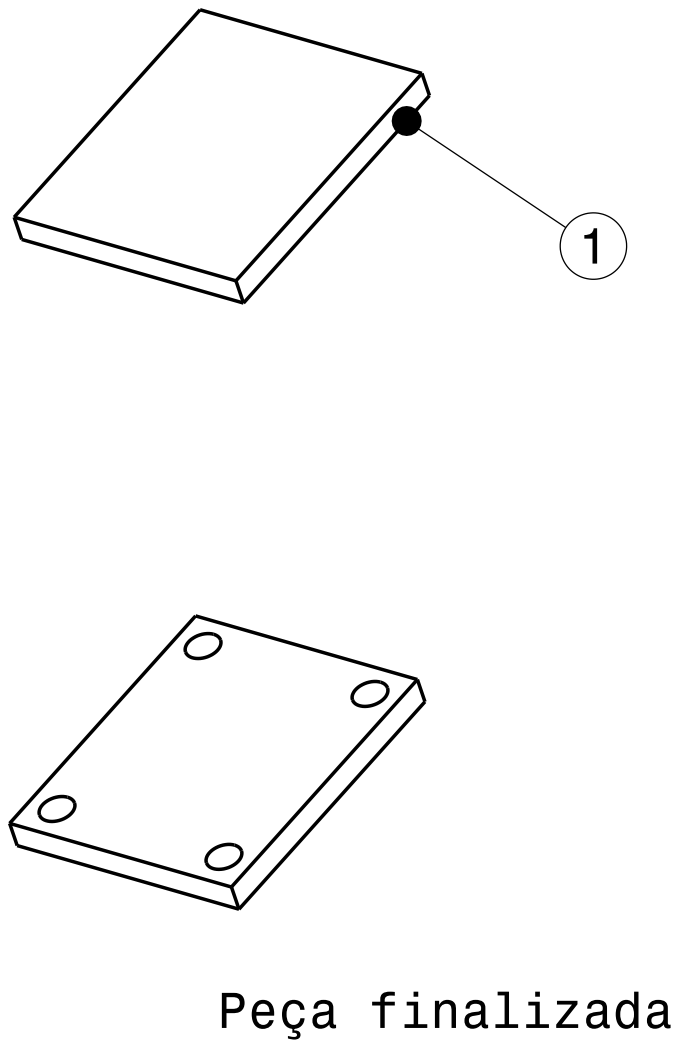
[picture p155: page 1]
Peça finalizada
