PI2-Grupo-8/Estruturas/Produção/24 - Capa de proteção do motor superior/capa do motor superiro.pdf

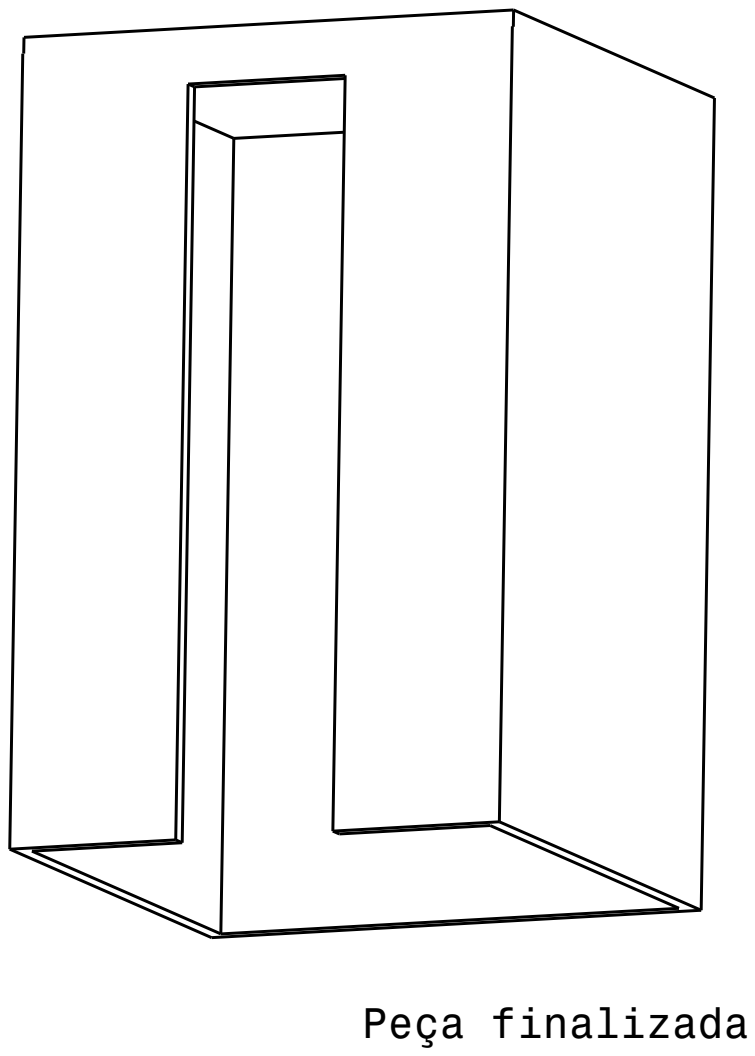
[picture p156: page 1]
Peça finalizada
