PI2-Grupo-8/Estruturas/Produção/14- Placa de conexão tubo L e chapa central/Placa conexao tubo L e chapa central.pdf

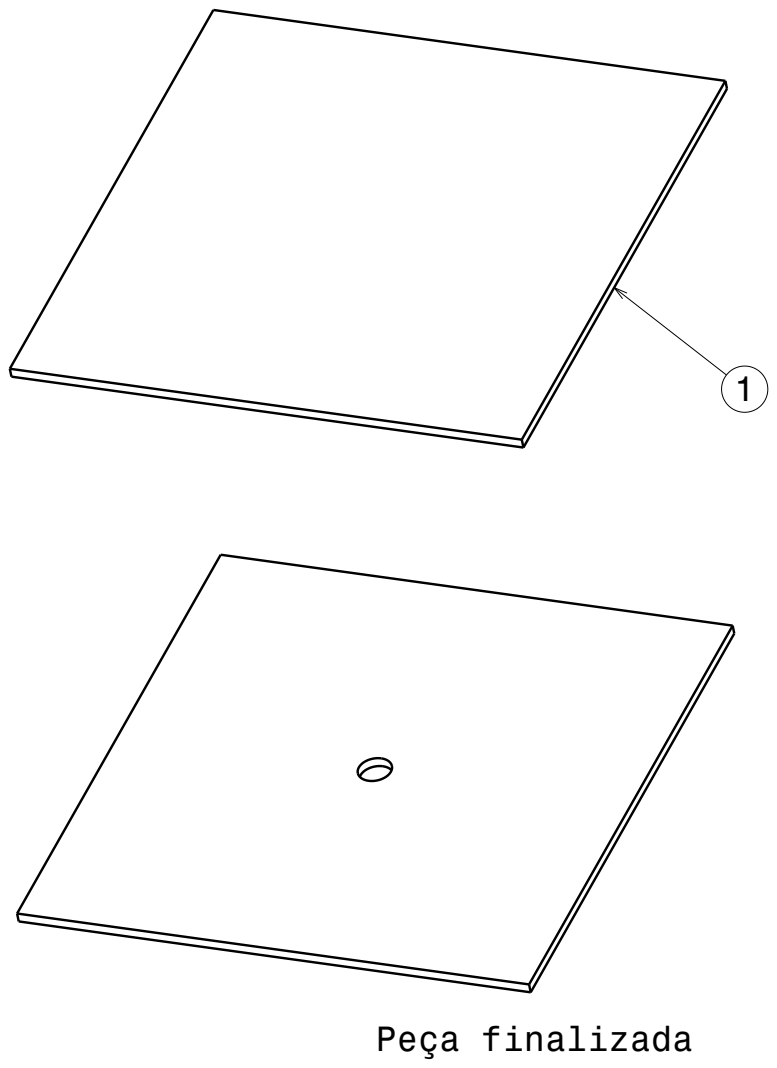
[picture p158: page 1]
Peça finalizada
