PI2-Grupo-8/Estruturas/Produção/15- Placa de suporte do bico aspersor/Placa de suporte do bico aspersor.pdf

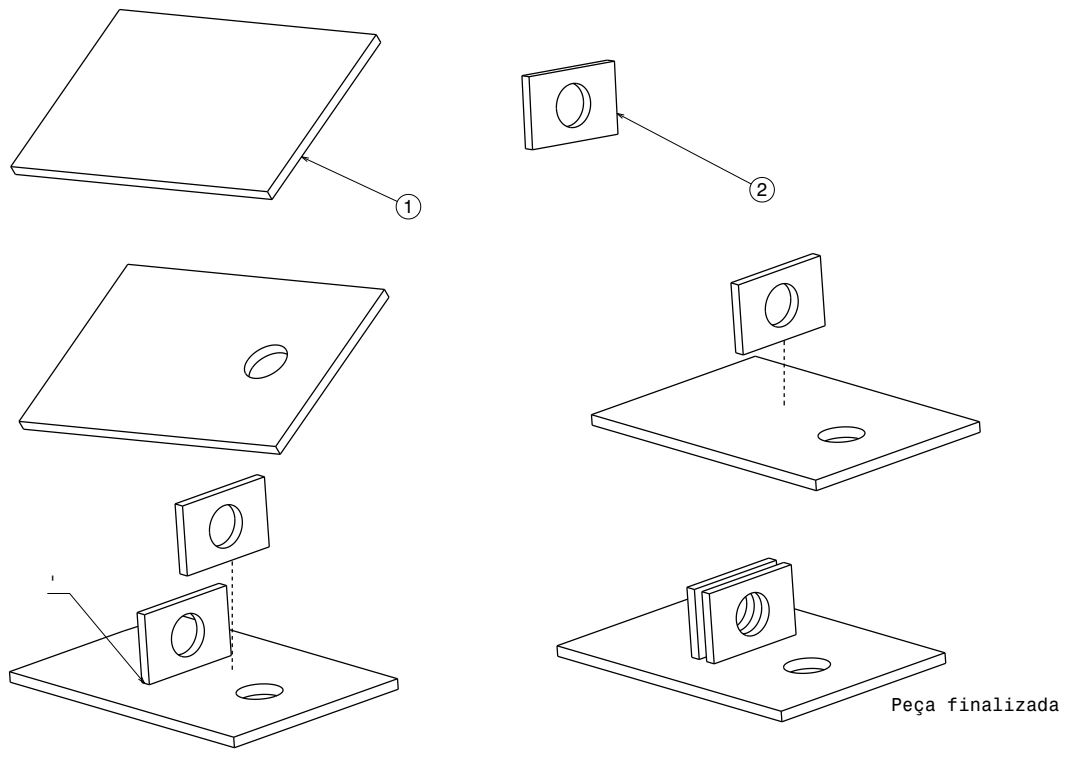
[picture p159: page 1]
Peça finalizada
