PI2-Grupo-8/Estruturas/Produção/16- Suporte de transporte/Suporte de transporte montado.pdf

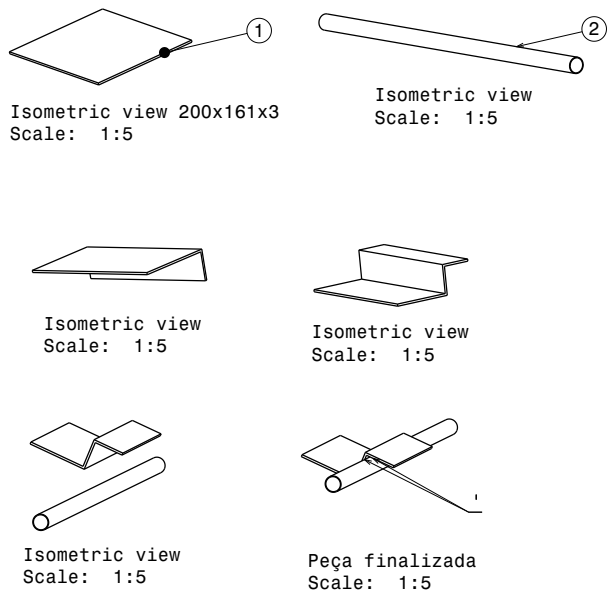
[picture p160: page 1]
Isometric view 200x161x3 Scale: 1:5; Isometric view Scale: 1:5; Peça finalizada Scale: 1:5
