PI2-Grupo-8/Estruturas/Produção/17- Suporte externo/Suporte do motor e roda (externo).pdf

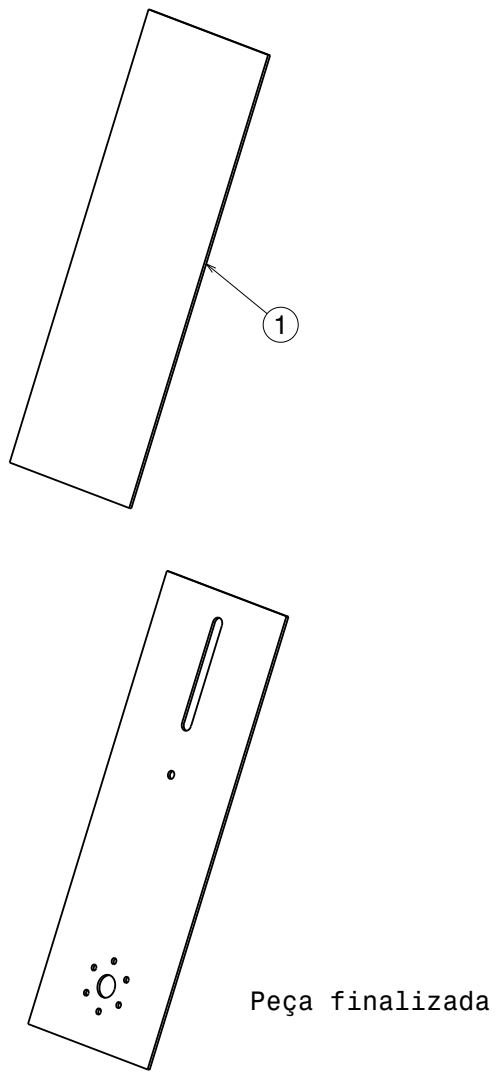
[picture p161: page 1]
Peça finalizada
