PI2-Grupo-8/Estruturas/Produção/18- Suporte interno/Suporte da roda (interno).pdf

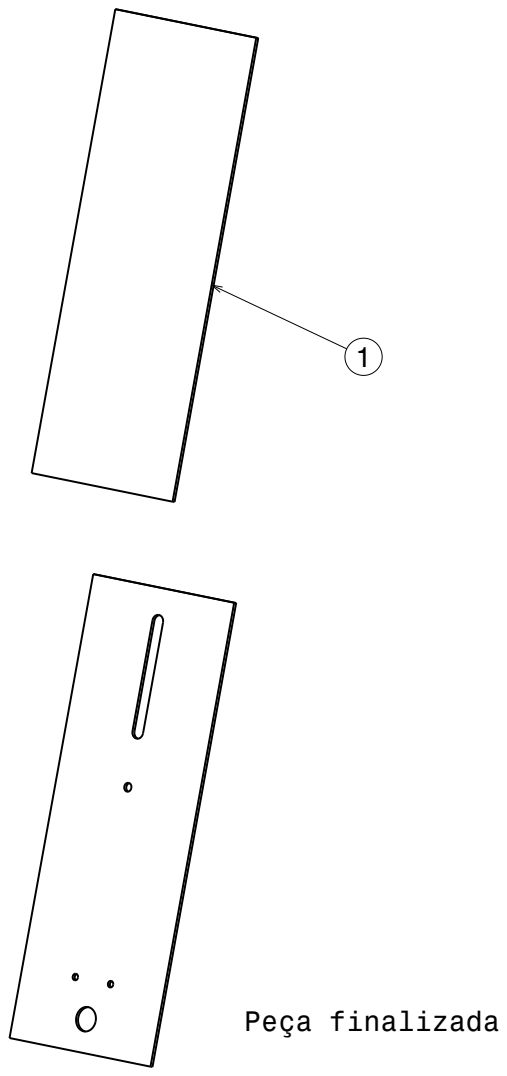
[picture p162: page 1]
Peça finalizada
