PI2-Grupo-8/Estruturas/Produção/10- Chapinhas para o suporte do aspersor/Chapinhas para o suporte do aspersor.pdf

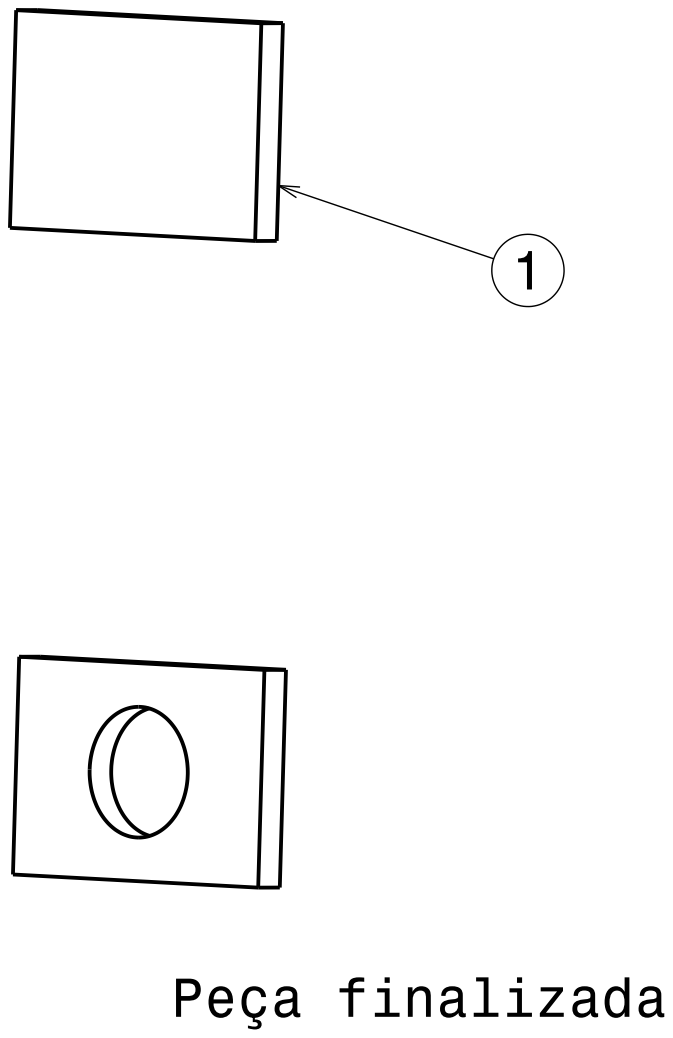
[picture p163: page 1]
Peça finalizada
