PI2-Grupo-8/Estruturas/Produção/11- Haste do suporte do aspersor/Haste do aspersor.pdf

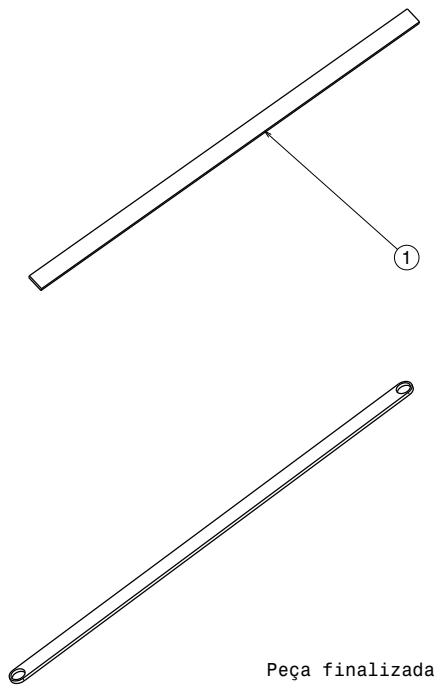
[picture p164: page 1]
Peça finalizada
