PI2-Grupo-8/Estruturas/Produção/6- Apoio telescópico (parte superior)/Apoio telescopico (parte superior).pdf

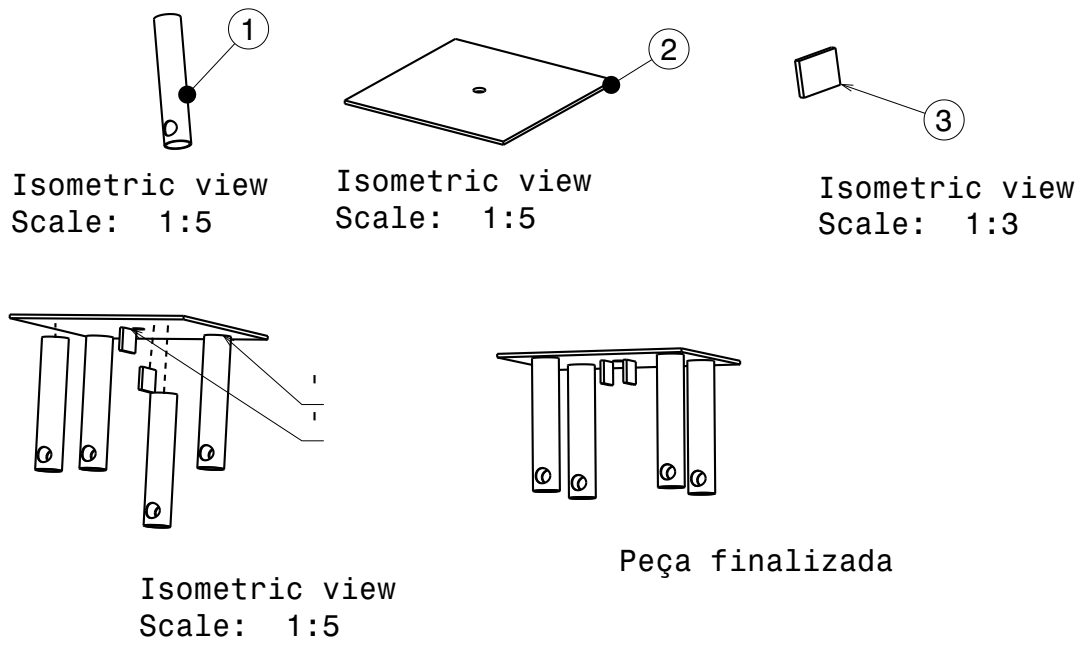
[picture p165: page 1]
Isometric view Scale: 1:5; Isometric view Scale: 1:3; Peça finalizada
