PI2-Grupo-8/Estruturas/Produção/7- Suporte e espaçador do amortecedor/Suporte de fixacao do amortecedor e espacador do amortecedor.pdf

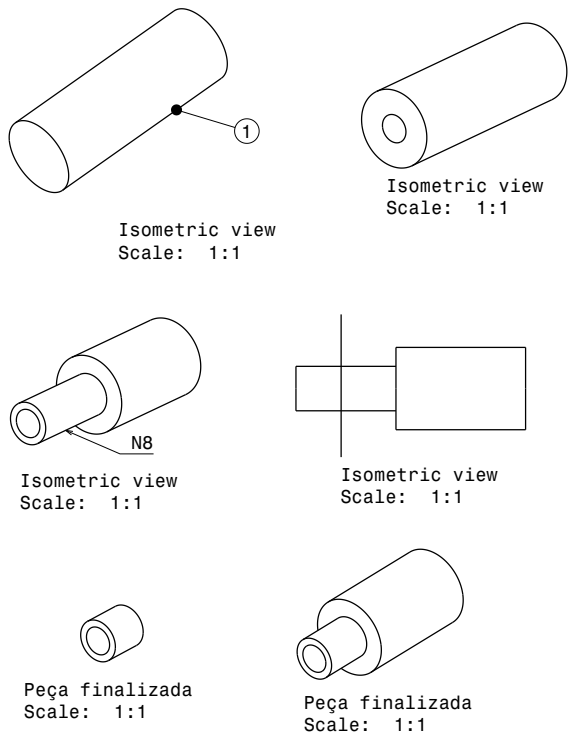
[picture p166: page 1]
Isometric view Scale: 1:1; Peça finalizada Scale: 1:1
