PI2-Grupo-8/Estruturas/Produção/1- Capa de proteção/Capa de protecao.pdf

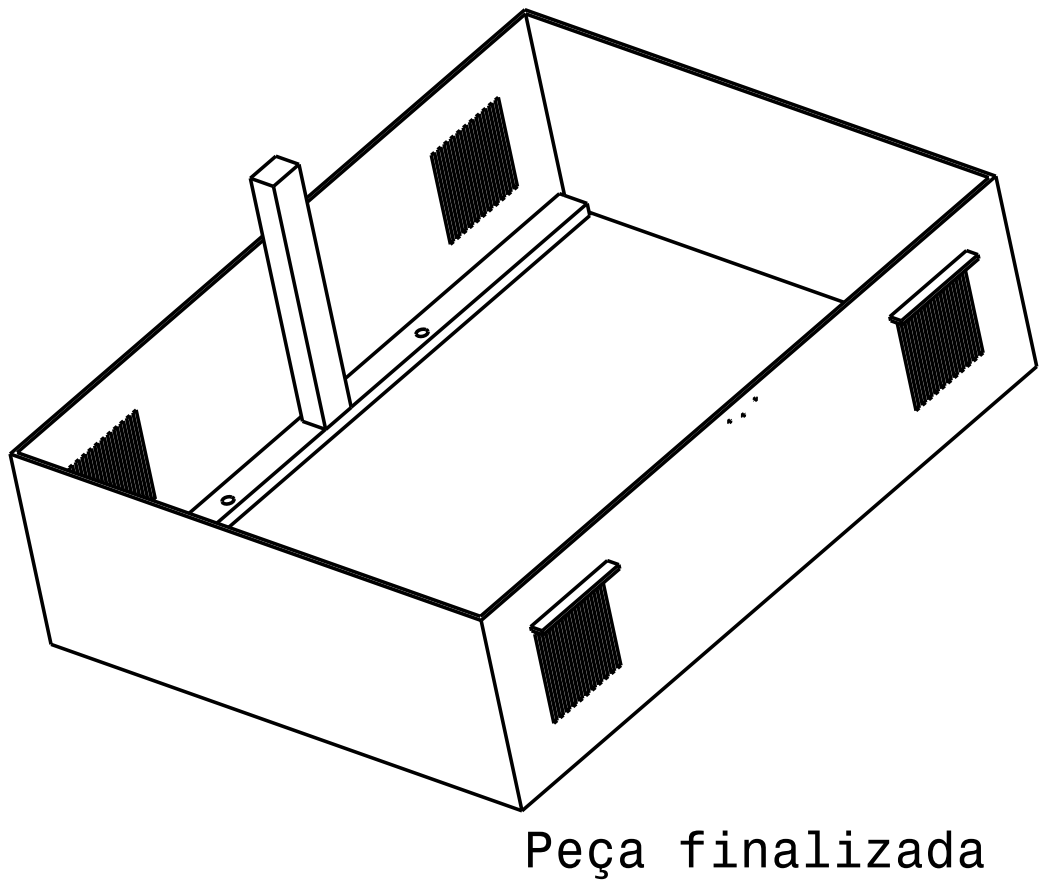
[picture p167: page 1]
Peça finalizada
