PI2-Grupo-8/Estruturas/Produção/2- Tampa da caixa/Tampa da capa protetora.pdf

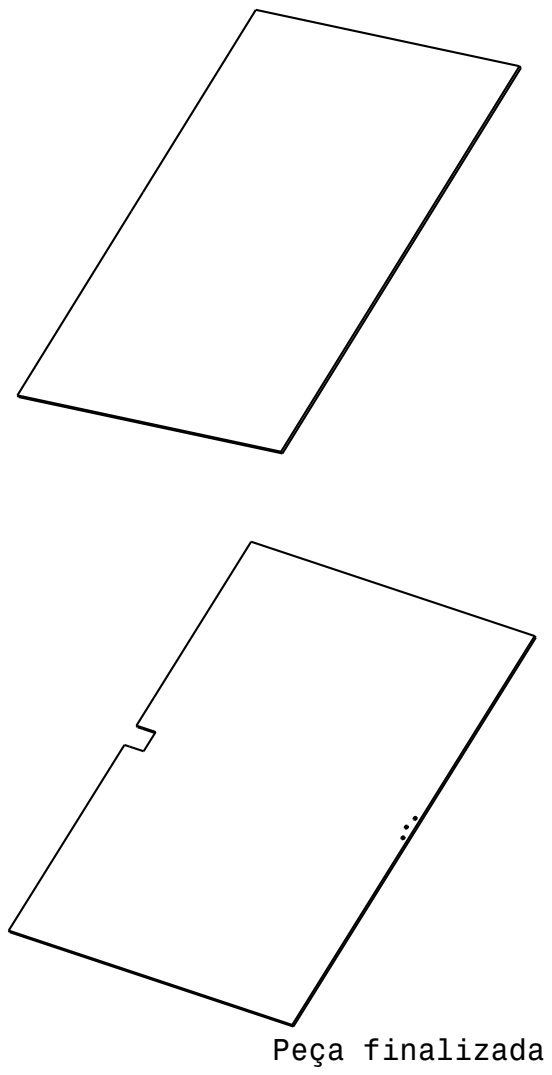
[picture p168: page 1]
Peça finalizada
