PI2-Grupo-8/Estruturas/Produção/3- Capa do sensor ultrassonico/Capa do sensor ultrassonico (base e tampa).pdf

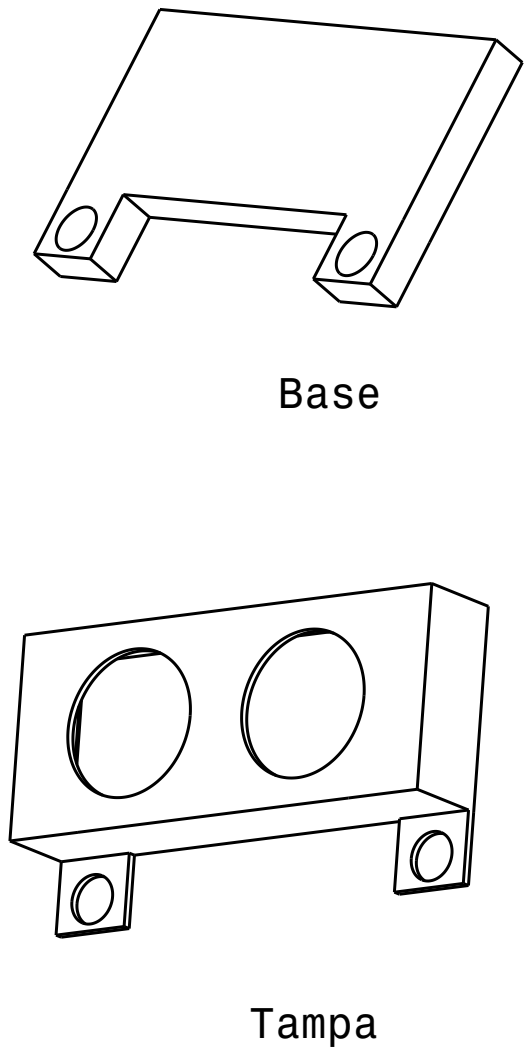
[picture p169: page 1]
