PI2-Grupo-8/Estruturas/Produção/4- Case das baterias/Case das baterias (base e tampa).pdf

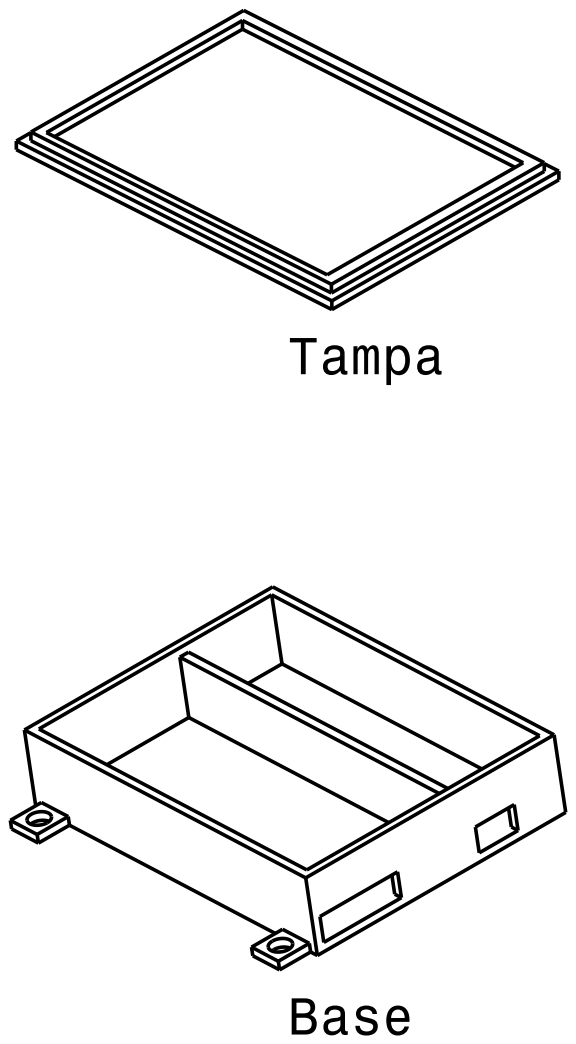
[picture p170: page 1]
