PI2-Grupo-8/Estruturas/Produção/5- Chapa central/Chapa central.pdf

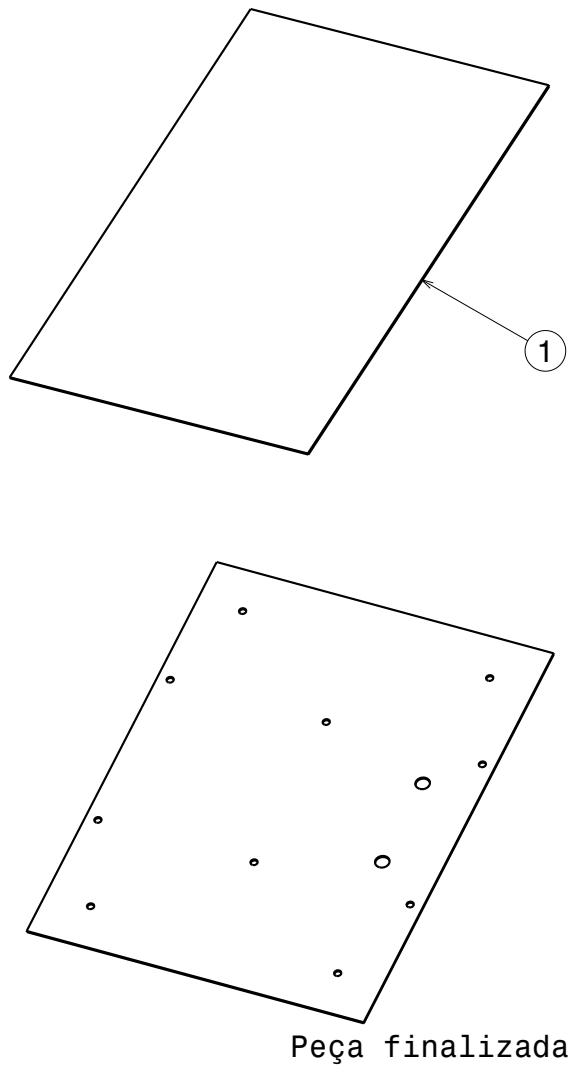
[picture p171: page 1]
Peça finalizada
