PI2-Grupo-8/Estruturas/(commit log)

2021-10-16 adding production manual files
    [Acoplamento de eixo (12 p_ 12).CATPart, Acoplamento de eixo (8 p_ 12).CATPart, Amortecedor.CATPart, Apoio telescopico.CATPart, Arruela funileiro .CATPart, Arruela lisa de aba larga .CATPart, Barra regulagem altura.CATPart, Barra roscada do aspersor.CATPart]
2021-10-16 adding files used to structural simulations
    [Caixa central Montada(simulacao)(1).igs, Caixa central Montada(simulacao)(2).igs, Caixa central Montada(simulacao)(3).igs, Caixa central Montada(simulacao).CATProduct, Caixa central Montada(simulacao).igs, Capa protetora.CATPart, Capa protetora.igs, Carcaca.CATPart]
2021-10-16 adding cad files
    [Acoplamento de eixo (12 p_ 12).CATPart, Acoplamento de eixo (8 p_ 12).CATPart, Amortecedor.CATPart, Apoio telescopico.CATPart, Arruela funileiro .CATPart, Arruela lisa de aba larga .CATPart, Barra regulagem altura.CATPart, Barra roscada do aspersor.CATPart]
2021-10-16 adding assembly cad files
    [0- MONTAGEM FINAL ABRIR ESSE AQUI.CATProduct, Braco de apoio completo Montado Teste.CATProduct, Braco rotativo completo (montado) teste.CATProduct, Camera com suporte .CATProduct, Canaletas.CATProduct, Case das baterias montagem.CATProduct, Chapa e bracos de apoio (superiro) com chapinhas.CATProduct, Chapa e bracos de apoio (superiro).CATProduct]
2021-10-17 adding manufacture and assembly manual
2021-11-03 Manual de usuário
